rckTom/alturia-launch-control/firmware/lora_bench/README.md

# LoRa bench test

Ping/pong between two Heltec WiFi LoRa 32 V4 boards, to bring up the LoRa
backend in [`../common/lora/`](../common/lora/) before the satellite
hardware exists, and to run the secure link between a controller and a
satellite over the air (see [below](#secure-link-one-controller-one-satellite)).

Both boards run the same image. A board listens and answers every PING
with a PONG that carries the RSSI/SNR it heard the PING at. The pinging
board logs the round-trip time and the signal in both directions.

## Building and flashing

Zephyr has no V4 board, so this builds for the V3 and
[`boards/heltec_wifi_lora32_v3_esp32s3_procpu.overlay`](boards/heltec_wifi_lora32_v3_esp32s3_procpu.overlay)
adds what the V4 changes: the console on the native USB port, and the
RF front-end's control pins.

```sh
source ~/zephyrproject/venv/bin/activate
export ZEPHYR_BASE=~/zephyrproject/zephyr
west build -b heltec_wifi_lora32_v3/esp32s3/procpu -p always .
west flash --esp-device /dev/ttyACMx
```

The console and shell are on the same USB-C port, at any baud rate.

## Using it

Press **PRG** on one board to send 10 pings, 2 s apart; press it again to
stop. Or from the shell:

| Command | |
|---|---|
| `bench info` | Node id, frequency, SF, TX power, airtime |
| `bench ping [count] [interval_ms]` | Start a ping run (default 10, 2000 ms) |
| `bench stop` | End the run |
| `bench power [dBm]` | Show or set TX power at the antenna, up to 7 dBm |

A successful run looks like:

```
<inf> bench: ping 3: pong from 079c in 342 ms, there -41 dBm/10 dB, back -43 dBm/9 dB
```

"There" is the PING as heard by the other board, "back" is its PONG as
heard here. The white LED flashes on every transmission.

0 dBm is the most the SX1262 can report. Two boards on one desk read
exactly that, because the V4's LNA puts them well past it, and the V4
can't transmit below about 2 dBm. For a real reading, put the boards at
least a few metres apart with a wall between them, or take them outside.

The same is on the OLED, so the boards can be tested away from a laptop:

```
079c  KCT8103L (V4.3)      node id, detected front-end
869.850 SF7 +7dBm          radio settings
RX ping #12 from 3a41      last packet heard
  -45dBm 9dB  3s ago
PING 7/10  ok 6            ping run: sent/total, answered
  there -41dBm  9dB        last answered ping, both directions
  back  -43dBm 10dB
  rtt 342ms
```

If bring-up fails, the display shows which step and the error code. The
5x8 font is converted from X11's public-domain misc-fixed `5x8.bdf` by
[`tools/bdf_to_cfb.py`](tools/bdf_to_cfb.py); the built-in CFB fonts are
too large for more than four lines.

Keep the boards a metre or so apart. At short range the V4's LNA can push
the SX1262 input into compression, which shows up as lost packets with
good RSSI.

## Secure link: one controller, one satellite

The same image can also run either end of the real link, the code the
controller and satellite firmware use
([`../common/link/`](../common/link/), spec in
[`documentation/radio_link.md`](../../documentation/radio_link.md)). Give each
board a role once; it is kept in flash and the board reboots into it:

```
bench role ctrl      # on one board
bench role sat       # on the other; "bench role off" goes back to ping/pong
```

Changing the role erases the pairing. Then:

1. **Pair.** Hold **PRG** for a second on the satellite (pairing mode, 120 s),
   then on the controller (it pairs with the first satellite it hears).
   Both OLEDs show four rows of six boxes. If they are the same, press
   **PRG** on each board; if not, hold it. The log has the pattern too.
   Both switch to SF8 at low power while pairing. The satellite goes into
   slot 8, the last, so that `bench poll` can put phantom satellites
   ahead of it.
2. **Join.** Automatic, and again after either board reboots. The status
   line reads `link: joined`. From then on the controller polls the
   satellite twice a second, as the real controller does, and the
   satellite answers in its slot; that keeps the session up.
3. **Ping.** Press **PRG** on the controller, or `bench ping`. Odd pings go
   to the satellite alone, even ones as group broadcasts; the satellite
   answers each with a sealed pong.
4. **Poll.** `bench poll` sends polls and reports where each reply ends,
   counted from the end of the poll, against its slot. Phantoms are
   satellites that are not there, set in the mask ahead of ours to move
   our reply to a later slot.

| Command | |
|---|---|
| `bench role [off\|ctrl\|sat]` | Show or set the role (reboots) |
| `bench pair [uid] [slot]` | Satellite: pairing mode. Controller: pair with `uid` (0: the first one heard) into `slot` (default 8) |
| `bench scan [on\|off]` | Controller: log satellites in pairing mode |
| `bench confirm` / `bench reject` | The patterns match / differ (or cancel) |
| `bench unpair` | Forget the pairing |
| `bench replay` | Resend the last sealed DATA frame byte for byte, as an attacker would |
| `bench link` | Link state and why received frames were dropped |
| `bench ping`, `bench stop` | Sealed ping run |
| `bench poll [count] [interval_ms] [phantom_mask] [reply_len]` | Controller: polls, and where the replies land in their slots (default 20 every 250 ms) |
| `bench lbt` | Noise floor, busy threshold and the listen-before-talk counters |
| `bench jam <ms>` | Raw 255-byte frames back to back, without listening first |
| `bench jam slot [on\|off]` | Controller: a 200 ms raw frame right after each poll, to see the satellite skip a busy slot |
| `bench trace [off\|on\|hex]` | Log every frame sent and received, decoded; `hex` adds a dump |

`bench trace on` shows each frame's kind and clear header. Sealed
bodies stay encrypted, so a DATA frame shows only its key id and
counter:

```
<inf> trace: tx POLL         0 -> ff  net 33db kid 0 ctr 13, 33 B, sent in 50.9 ms
<inf> trace: rx DATA         8 -> 0   net 33db kid 0 ctr 14, 31 B, 0 dBm 13 dB, +45.7 ms
<inf> trace: rx HELLO        8 -> 0   net 33db, 5 B, -45 dBm 9 dB
<inf> trace: lbt busy: 0 dBm, floor -76 dBm
```

Address 0 is the controller, `ff` the group, and anything else a
satellite's slot. The last field is the time since the last poll, which
is where the reply slots count from; "sent in" is how long the send
blocked, airtime included. "lbt busy" lines are listens that found
someone on the air. Frames that fail the PHY CRC never reach the trace.

What to expect, with a 13-byte pong (31 B sealed, 36 ms on air, 43 ms
slots):

| Command | Result on the bench |
|---|---|
| `bench poll 50 250` | every reply ends at +45.7 to +46.4 ms, inside its slot (6–49 ms) |
| `bench poll 40 300 0x07` | slot 3 of 4: +174.8 to +175.3 ms |
| `bench poll 30 500 0x7f` | slot 7 of 8: +347.0 to +347.3 ms |
| `bench jam slot on`, then `bench poll 10 500 0x07` | no replies; the satellite's `bench lbt` counts every slot skipped busy |
| `bench jam 7000` on the satellite | the controller sends anyway after 50 ms of busy channel; it drops the session after 4 s, the satellite after 5 s; both rejoin as soon as the jam ends |

The first slot cannot be jammed this way: the jam starts a few ms after
the poll, after the satellite has listened.

Things worth trying: `bench replay` on the controller must count as
`replay` on the satellite and not answer; `bench unpair` on the satellite
must turn the controller's pings into drops there; a third board in
pairing mode shows a different pattern and must be rejected.

## Radio settings

Set in [`../common/lora/radio.c`](../common/lora/radio.c): 869.85 MHz,
SF7, 250 kHz, CR 4/5, 7 dBm at the antenna. 869.85 MHz is the centre of
the EU 869.70–870.00 MHz sub-band, which has no duty-cycle limit but
allows only 5 mW ERP, so `radio_set_tx_power()` caps the power at 7 dBm.
That assumes an antenna of at most 2.15 dBi; lower the cap by any gain
above that. Pairing uses SF8 at 0 dBm, so the two profiles don't hear
each other.

The radio runs on Zephyr's native SX126x driver, kept in standby between
operations (`CONFIG_LORA_MODULE_BACKEND_NATIVE`,
`CONFIG_LORA_SX126X_NATIVE_SLEEP=n`). With loramac-node, which sleeps the
chip after every call, each send took some 40 ms beyond its airtime, with
enough jitter to push replies out of their slots. The kernel runs at
10 000 ticks a second for the same reason.

At SF7 and 250 kHz a 22-byte sealed command is about 28 ms on air and a
63-byte status about 59 ms. Sensitivity is about −121 dBm, which leaves
roughly 20 dB of margin at 200 m with both antennas near the ground.

## The V4's RF front-end

The V4 puts a PA/LNA between the SX1262 and the antenna, and the part
depends on the board revision:

| Revision | Front-end | Pin driven high during TX | Net TX gain |
|---|---|---|---|
| V4.2 | GC1109 | IO46 (CPS, PA on) | ~11 dB |
| V4.3 | KCT8103L | IO5 (CTX) | ~13 dB |

On both, IO7 powers the front-end and IO2 enables it; DIO2 on the SX1262
switches the other TX/RX line itself. The firmware tells the revisions
apart at boot by the pull on IO2 and logs which one it found.
`radio_set_tx_power()` takes the power at the antenna and subtracts the
front-end gain. The gains are Meshtastic's measurements and hold only
below about 15 dBm into the PA.
