rckTom/alturia-launch-control/documentation/images/controller_front.jpg

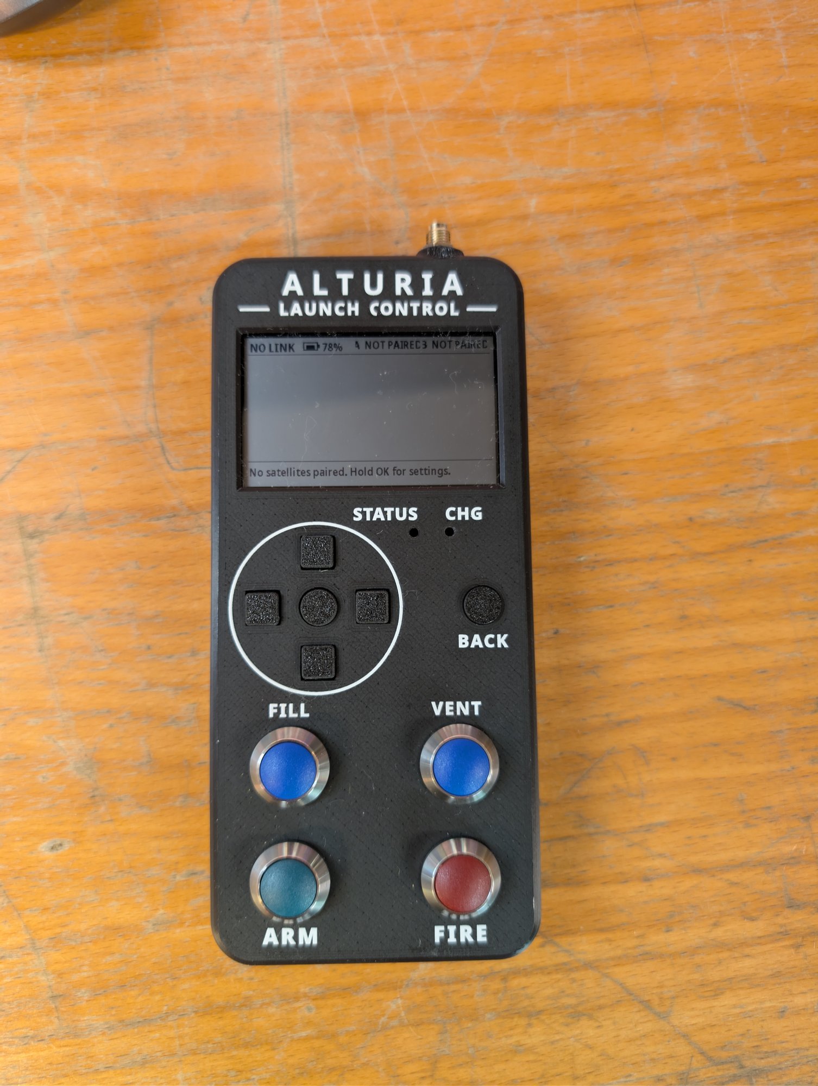
documentation/images/controller_front.jpg
