rckTom/alturia-launch-control/documentation/images/controller_open.jpg

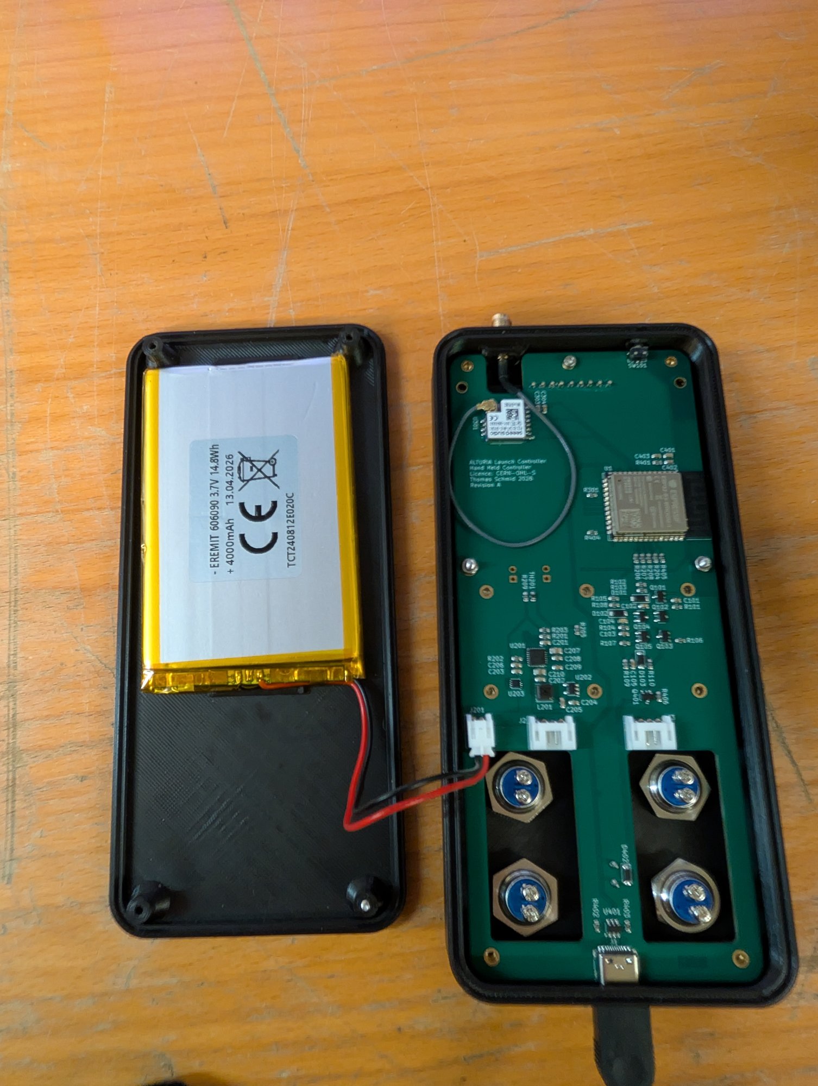
documentation/images/controller_open.jpg
