rckTom/alturia-launch-control/documentation/images/controller_pcb_bare.jpg

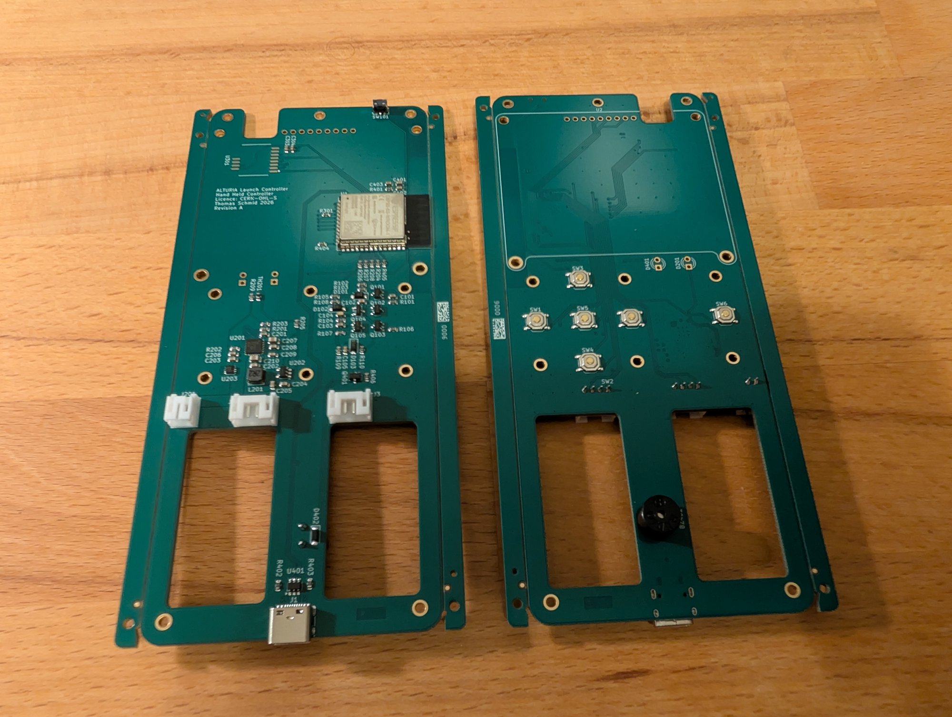
documentation/images/controller_pcb_bare.jpg
