rckTom/alturia-launch-control/documentation/images/satellite_battery.jpg

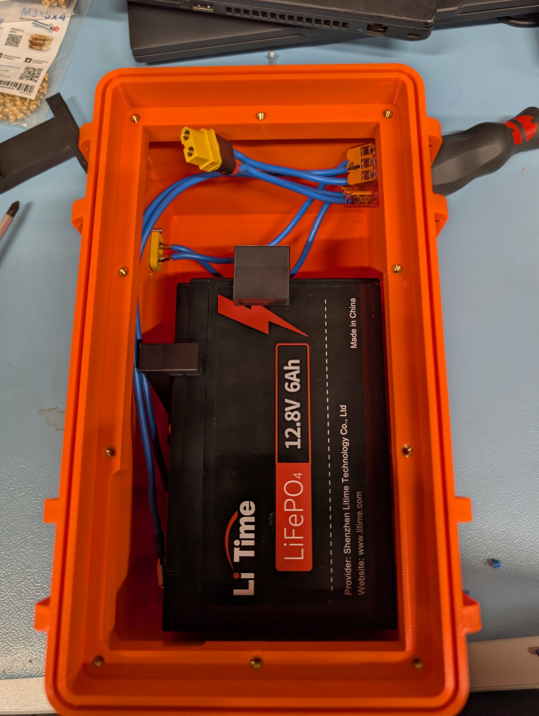
documentation/images/satellite_battery.jpg
