rckTom/alturia-launch-control/documentation/images/satellite_pcb_bare.jpg

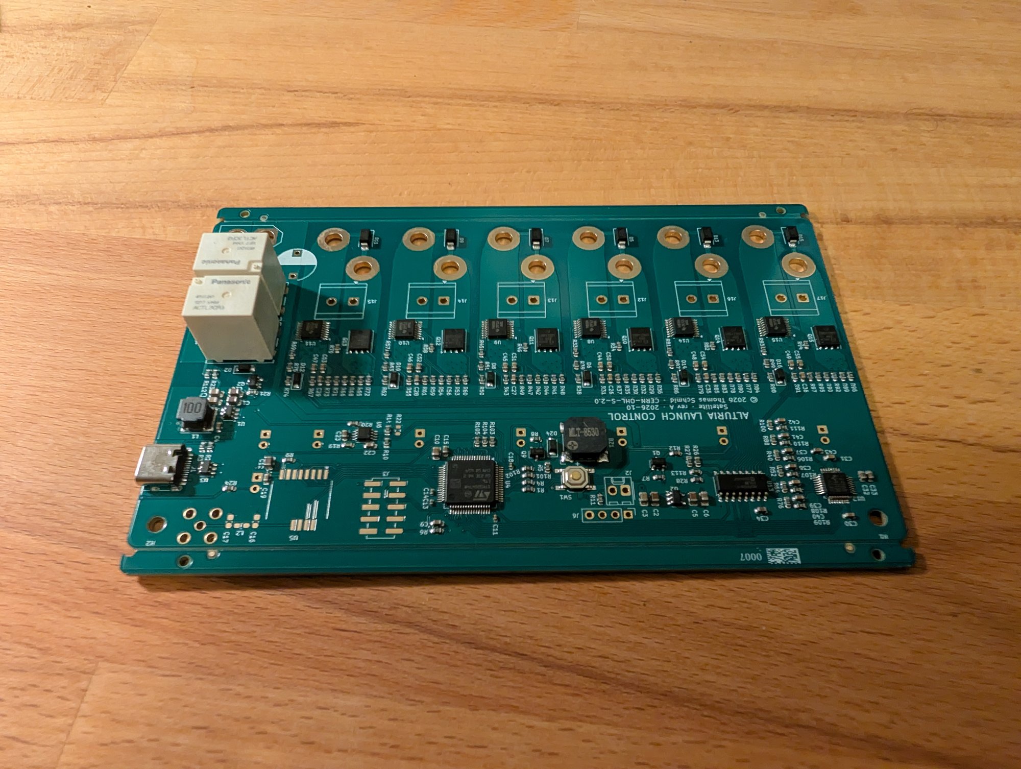
documentation/images/satellite_pcb_bare.jpg
