rckTom/alturia-launch-control/documentation/images/satellite_pcb_panel.jpg

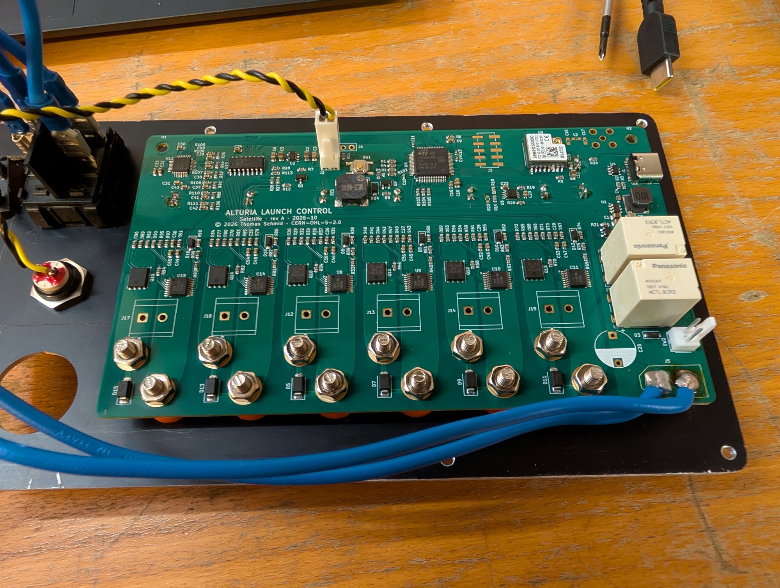
documentation/images/satellite_pcb_panel.jpg
