rckTom/alturia-launch-control/documentation/images/system_satellite_controller.jpg

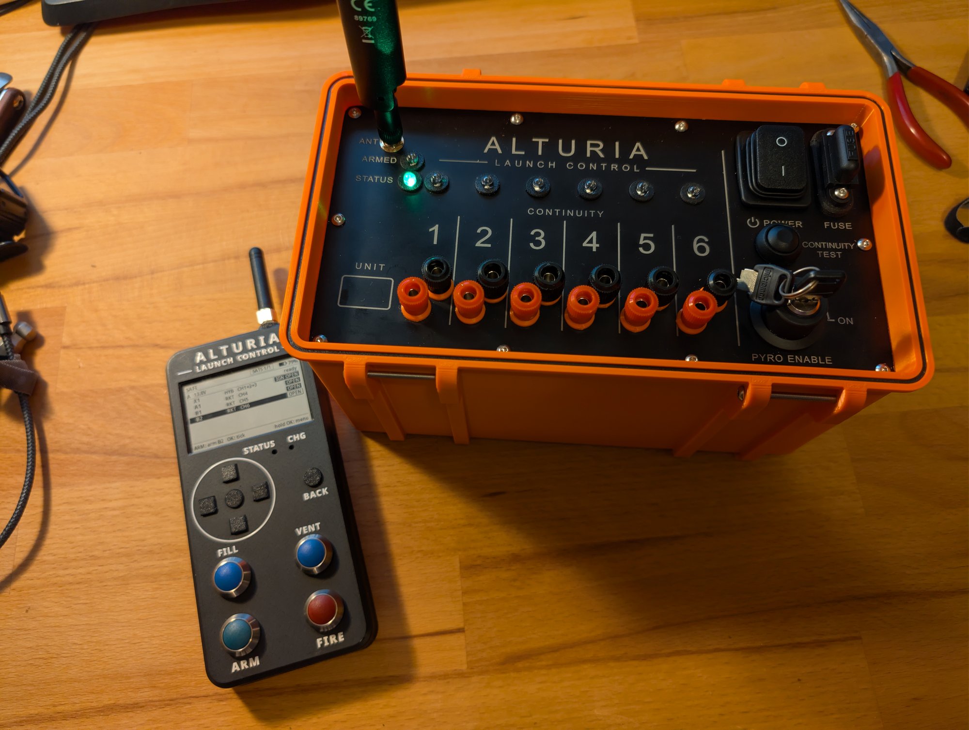
documentation/images/system_satellite_controller.jpg
