rckTom/alturia-launch-control/documentation/images/systemuebersicht.png

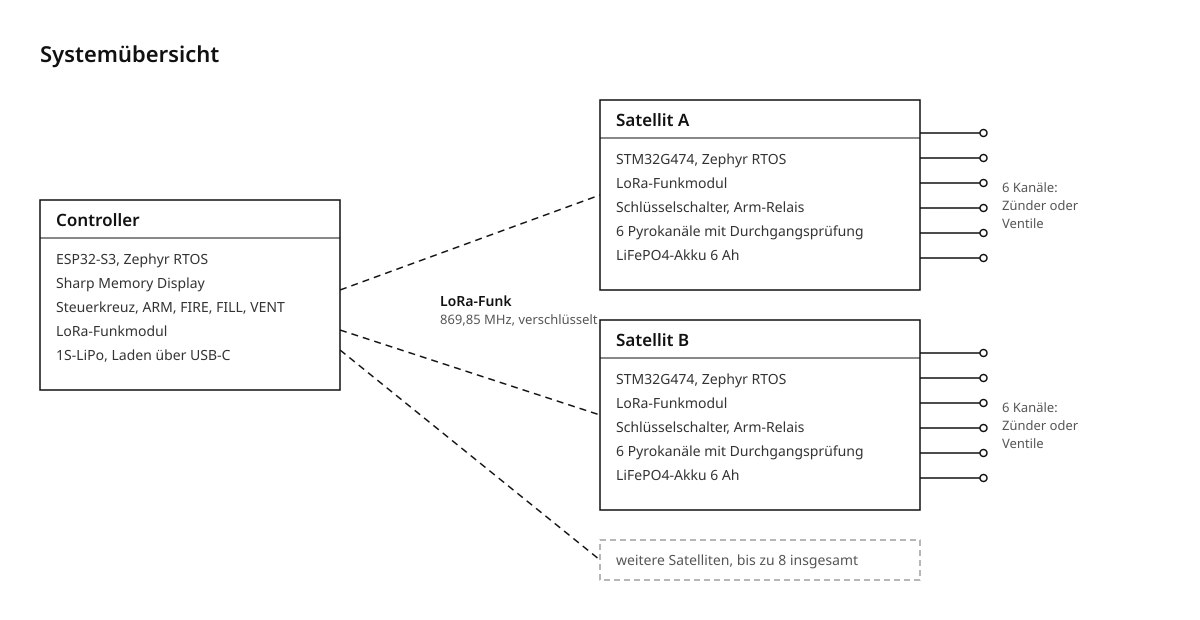
documentation/images/systemuebersicht.png
