rckTom/alturia-launch-control/documentation/images/zuendkreis.png

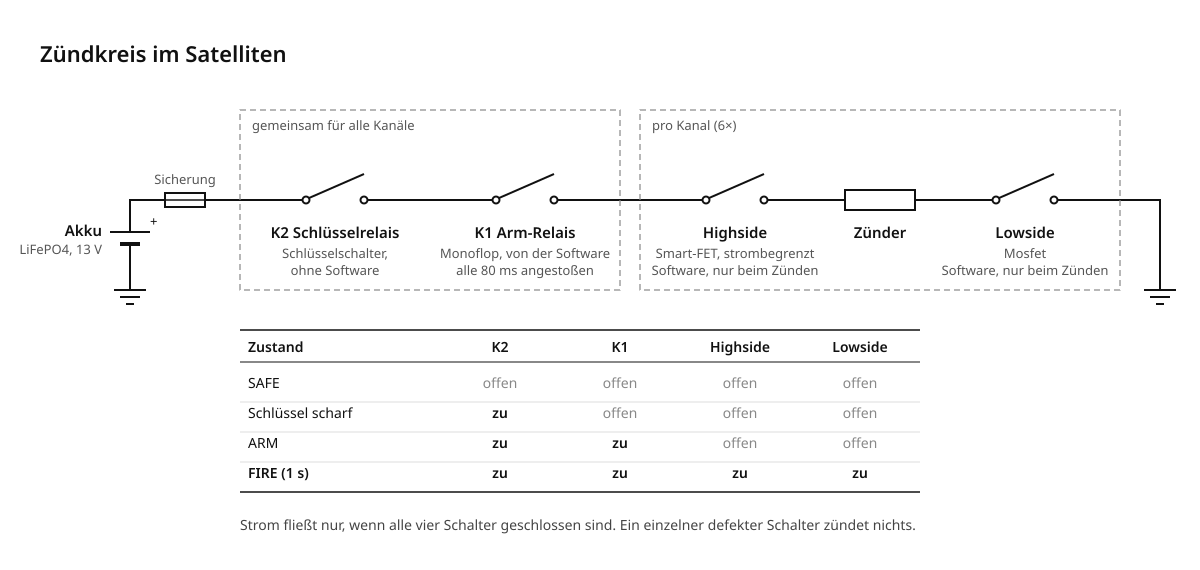
documentation/images/zuendkreis.png
