rckTom/alturia-launch-control/hardware/controller/cad/boot_section_side.png

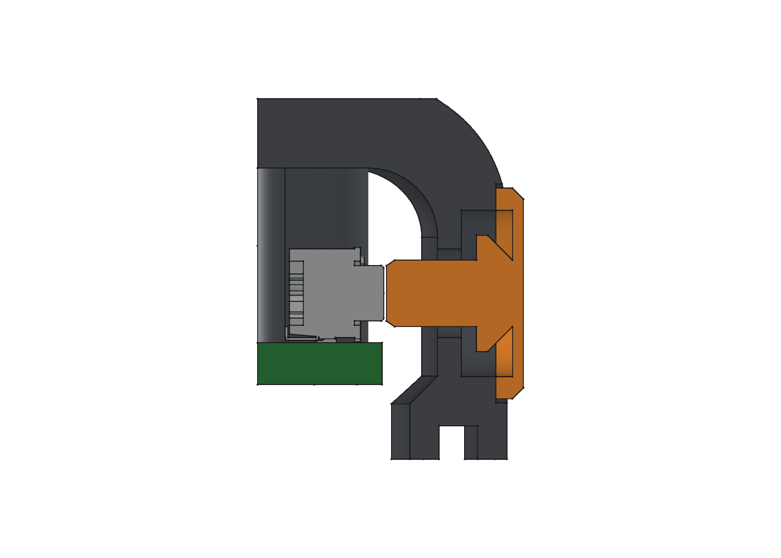
hardware/controller/cad/boot_section_side.png
