rckTom/alturia-launch-control/hardware/controller/cad/boot_section_top.png

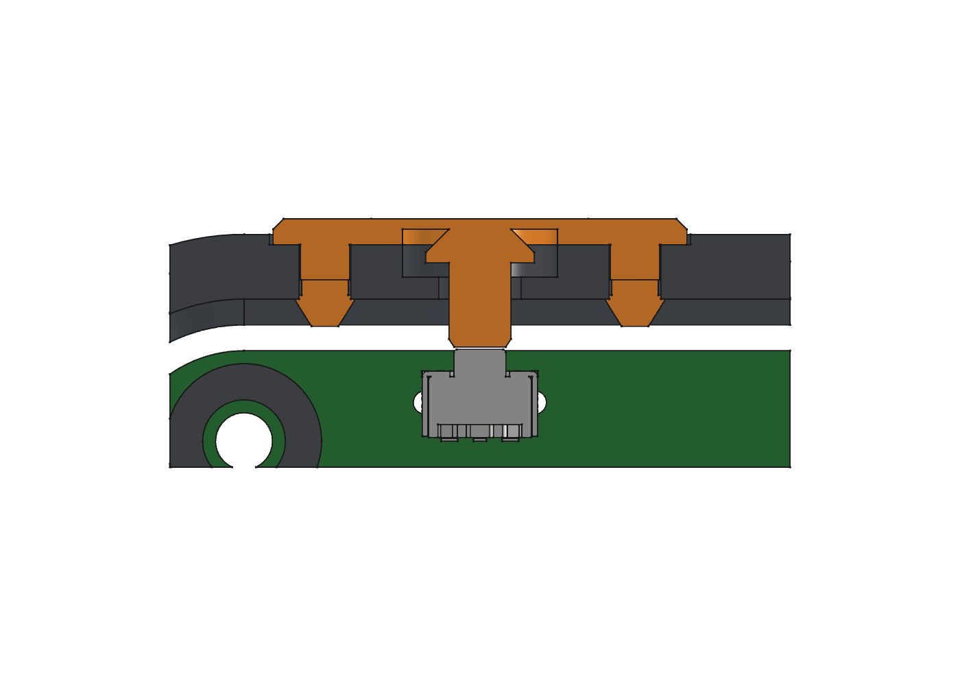
hardware/controller/cad/boot_section_top.png
