rckTom/alturia-launch-control/hardware/controller/cad/frontcase_engraving_preview.png

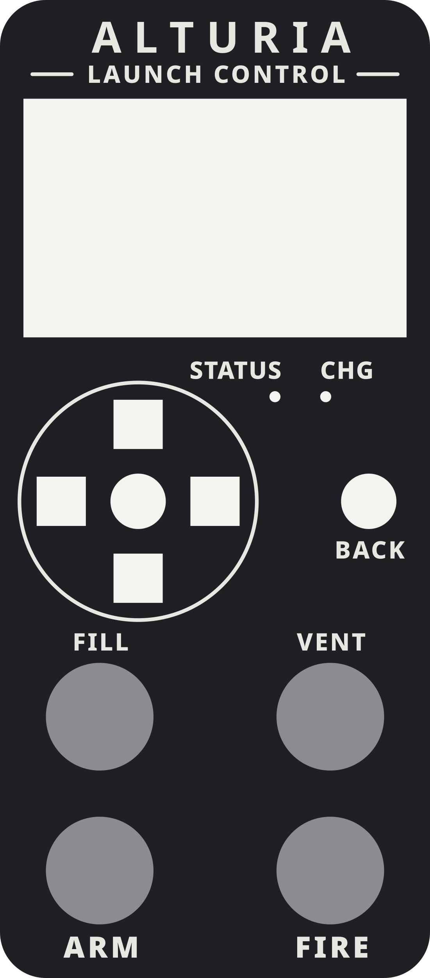
hardware/controller/cad/frontcase_engraving_preview.png
