rckTom/alturia-launch-control/hardware/controller/cad/frontcase_uvdtf_A3.png

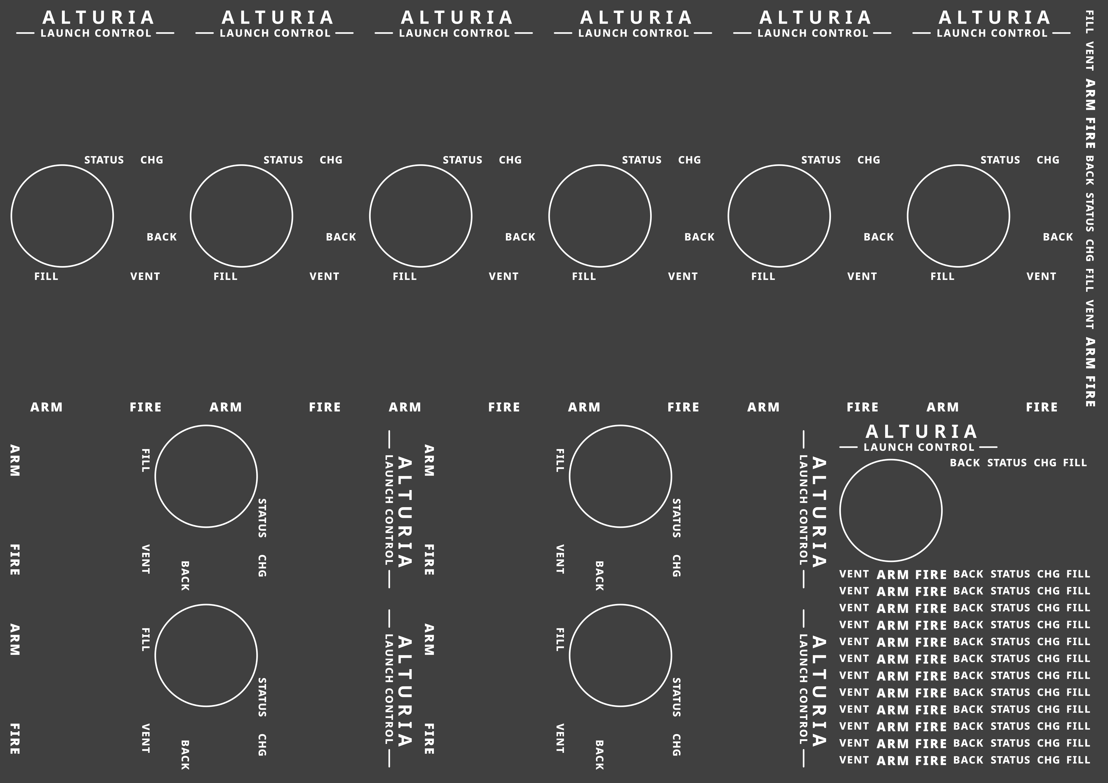
hardware/controller/cad/frontcase_uvdtf_A3.png
