rckTom/alturia-launch-control/hardware/controller/cad/frontcase_uvdtf_A3_preview.png

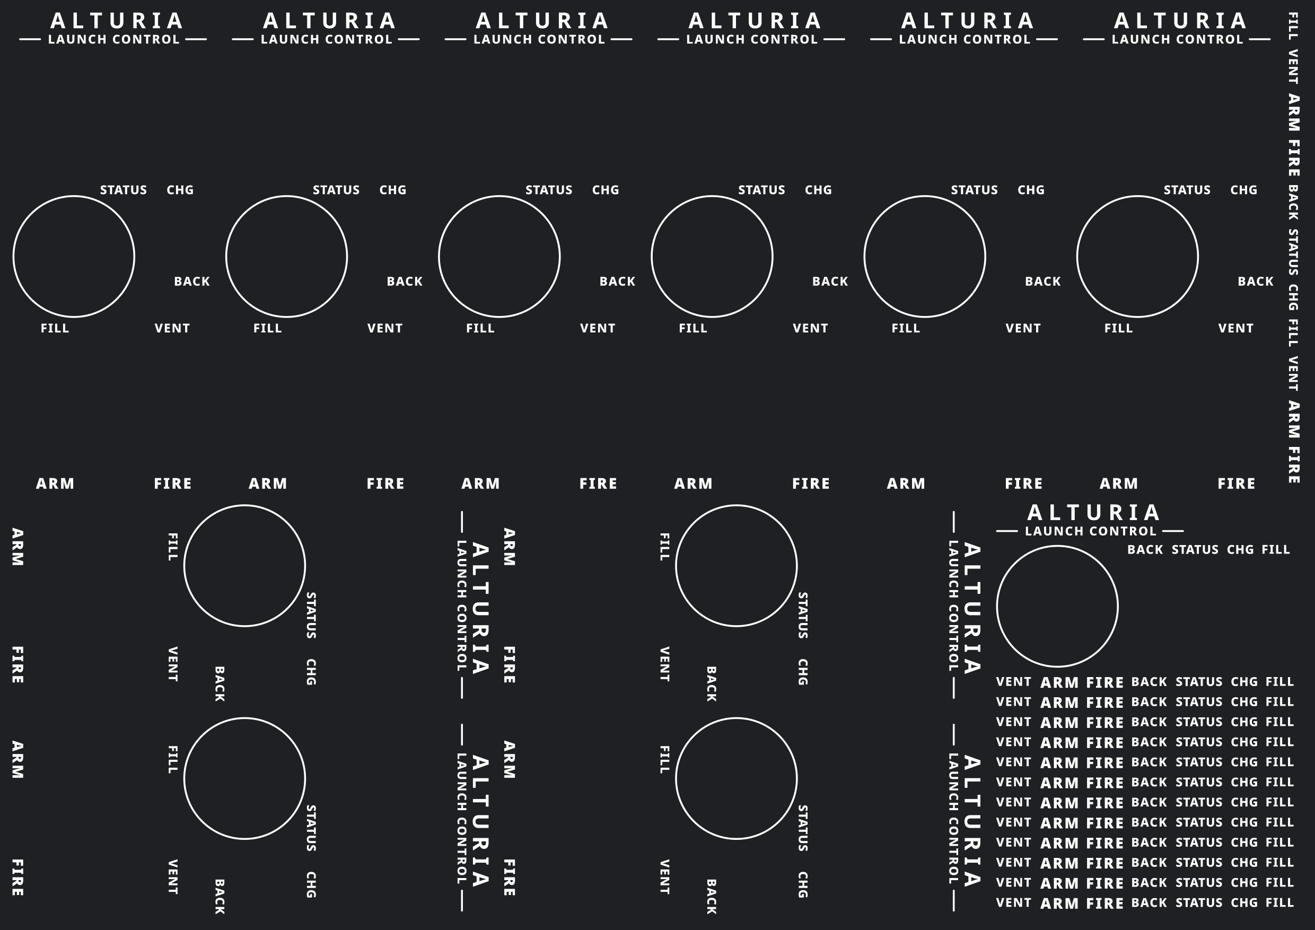
hardware/controller/cad/frontcase_uvdtf_A3_preview.png
