rckTom/alturia-launch-control/hardware/controller/cad/frontcase_uvdtf_A4.png

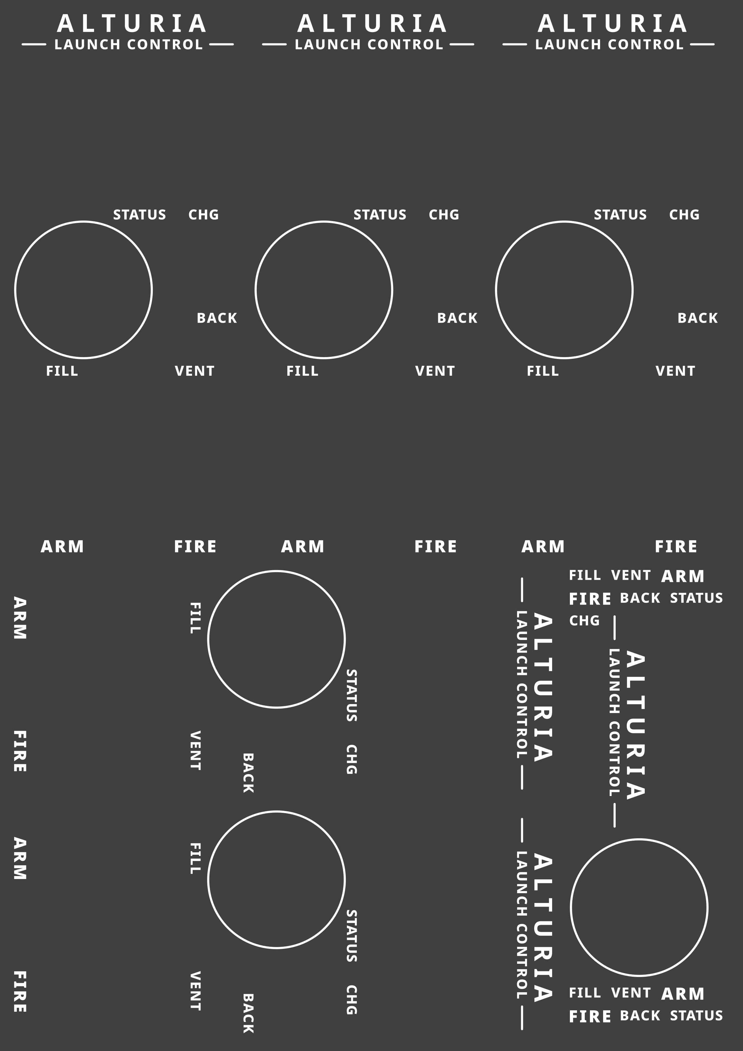
hardware/controller/cad/frontcase_uvdtf_A4.png
