rckTom/alturia-launch-control/hardware/controller/cad/frontcase_uvdtf_single.png

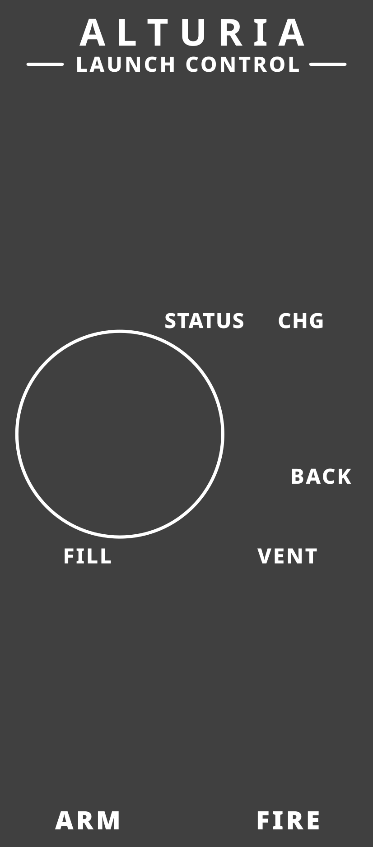
hardware/controller/cad/frontcase_uvdtf_single.png
