rckTom/alturia-launch-control/hardware/controller/cad/render/engraving.png

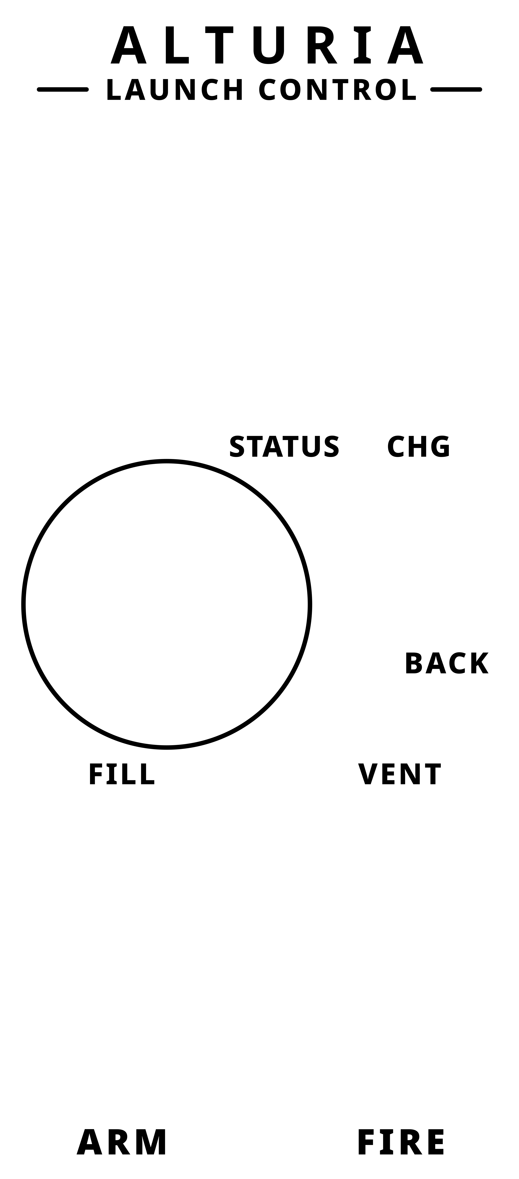
hardware/controller/cad/render/engraving.png
