rckTom/alturia-launch-control/hardware/controller/cad/render/render_detail.png

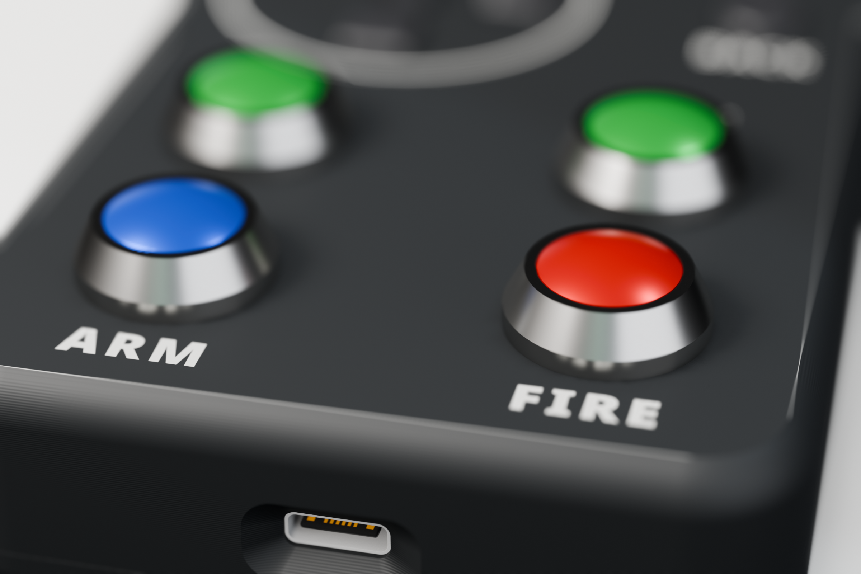
hardware/controller/cad/render/render_detail.png
