rckTom/alturia-launch-control/hardware/controller/cad/render/render_front.png

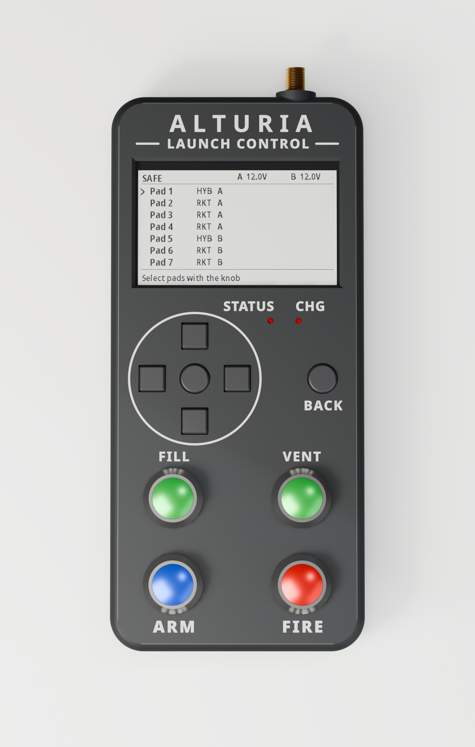
hardware/controller/cad/render/render_front.png
