rckTom/alturia-launch-control/hardware/controller/cad/render/render_top.png

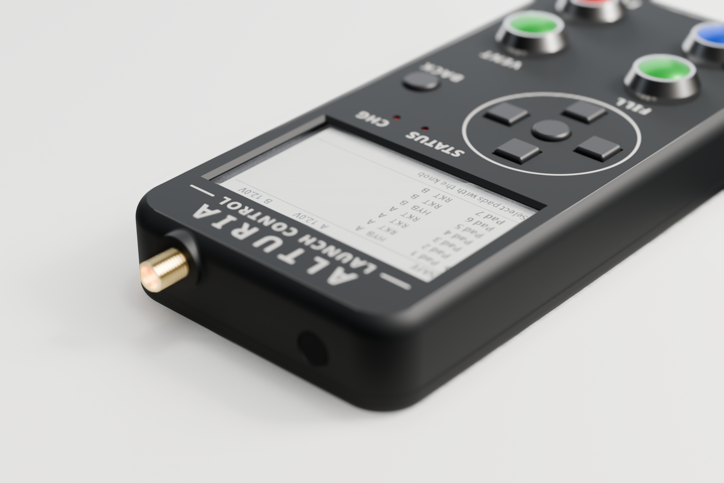
hardware/controller/cad/render/render_top.png
