rckTom/alturia-launch-control/hardware/controller/cad/render/screen.png

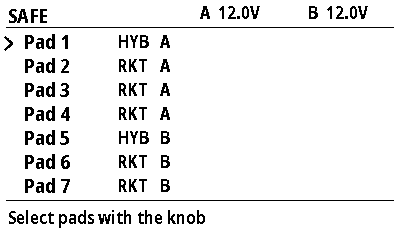
hardware/controller/cad/render/screen.png
