rckTom/alturia-launch-control/hardware/controller/sim/dpad_membrane_fem/seal_plate.png

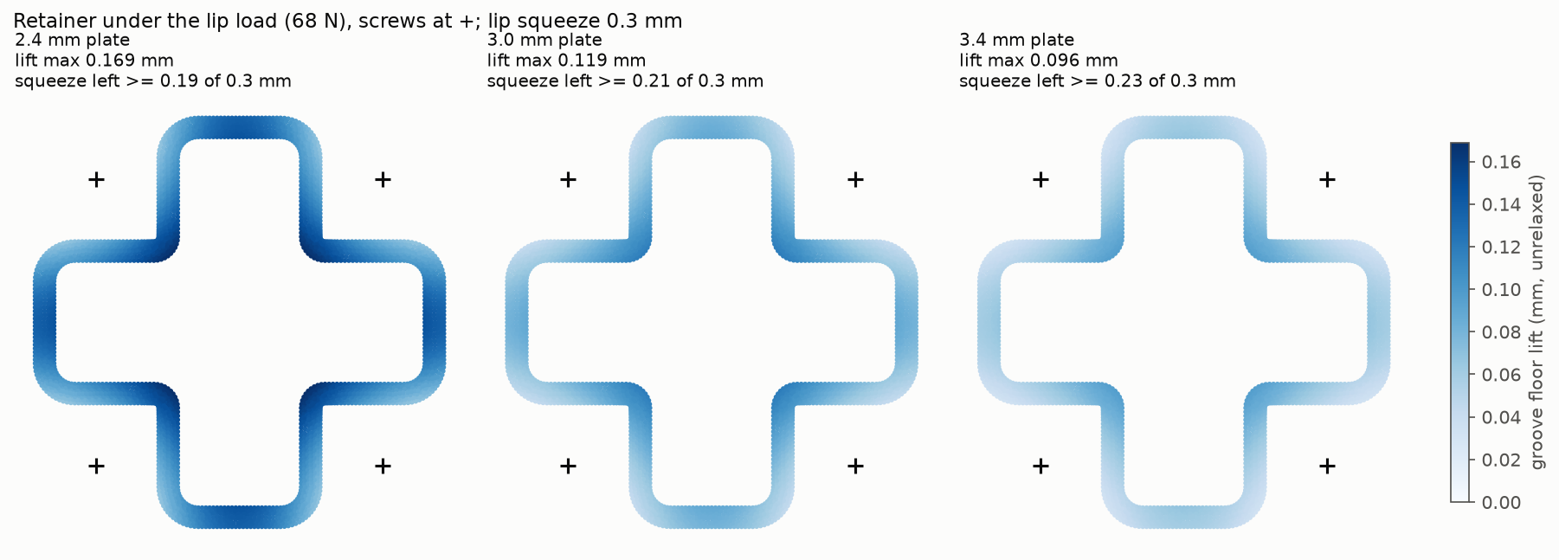
hardware/controller/sim/dpad_membrane_fem/seal_plate.png
