rckTom/alturia-launch-control/hardware/controller/sim/dpad_membrane_fem/web_force.png

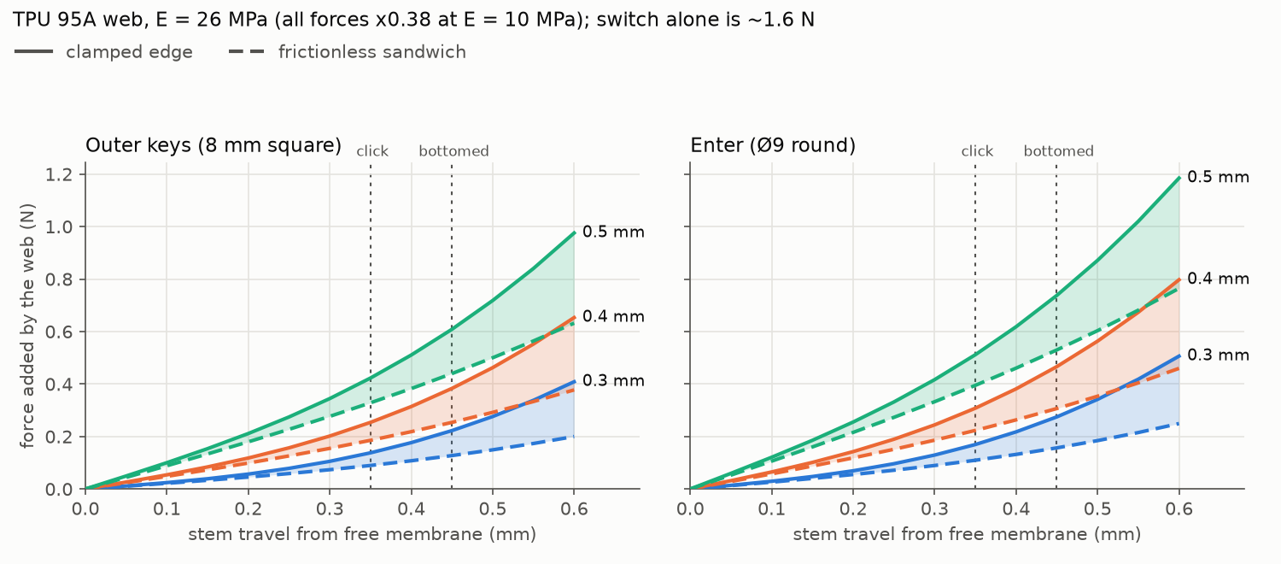
hardware/controller/sim/dpad_membrane_fem/web_force.png
