rckTom/alturia-launch-control/hardware/satellite/cad/frontpanel_engraving.png

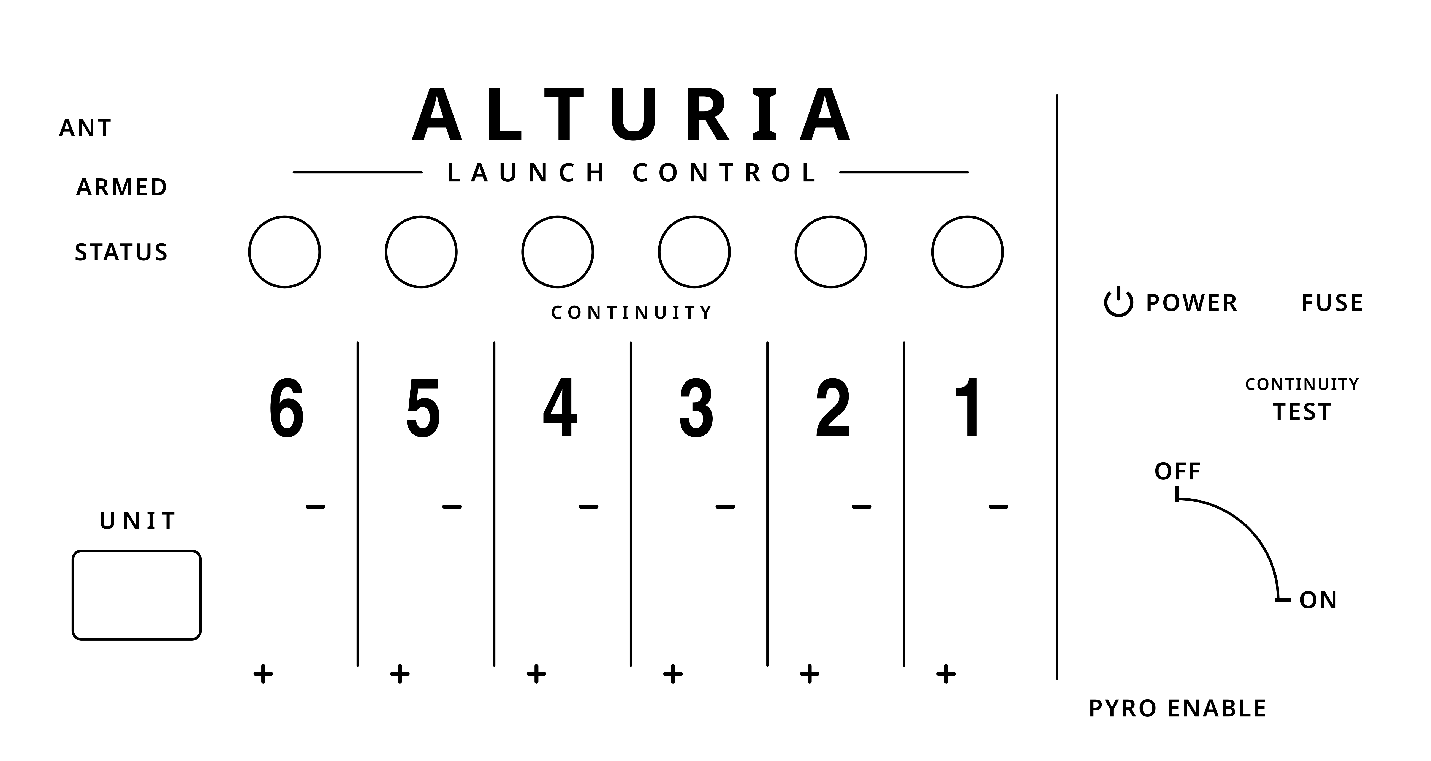
hardware/satellite/cad/frontpanel_engraving.png
