rckTom/alturia-launch-control/hardware/satellite/cad/frontpanel_engraving_preview.png

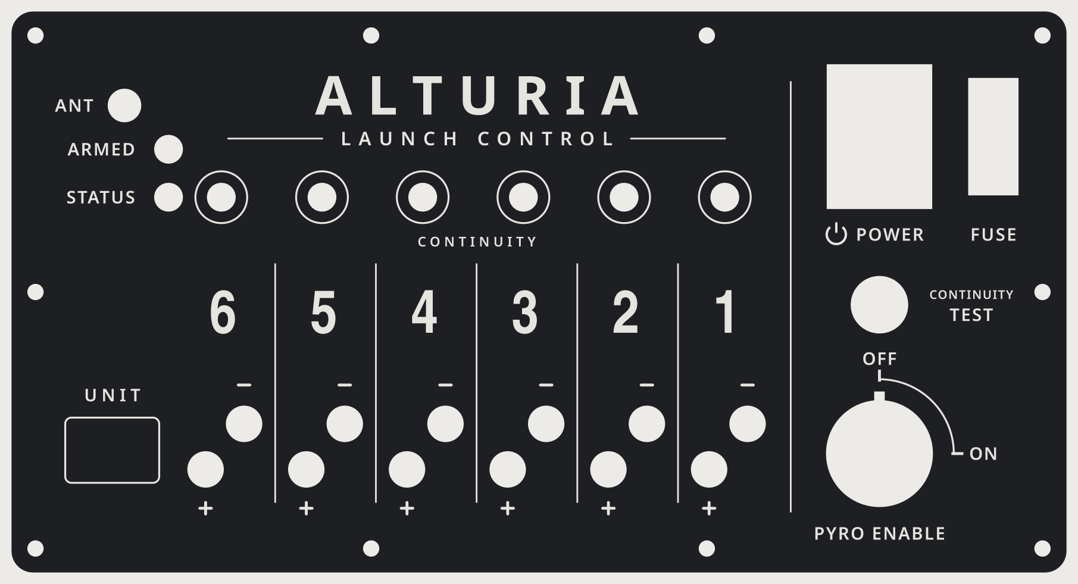
hardware/satellite/cad/frontpanel_engraving_preview.png
