rckTom/alturia-launch-control/hardware/satellite/cad/frontpanel_uvdtf_A3.png

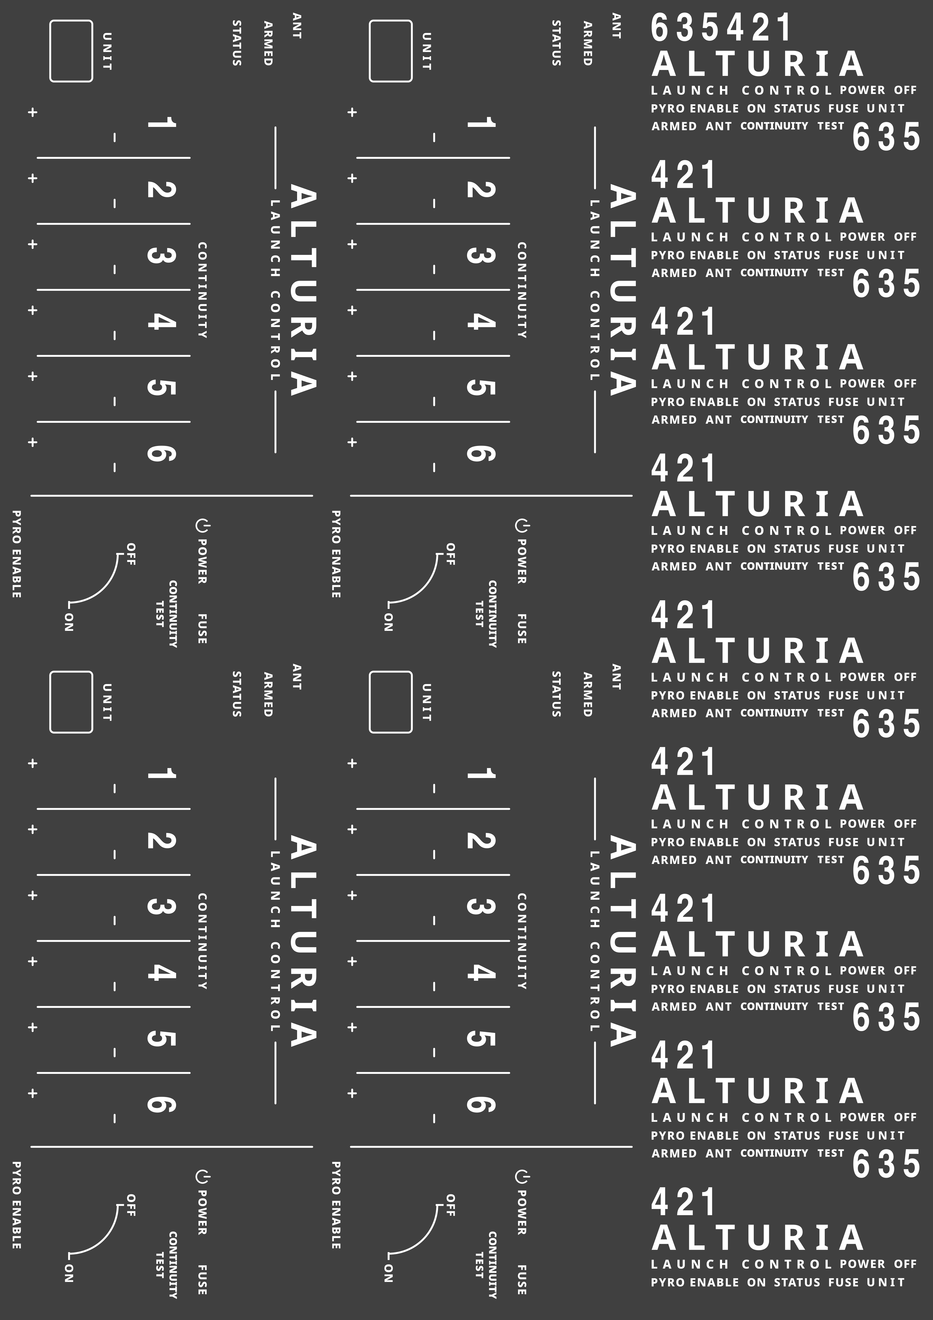
hardware/satellite/cad/frontpanel_uvdtf_A3.png
