rckTom/alturia-launch-control/hardware/satellite/cad/frontpanel_uvdtf_A4.png

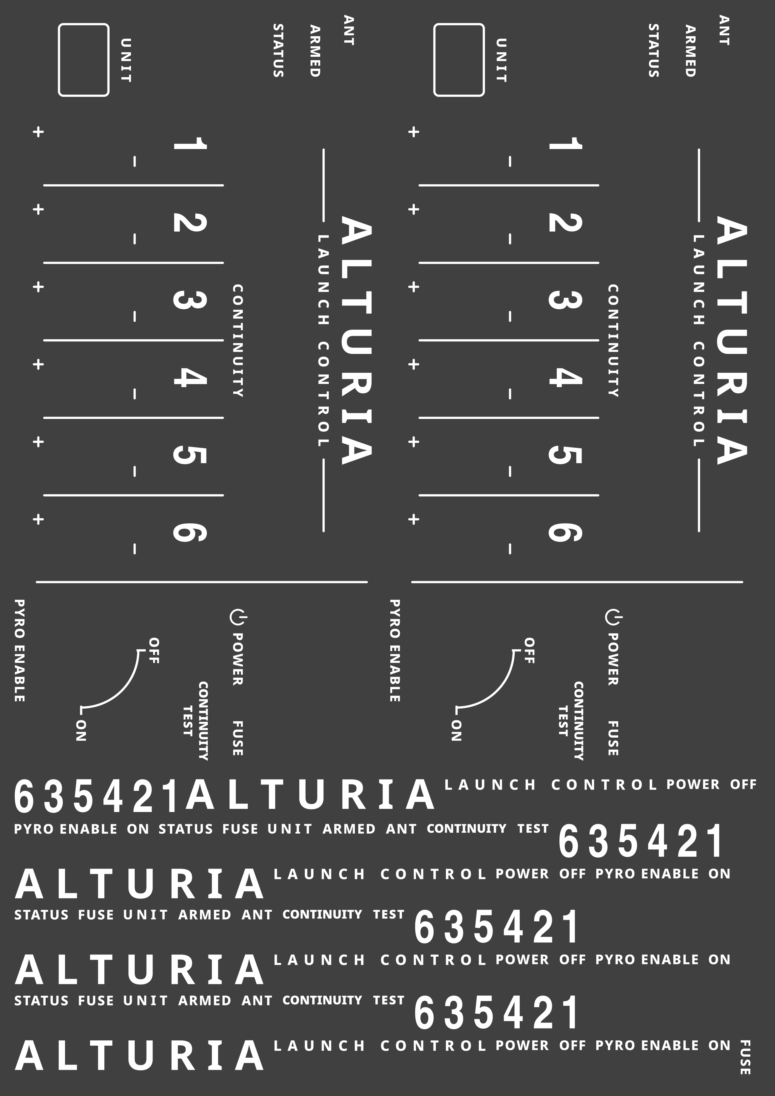
hardware/satellite/cad/frontpanel_uvdtf_A4.png
