rckTom/alturia-launch-control/hardware/satellite/cad/render/engraving.png

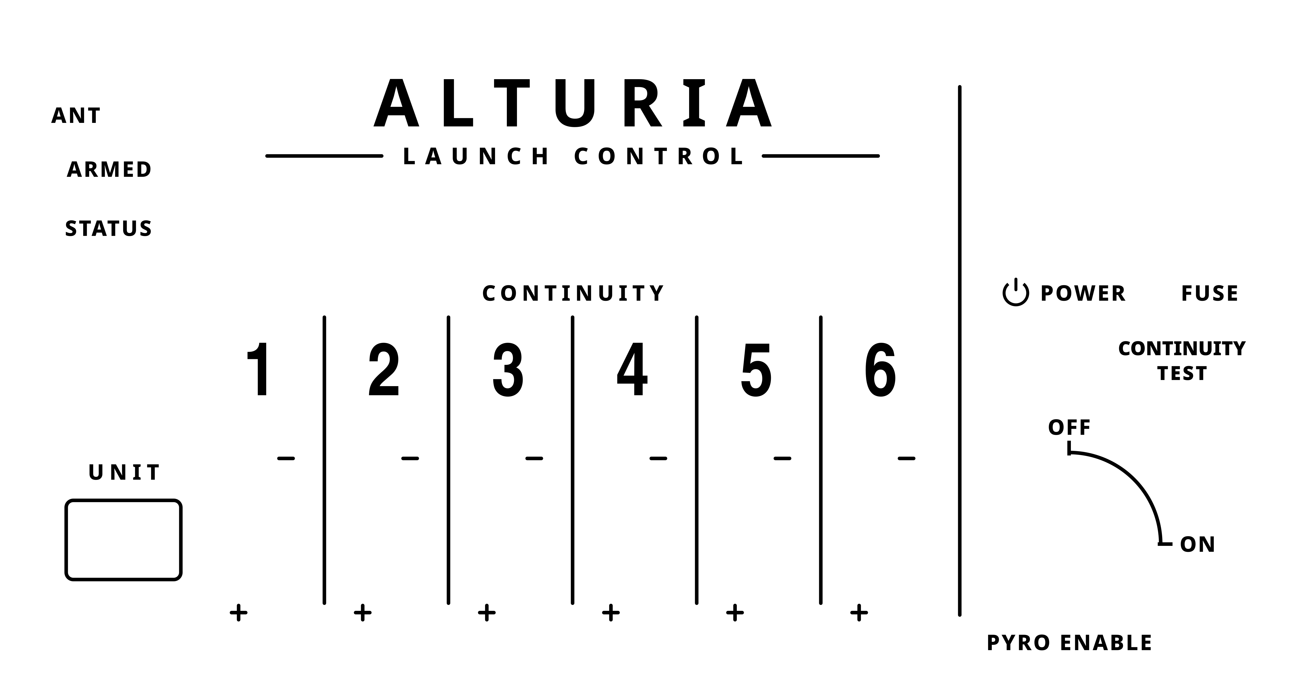
hardware/satellite/cad/render/engraving.png
