rckTom/alturia-launch-control/hardware/satellite/cad/render/render_detail.png

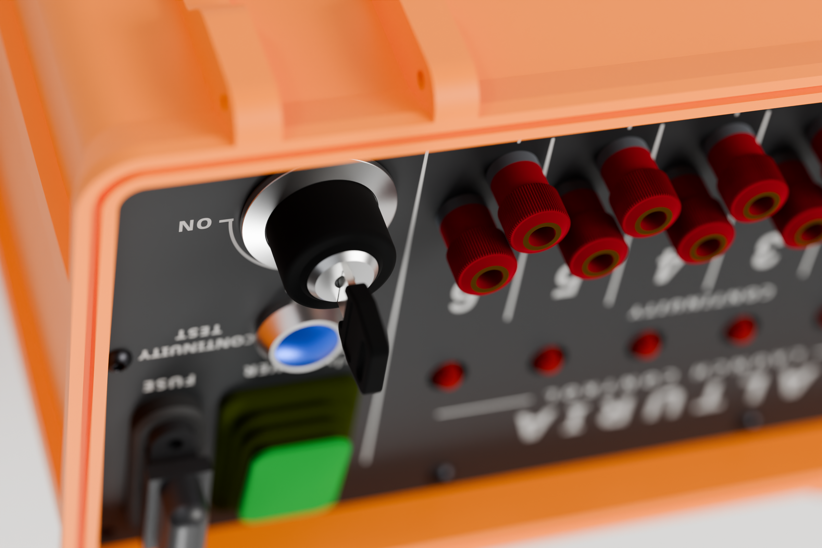
hardware/satellite/cad/render/render_detail.png
