rckTom/alturia-launch-control/hardware/satellite/cad/render/render_hero.png

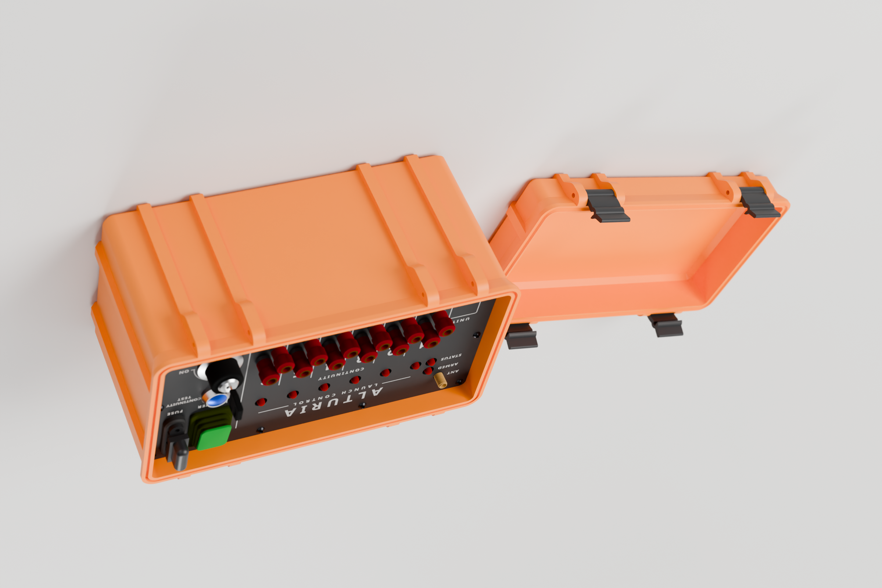
hardware/satellite/cad/render/render_hero.png
