rckTom/alturia-launch-control/hardware/controller/pcb/production/bom.csv

Designator | Footprint | Quantity | Value | LCSC Part #
BZ401 | BUZ-TH_BD9.0-P4.00-D0.6-FD | 1 | QMB-09B-03 | C96256
C101, C103, C304, C402 | 0603 | 4 | 100n | C14663
C102 | 0603 | 1 | 10n | C57112
C104 | 0603 | 1 | 47u | C140782
C105 | 0603 | 1 | 2.2u | C23630
C201, C206, C403 | 0603 | 3 | 1u | C15849
C202, C203, C204, C205, C303 | 0603 | 5 | 10u | C19702
C207, C210 | 0805 | 2 | 22u | C45783
C208 | 0603 | 1 | 4.7u | C19666
C209 | 0603 | 1 | 47n | C1622
C401 | 0603 | 1 | 22u | C59461
D101, D102, D103, D402 | D_SOD-123 | 4 | 1N4148W | C81598
J1 | USB_C_Receptacle_HRO_TYPE-C-31-M-12 | 1 | TYPE-C-31-M-12 | C165948
J2, J3 | JST_PH_S4B-PH-K_1x04_P2.00mm_Horizontal | 2 | Conn_01x04 | C157926
J201 | JST_PH_S2B-PH-K_1x02_P2.00mm_Horizontal | 1 | LiPo 1S | C173752
L201 | L_Taiyo-Yuden_NR-40xx | 1 | 2.2u | C135262
Q101 | SOT-23 | 1 | AO3401A | C15127
Q102, Q103, Q105, Q401 | SOT-23 | 4 | AO3400A | C20917
Q104 | SOT-23 | 1 | MMBT3904 | C20526
R101, R102, R106, R107, R204, R208, R406 | 0603 | 7 | 100k 1% | C25803
R103 | 0603 | 1 | 470k 1% | C23178
R104, R110, R201, R301, R401, R404 | 0603 | 6 | 10k 1% | C25804
R105, R109 | 0603 | 2 | 220k 1% | C22961
R108 | 0603 | 1 | 1M 1% | C22935
R202 | 0603 | 1 | 220 1% | C22962
R203, R402, R403 | 0603 | 3 | 5.1k 1% | C23186
R205 | 0603 | 1 | 1k 1% | C21190
R206, R207 | 0603 | 2 | 4.7k 1% | C23162
R209 | 0603 | 1 | 30k 1% | C22984
R405 | 0603 | 1 | 330 1% | C23138
SW1 | SW_Push_1P1T_XKB_TS-1187A | 1 | SW_Left | C318884
SW101 | SW_Push_1P1T-MP_NO_Horizontal_Alps_SKRTLAE010 | 1 | PWR | C110293
SW2 | SW_Push_1P1T_XKB_TS-1187A | 1 | SW_Right | C318884
SW3 | SW_Push_1P1T_XKB_TS-1187A | 1 | SW_Up | C318884
SW4 | SW_Push_1P1T_XKB_TS-1187A | 1 | SW_Down | C318884
SW5 | SW_Push_1P1T_XKB_TS-1187A | 1 | SW_Enter | C318884
SW6 | SW_Push_1P1T_XKB_TS-1187A | 1 | SW_Back | C318884
TH201 | 0603 | 1 | 10k B3435 | C2889048
U1 | ESP32-S3-WROOM-1 | 1 | ESP32-S3-WROOM-1-N16R2 | C2913205
U201 | Texas_RGE0024H_VQFN-24-1EP_4x4mm_P0.5mm_EP2.7x2.7mm_ThermalVias | 1 | BQ24296M | C130450
U202 | SOT-23-5 | 1 | TLV75733P | C485517
U203 | TDFN-8-1EP_2x2mm_P0.5mm_EP0.8x1.2mm | 1 | MAX17048G+T10 | C2682616
U301 | WIRELM-SMD_WIO-SX1262 | 1 | Wio-SX1262
U401 | SOT-23-6 | 1 | USBLC6-2SC6 | C2687116
