rckTom/alturia-launch-control/hardware/satellite/pcb/production/bom_jlcpcb.csv

Comment | Designator | Footprint | LCSC Part #
Buzzer | BZ1 | MagneticBuzzer_CUI_CMT-8504-100-SMT | C94599
10u | C1,C2,C5,C12,C20 | C_0805_2012Metric | C440198
1u | C3 | C_0805_2012Metric | C28323
100n | C4,C9,C19,C22,C26,C27,C28,C29,C30,C33,C35,C36,C37,C38,C39,C40,C41,C42,C43,C44,C45,C46,C47,C48,C49,C50,C51,C52,C53,C54,C55 | C_0603_1608Metric | C14663
2.2u | C6 | C_0805_2012Metric | C19110
22u | C7,C8 | C_0805_2012Metric | C45783
4.7uF | C10 | C_0805_2012Metric | C98195
100nF | C11,C13,C14,C18 | C_0402_1005Metric | C307331
1u | C15,C23,C32,C34 | C_0603_1608Metric | C5199872
330n | C31 | C_0603_1608Metric | C107070
1N4148W | D2,D3,D6,D8,D10,D12,D14,D16,D24 | D_SOD-123 | C81598
SS34 | D5,D7,D9,D11,D13,D15 | D_SMA | C8678
TYPE-C 16P | J1 | USB_C_Receptacle_HRO_TYPE-C-31-M-12 | C2765186
ACTL3CR3V | K1,K2 | RELAY-TH_ACTL3CR3 | C6118826
10uH | L1 | L_Cenker_CKCS6045 | C168076
AO3401A | Q1 | SOT-23 | C15127
AO3400A | Q2,Q9 | SOT-23 | C20917
CSD17307Q5A | Q10,Q11,Q12,Q13,Q14,Q15 | TDSON-8-1 | C139362
560 1% | R1,R4,R35,R47,R59,R71,R83,R95,R101,R102,R103,R104,R105 | R_0603_1608Metric | C23204
5.1k 1% | R2,R3 | R_0603_1608Metric | C23186
10k 1% | R5,R6,R7,R8,R9,R10,R11,R14,R21,R32,R33,R36,R44,R45,R48,R56,R57,R60,R68,R69,R72,R80,R81,R84,R92,R93,R96,R106,R107,R108,R109,R110,R111 | R_0603_1608Metric | C25804
270 | R12 | R_0603_1608Metric | C22966
150k 1% | R19 | R_0603_1608Metric | C22807
1k 1% | R20,R23,R27,R38,R40,R50,R52,R62,R64,R74,R76,R86,R88,R98,R100,R113 | R_0603_1608Metric | C21190
3k3 1% | R24,R26,R28,R39,R51,R63,R75,R87,R99,R112 | R_0603_1608Metric | C22978
100 1% | R29,R30,R31,R37,R41,R42,R43,R49,R53,R54,R55,R61,R65,R66,R67,R73,R77,R78,R79,R85,R89,R90,R91,R97 | R_0603_1608Metric | C22775
6k8 1% | R34,R46,R58,R70,R82,R94 | R_0603_1608Metric | C23212
BOOT0 | SW1 | SW_SPST_TL3342 | C318884
AP63203WU | U1 | TSOT-23-6 | C780769
TPS70933DBVR | U2 | SOT-23-5 | C89347
USBLC6-2SC6 | U3 | SOT-23-6 | C2687116
STM32G474RET6 | U4 | LQFP-64_10x10mm_P0.5mm | C521608
SN74LVC1G123 | U6 | SSOP-8_2.95x2.8mm_P0.65mm | C123302
TPS1HB08AQPWPRQ1 | U8,U9,U10,U11,U14,U15 | HTSSOP-16-1EP_4.4x5mm_P0.65mm_EP3.4x5mm_Mask2.78x3.37mm_ThermalVias03 | C3019223
ADS124S08IPBSR | U12 | TQFP-32_L5.0-W5.0-P0.50-LS7.0-TL | C2870171
MCP3208 | U13 | SOIC-16_3.9x9.9mm_P1.27mm | C626764
