rckTom/alturia-launch-control/hardware/controller/cad/ControllerAssembly.FCStd

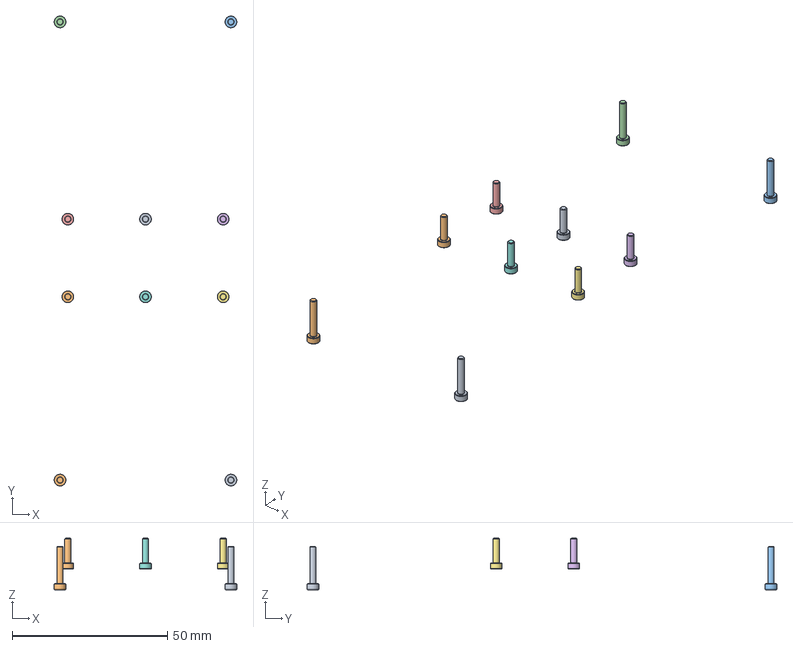
[picture p35: CAD file, 2026-11-05]
hardware/controller/cad/ControllerAssembly.FCStd
58.8 x 151.3 x 16.6 mm
M2x12-Screw
M2x12-Screw002
M2x12-Screw009
M2x12-Screw008
M2x8-Screw
M2x8-Screw011
M2x8-Screw012
M2x8-Screw013
M2x8-Screw014
M2x8-Screw010
