rckTom/alturia-launch-control/hardware/satellite/cad/SatelliteAssembly.FCStd

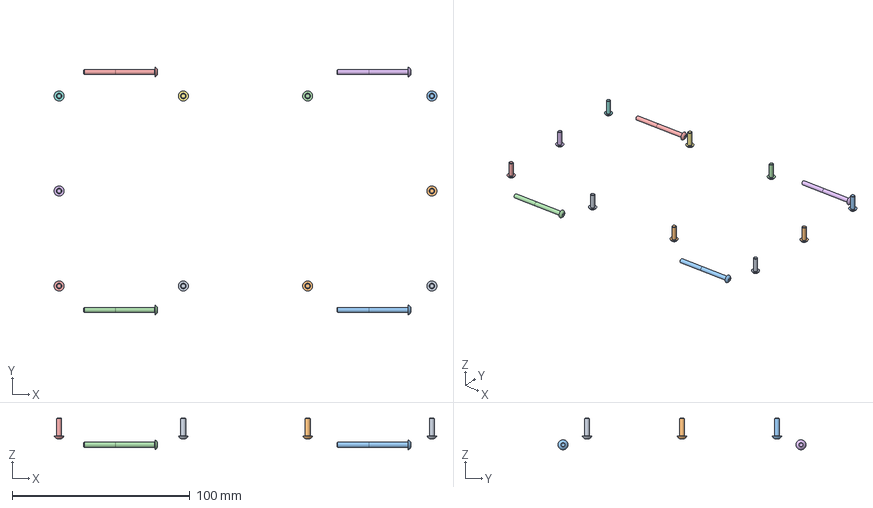
[picture p36: CAD file, 2026-11-05]
hardware/satellite/cad/SatelliteAssembly.FCStd
215.7 x 139.7 x 17.9 mm
M3x10-Screw
M3x10-Screw030
M3x10-Screw031
M3x10-Screw032
M3x10-Screw037
M3x10-Screw038
M3x10-Screw033
M3x10-Screw034
M3x10-Screw036
M3x10-Screw035
M3x40-Screw
M3x40-Screw002
M3x40-Screw005
M3x40-Screw006
