rckTom/alturia-launch-control/hardware/controller/cad/mesh/KeyCapSquare.stl

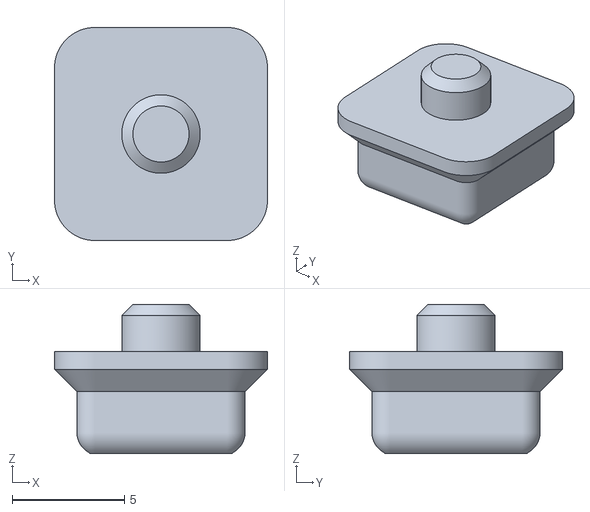
[picture p37: CAD file, 2026-11-01]
hardware/controller/cad/mesh/KeyCapSquare.stl
9.50 x 9.50 x 6.65
