rckTom/alturia-launch-control/hardware/controller/pcb/3d/SW_Push_1P1T_XKB_TS-1187A.step

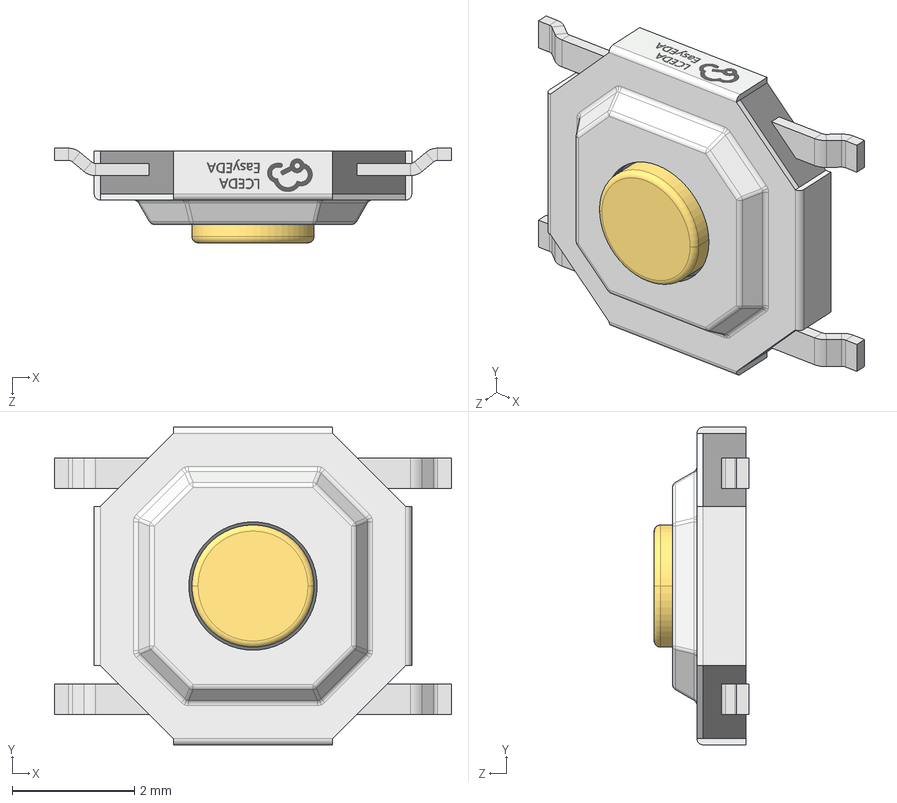
[picture p38: CAD file, 2026-10-11]
hardware/controller/pcb/3d/SW_Push_1P1T_XKB_TS-1187A.step
6.50 x 5.20 x 1.55 mm
