rckTom/alturia-launch-control/hardware/controller/pcb/controller.step

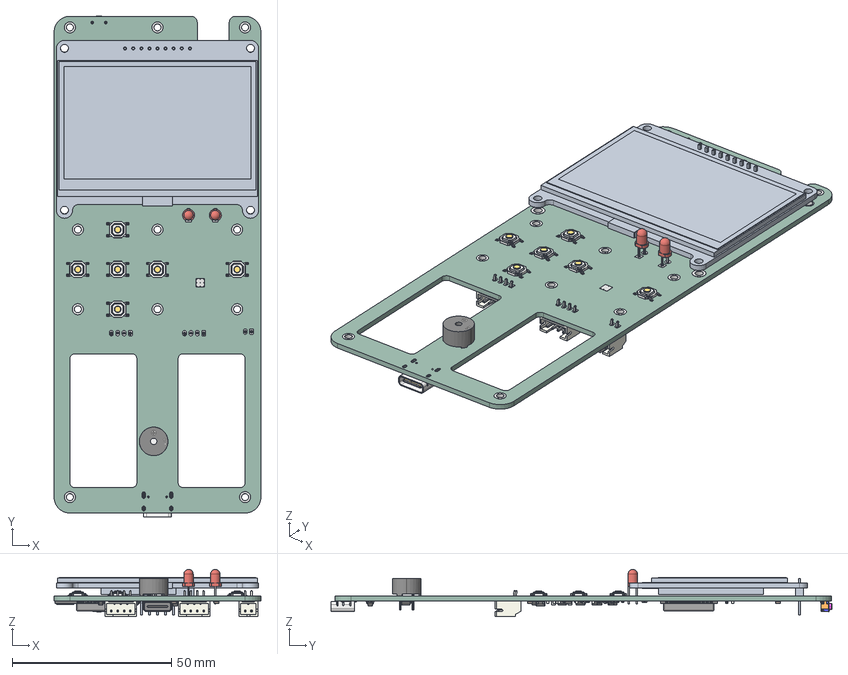
[picture p39: CAD file, 2026-11-01]
hardware/controller/pcb/controller.step
65.0 x 157.3 x 14.8 mm
SW-SMD_4P-L5.1-W5.1-P3.70-LS6.5-TL_H1.5 x 6
LED_D3.0mm x 2
BUZ-TH_D9.0-H5.5-P4.0
R_0603_1608Metric x 27
C_0603_1608Metric x 18
Texas_RGE0024H_VQFN-24-1EP_4x4mm_P0.5mm_EP2.7x2.7mm
JST_S4B_PH_K x 2
D_SOD-123 x 4
SOT-23 x 6
SOT-23-5
C_0805_2012Metric x 2
USB-C_SMD-TYPE-C-31-M-12
SOT-23-6
ESP32-S3-WROOM-1
JST_S2B_PH_K
controller-unsaved-export-pzd7oC_pad
controller-unsaved-export-pzd7oC_PCB
