rckTom/alturia-launch-control/hardware/parts/HeatSetInserts.FCStd

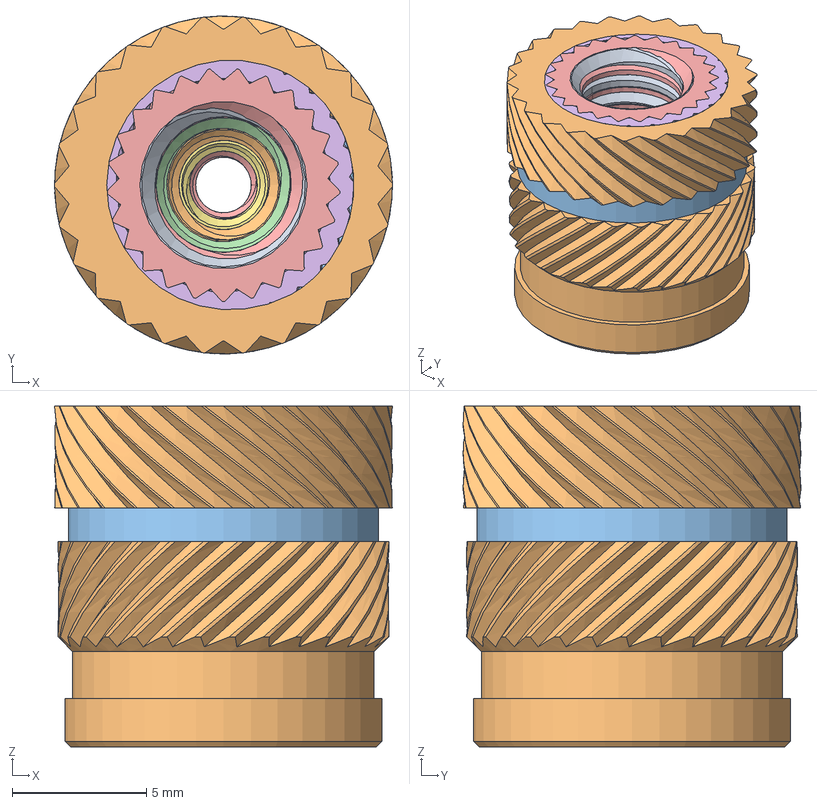
[picture p40: CAD file, 2026-11-05]
hardware/parts/HeatSetInserts.FCStd
12.6 x 12.6 x 12.7 mm
Insert_14-20 v1
G1/8-28 v1
Insert_M10 v1
Insert_M2 v2
Insert_M2p5_Short v1
Insert_M3 v1
Insert_M3 v001
Insert_M3_VORON v5
Insert_M4_Short v1
Insert_M4 v3
Insert_M5_Short v0
Insert_M5 v2
Insert_M6 v2
Insert_M8 v1
