rckTom/alturia-launch-control/hardware/satellite/cad/mesh/BatteryClamp.stl

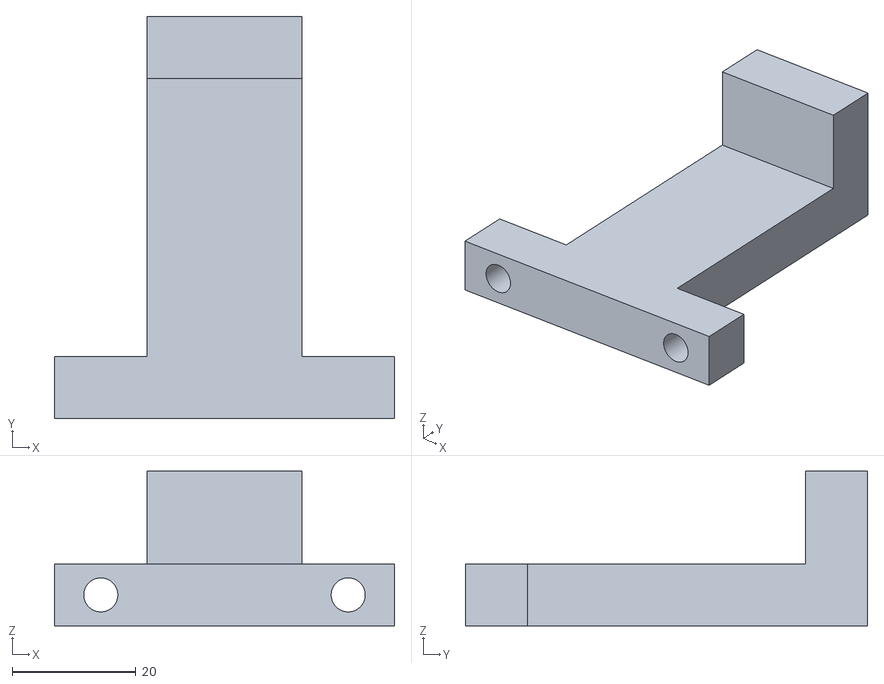
[picture p41: CAD file, 2026-11-05]
hardware/satellite/cad/mesh/BatteryClamp.stl
55.0 x 65.0 x 25.0
