rckTom/alturia-launch-control/hardware/satellite/cad/ParametricCase.FCStd

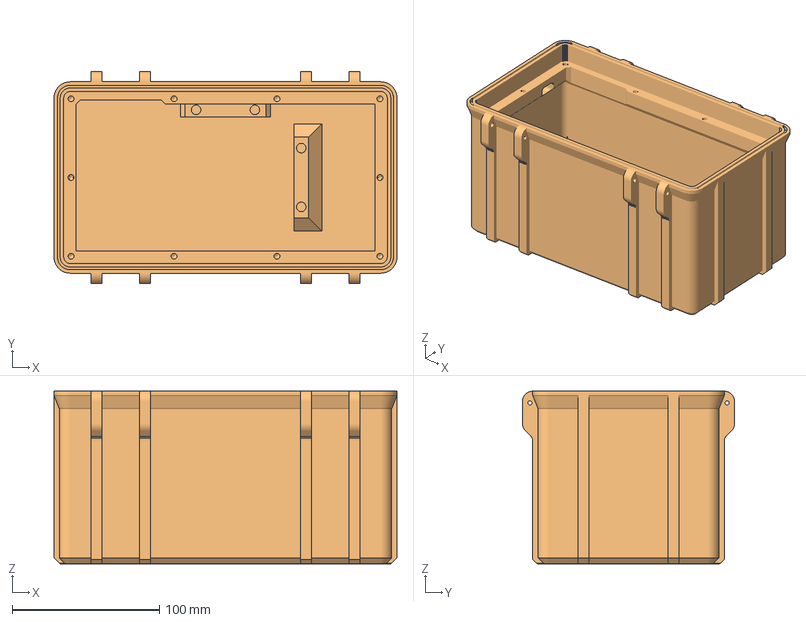
[picture p42: CAD file, 2026-11-05]
hardware/satellite/cad/ParametricCase.FCStd
233.2 x 144.2 x 117.4 mm
Body001 (Meshed)001
