rckTom/alturia-launch-control/hardware/satellite/pcb/satellite.step

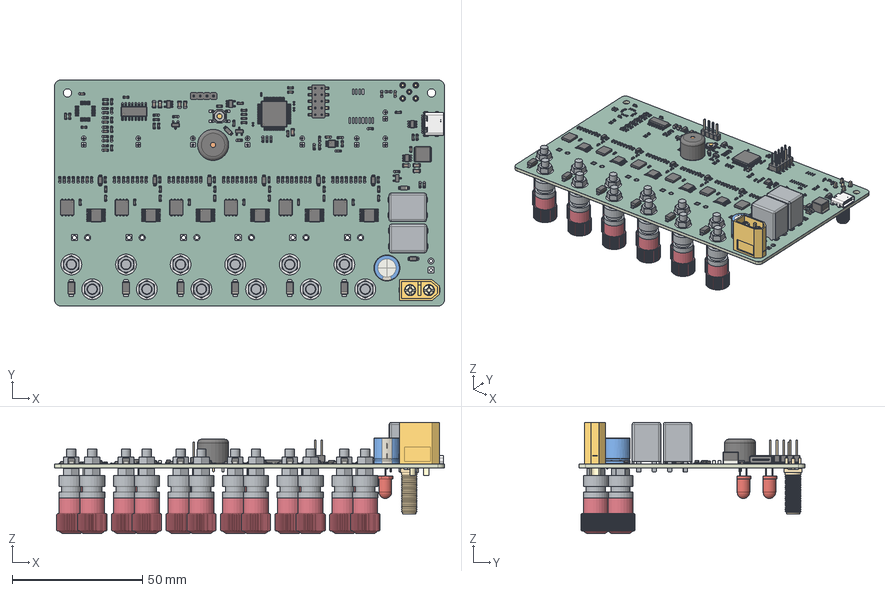
[picture p43: CAD file, 2026-10-06]
hardware/satellite/pcb/satellite.step
150.0 x 87.0 x 42.8 mm
R_0603_1608Metric x 106
D_SMA x 6
C_0805_2012Metric x 8
HTSSOP-16-1EP_4.4x5mm_P0.65mm_EP3.4x5mm_Mask2.78x3.37mm x 6
D_SOD-123 x 9
Buzzer_12x95RM76
C_0603_1608Metric x 25
LQFP-64_10x10mm_P0.5mm
TDSON_8_1 x 6
XT60 male v9
SOT-23-5 x 2
TSOT-23-6
SOT-23 x 3
PinHeader_1x04_P254mm_Vertical
PinHeader_2x05_P254mm_Vertical_SMD
L_Cenker_CKCS6045
C_0402_1005Metric x 4
CP_Radial_D100mm_P750mm
L_0603_1608Metric
SSOP-8_2.95x2.8mm_P0.65mm
SOIC-16_3.9x9.9mm_P1.27mm
USB-C_SMD-TYPE-C-31-M-12
SW_SPST_TL3342
SOT-23-6
Base x 12
(M3.5)-Nut x 24
LED_D5.0mm x 8
SMA_Amphenol_132291_Vertical
satellite-unsaved-export-sMCbMG_pad
satellite-unsaved-export-sMCbMG_soldermask x 2
satellite-unsaved-export-sMCbMG_PCB
