rckTom/alturia-launch-control/hardware/controller/cad/controller_mockup.FCStd

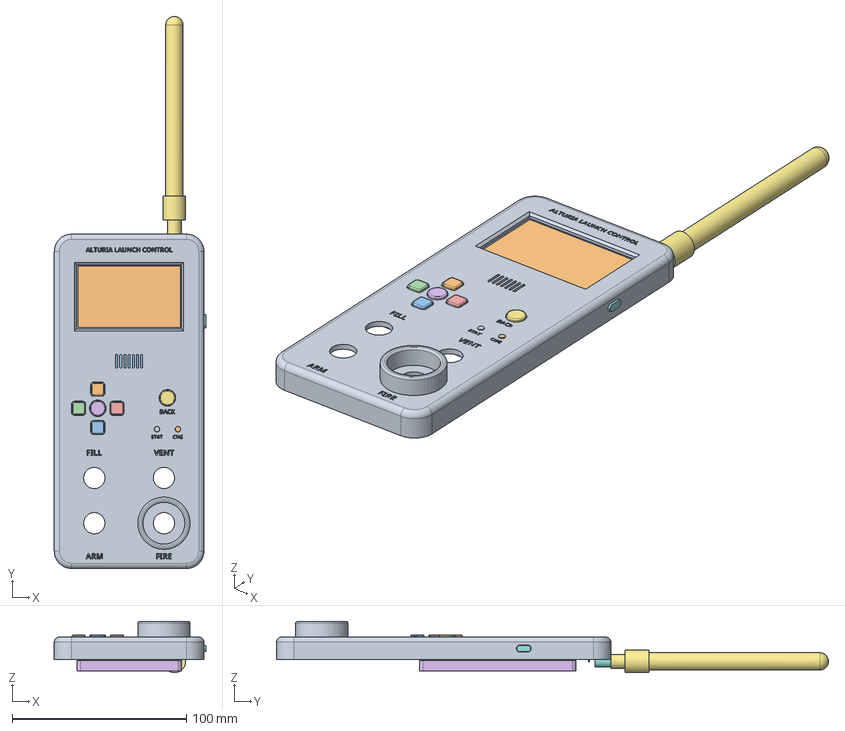
[picture p44: CAD file, 2026-11-05]
hardware/controller/cad/controller_mockup.FCStd
87.0 x 317.0 x 29.5 mm
FrontShell
Key_Up
Key_Down
Key_Left
Key_Right
Key_Enter
Key_Back
Key_Power
LightPipe_STAT
LightPipe_CHG
ControllerPCB
ESP32_S3_WROOM_1
Wio_SX1262
TS1187A__18_89
TS1187A__18_111
TS1187A__29_100
TS1187A__7_100
TS1187A__18_100
TS1187A_22_94
SideSwitch_Power
USB_C
LiPo
Display_PCB
Display_LCD_glass
Display_Polarizer_border
Display_Active_area
Display_FPC
Display_Rear_parts_keepout
Display_Header_body
Display_Header_pins
Antenna
SMA_bulkhead
