rckTom/alturia-launch-control/hardware/controller/cad/mesh/DistanceTubeDisplay.stl

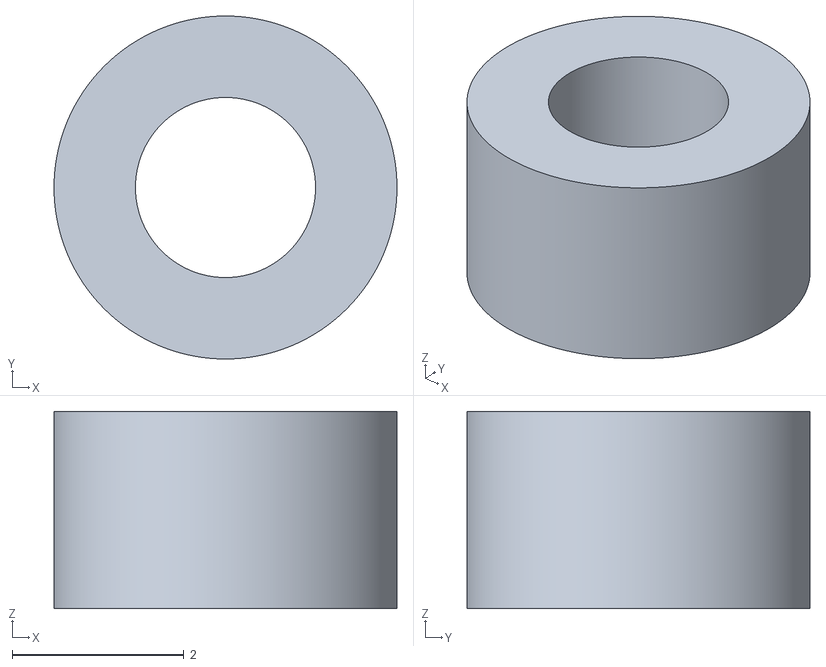
[picture p45: CAD file, 2026-11-01]
hardware/controller/cad/mesh/DistanceTubeDisplay.stl
4.00 x 4.00 x 2.30
