rckTom/alturia-launch-control/hardware/controller/pcb/3d/BUZ-TH_D9.0-H5.5-P4.0.step

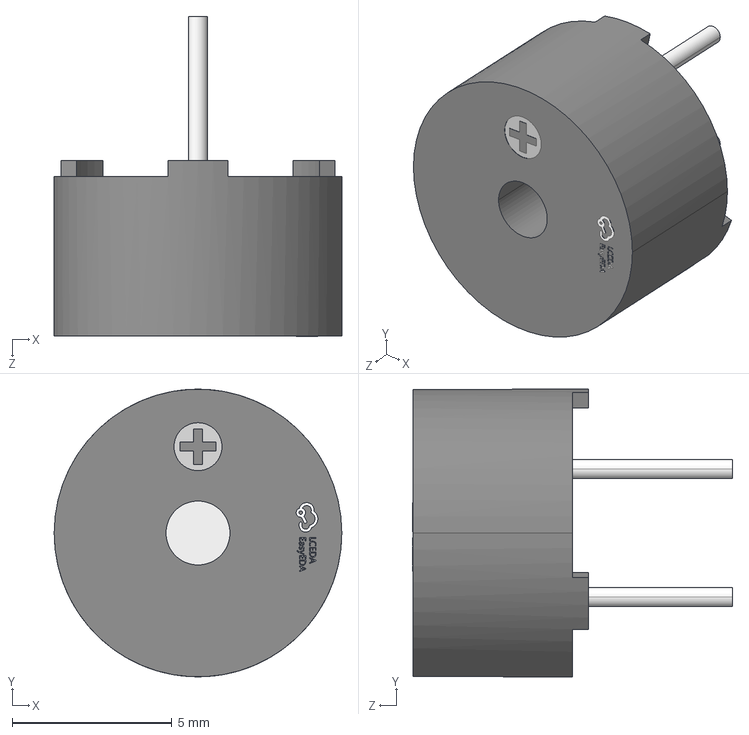
[picture p46: CAD file, 2026-10-11]
hardware/controller/pcb/3d/BUZ-TH_D9.0-H5.5-P4.0.step
9.00 x 9.00 x 10.0 mm
