rckTom/alturia-launch-control/hardware/parts/SKRTLA.STEP

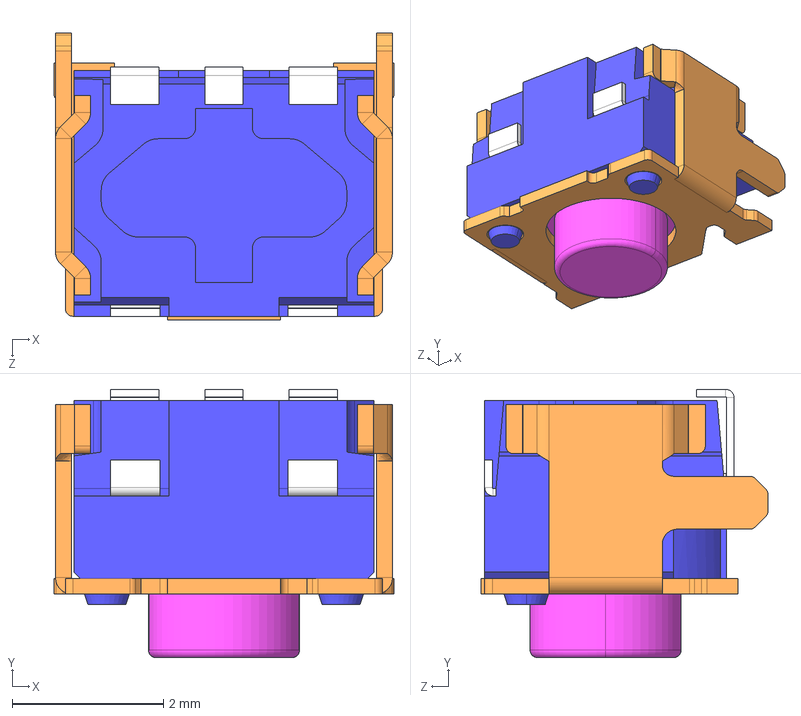
[picture p47: CAD file, 2026-10-11]
hardware/parts/SKRTLA.STEP
4.50 x 3.55 x 3.80 mm
