rckTom/alturia-launch-control/hardware/satellite/cad/front_plate.FCStd

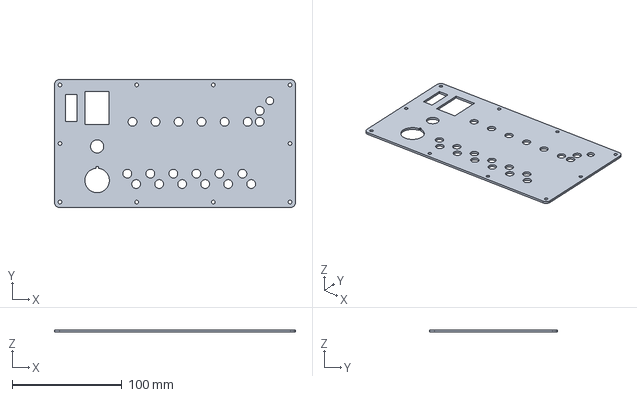
[picture p48: CAD file, 2026-11-05]
hardware/satellite/cad/front_plate.FCStd
219.8 x 116.8 x 2.00 mm
