rckTom/alturia-launch-control/hardware/satellite/cad/mesh/BatteryClamp2.stl

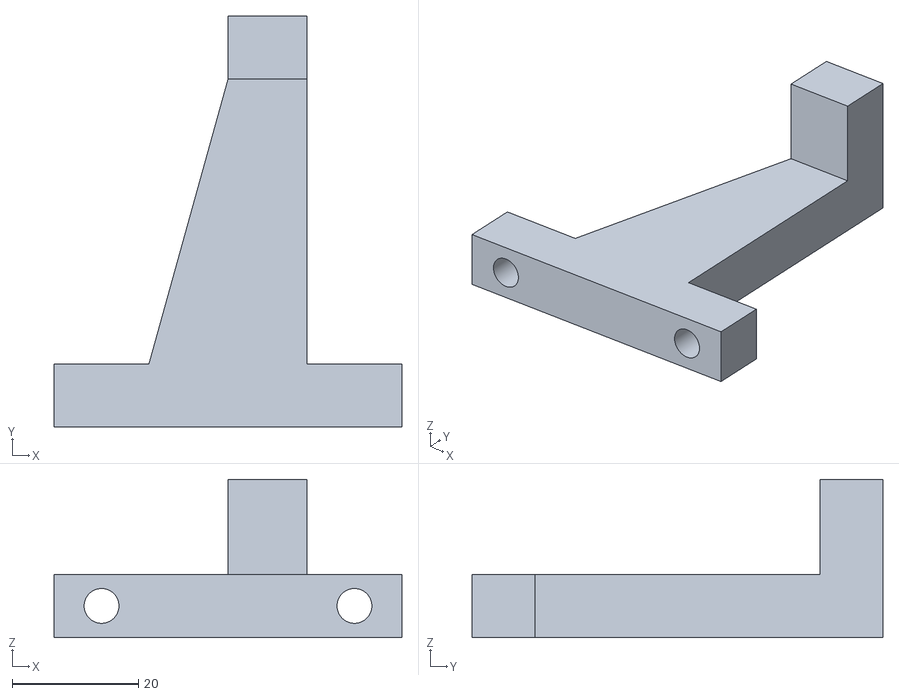
[picture p49: CAD file, 2026-11-05]
hardware/satellite/cad/mesh/BatteryClamp2.stl
55.0 x 65.0 x 25.0
