rckTom/alturia-launch-control/hardware/controller/cad/mesh/KeyPadMembrane.stl

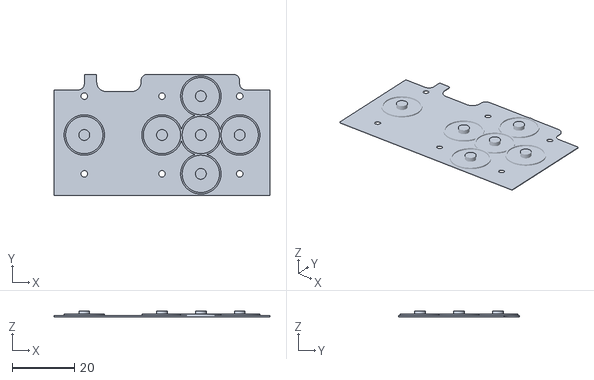
[picture p50: CAD file, 2026-11-01]
hardware/controller/cad/mesh/KeyPadMembrane.stl
69.5 x 39.0 x 1.80
