rckTom/alturia-launch-control/hardware/parts/sma_pigtail.FCStd

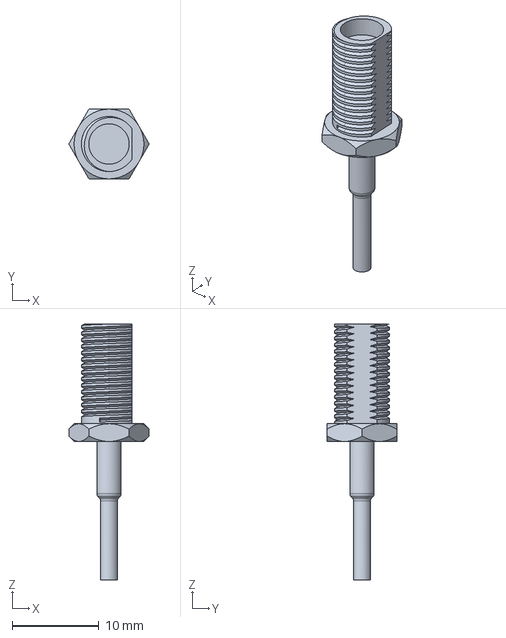
[picture p51: CAD file, 2026-10-11]
hardware/parts/sma_pigtail.FCStd
9.28 x 8.04 x 29.5 mm
