rckTom/alturia-launch-control/hardware/satellite/cad/mesh/Case.3mf

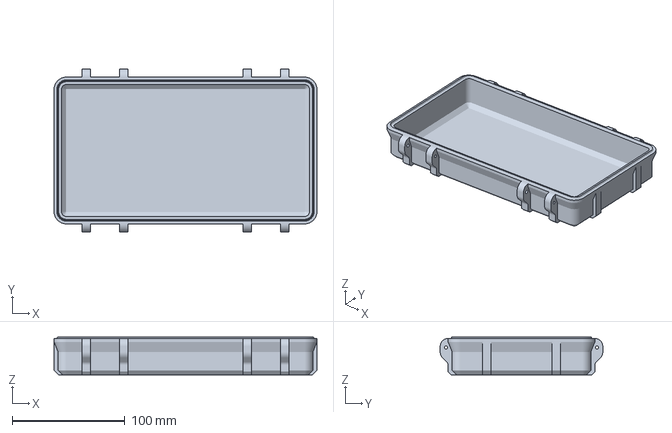
[picture p52: CAD file, 2026-11-01]
hardware/satellite/cad/mesh/Case.3mf
233.2 x 144.2 x 33.7 mm
