rckTom/alturia-launch-control/hardware/controller/cad/mesh/PowerGrommet.stl

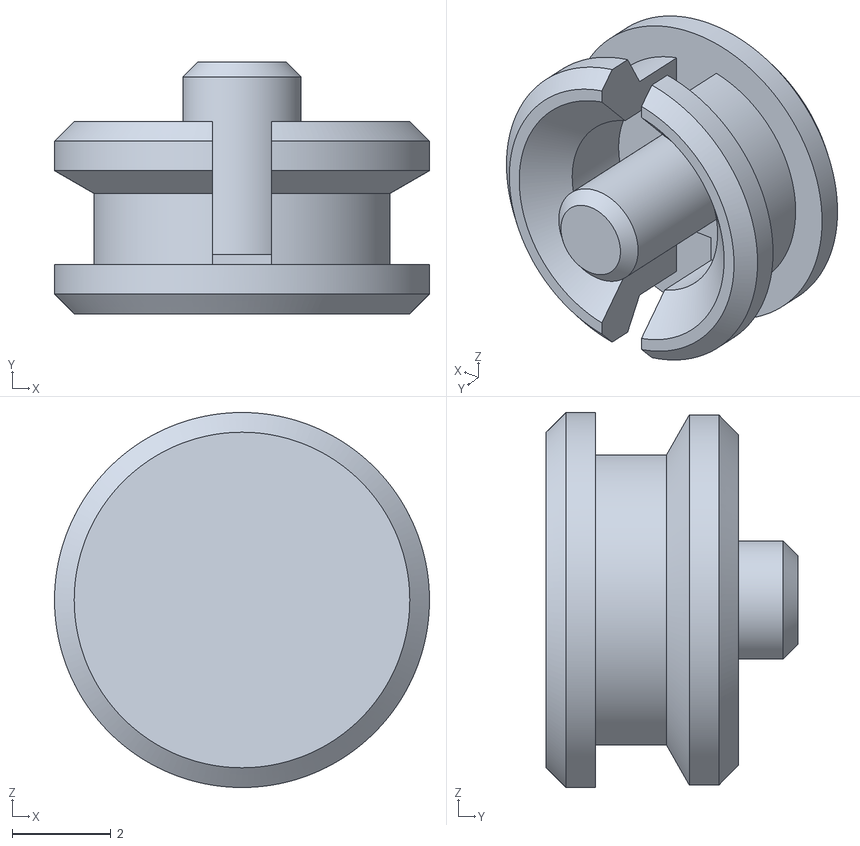
[picture p53: CAD file, 2026-11-01]
hardware/controller/cad/mesh/PowerGrommet.stl
7.60 x 5.10 x 7.60
