rckTom/alturia-launch-control/hardware/parts/Adafruit_4694_Sharp27.step

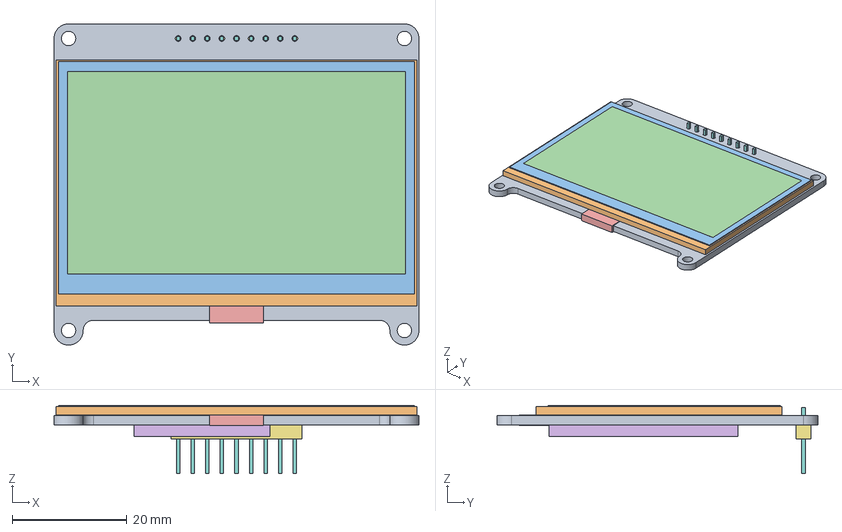
[picture p54: CAD file, 2026-10-11]
hardware/parts/Adafruit_4694_Sharp27.step
63.5 x 55.9 x 11.9 mm
