rckTom/alturia-launch-control/hardware/satellite/cad/mesh/led_spacer.stl

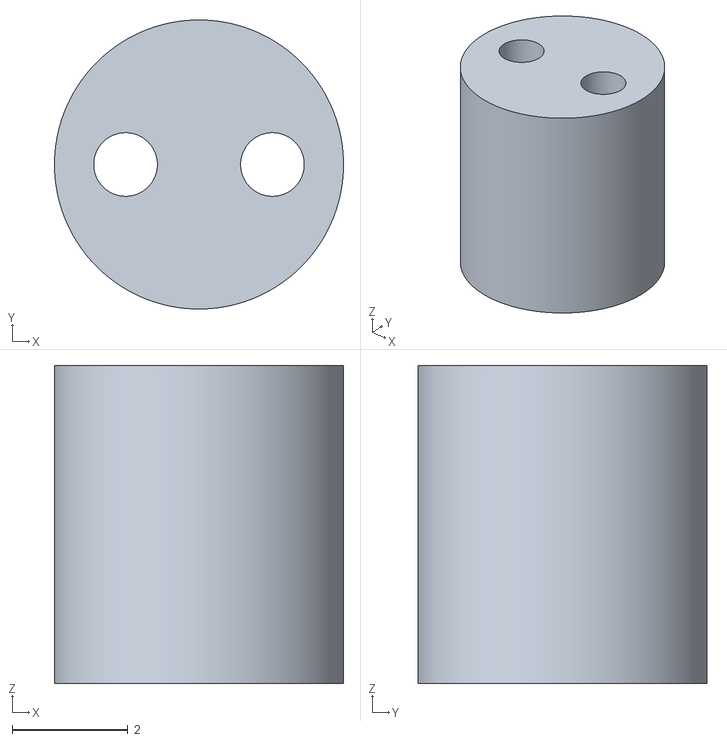
[picture p55: CAD file, 2026-11-01]
hardware/satellite/cad/mesh/led_spacer.stl
5.00 x 5.00 x 5.50
