rckTom/alturia-launch-control/hardware/controller/cad/BackCase.FCStd

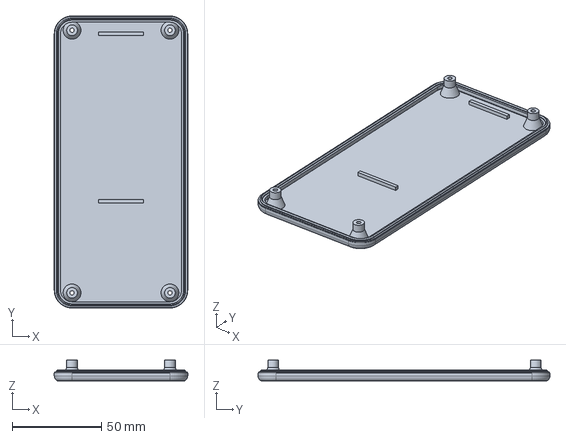
[picture p56: CAD file, 2026-11-01]
hardware/controller/cad/BackCase.FCStd
75.0 x 164.0 x 11.6 mm
