rckTom/alturia-launch-control/hardware/parts/1932.3112.stp

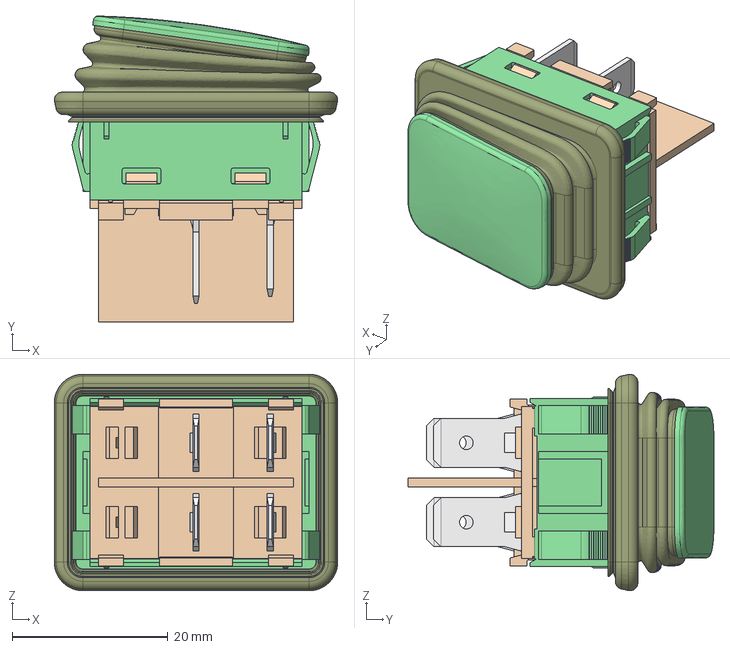
[picture p57: CAD file, 2026-10-06]
hardware/parts/1932.3112.stp
36.4 x 39.3 x 27.8 mm
