rckTom/alturia-launch-control/hardware/satellite/cad/BatteryClamp.FCStd

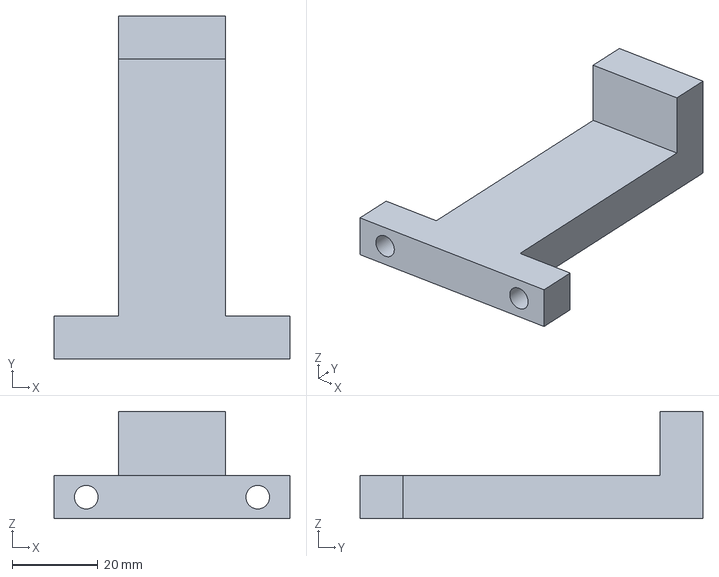
[picture p58: CAD file, 2026-11-02]
hardware/satellite/cad/BatteryClamp.FCStd
55.0 x 80.0 x 25.0 mm
