rckTom/alturia-launch-control/hardware/satellite/cad/mesh/UsbPlug.stl

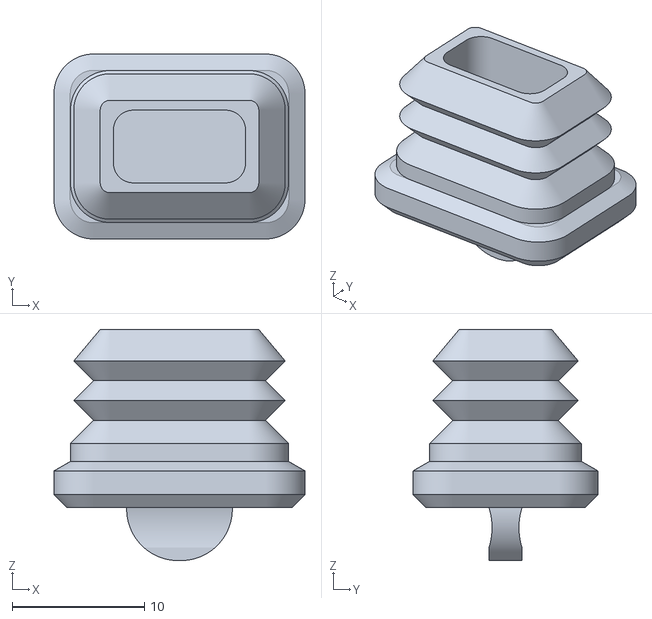
[picture p59: CAD file, 2026-11-01]
hardware/satellite/cad/mesh/UsbPlug.stl
19.0 x 14.0 x 17.5
