rckTom/alturia-launch-control/hardware/controller/cad/mesh/KeyPadMembraneRetainer.stl

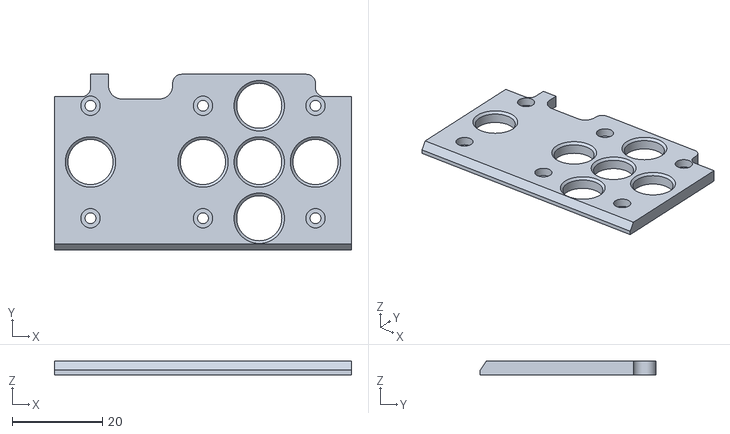
[picture p60: CAD file, 2026-11-01]
hardware/controller/cad/mesh/KeyPadMembraneRetainer.stl
66.0 x 39.0 x 3.00
