rckTom/alturia-launch-control/hardware/controller/cad/PowerGrommet.FCStd

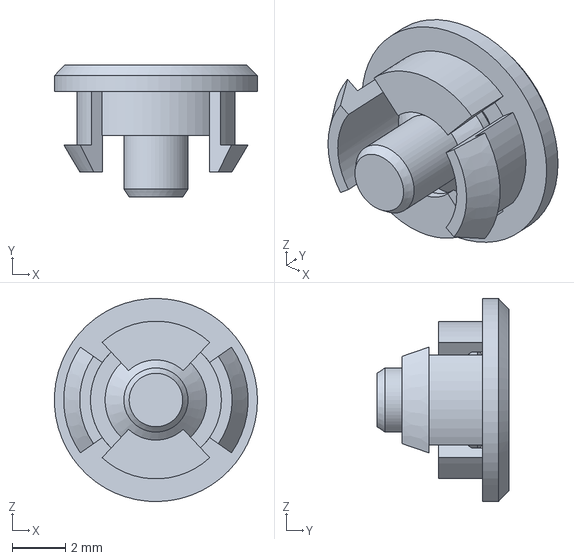
[picture p61: CAD file, 2026-11-01]
hardware/controller/cad/PowerGrommet.FCStd
7.59 x 4.95 x 7.60 mm
