rckTom/alturia-launch-control/hardware/parts/FUS Fuse Holder Fingergrip Cap_03.STEP

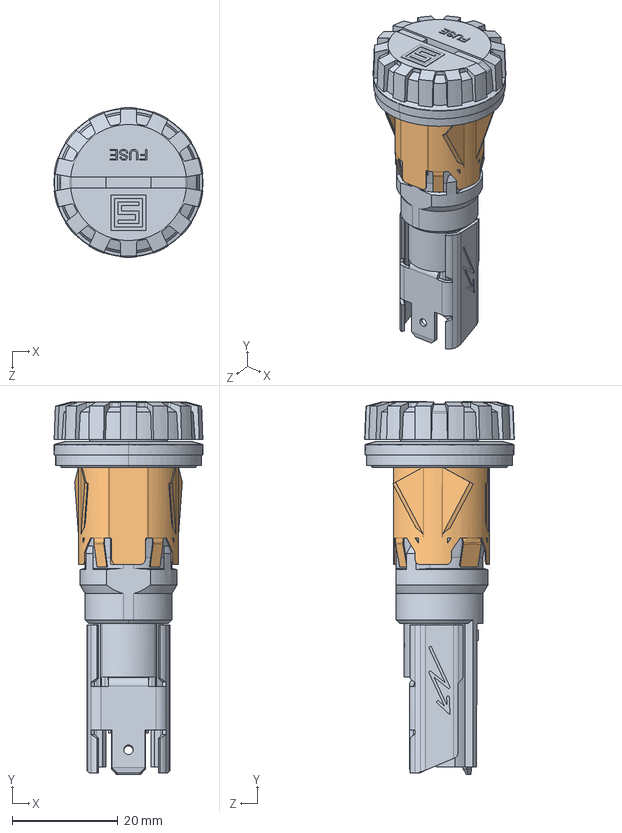
[picture p62: CAD file, 2026-10-06]
hardware/parts/FUS Fuse Holder Fingergrip Cap_03.STEP
28.2 x 70.7 x 28.4 mm
