rckTom/alturia-launch-control/hardware/controller/cad/FrontCase.FCStd

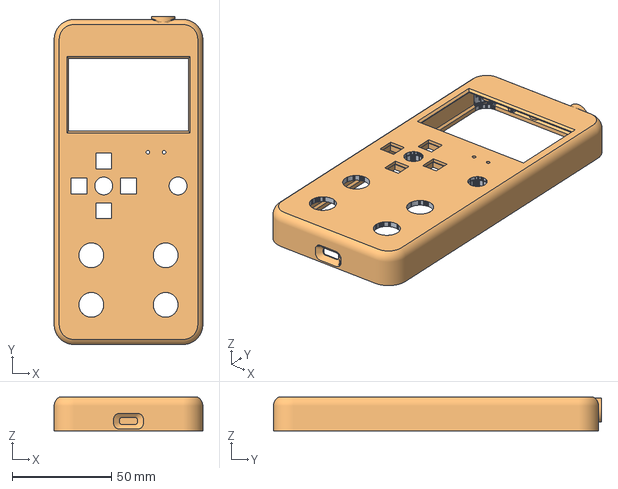
[picture p63: CAD file, 2026-11-01]
hardware/controller/cad/FrontCase.FCStd
75.0 x 165.5 x 17.0 mm
Hole001 (Meshed)
