rckTom/alturia-launch-control/hardware/controller/cad/mesh/CaseFront.stl

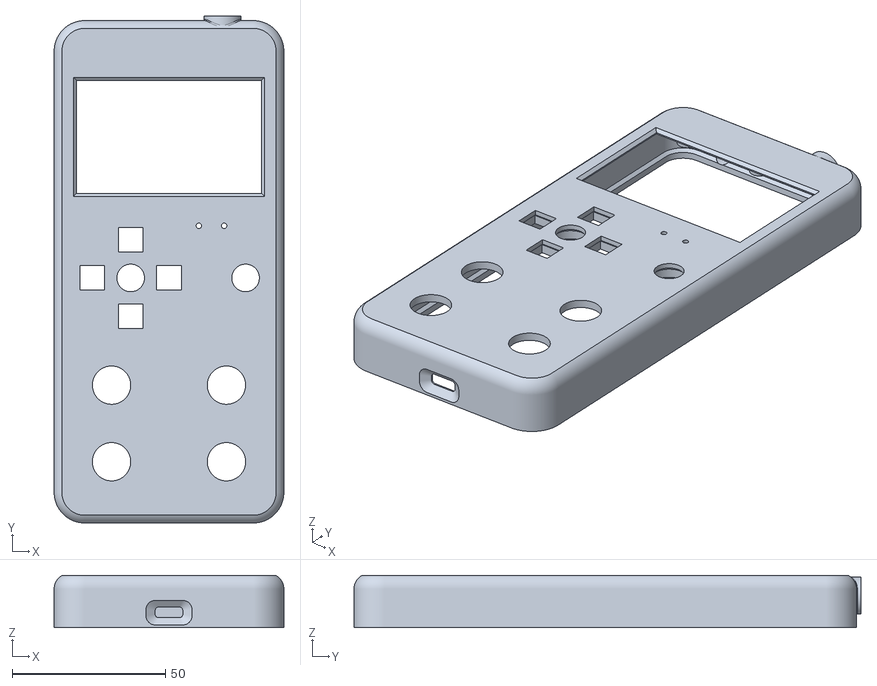
[picture p64: CAD file, 2026-11-01]
hardware/controller/cad/mesh/CaseFront.stl
75.0 x 165.5 x 17.0
