rckTom/alturia-launch-control/hardware/parts/Delock_22032.step

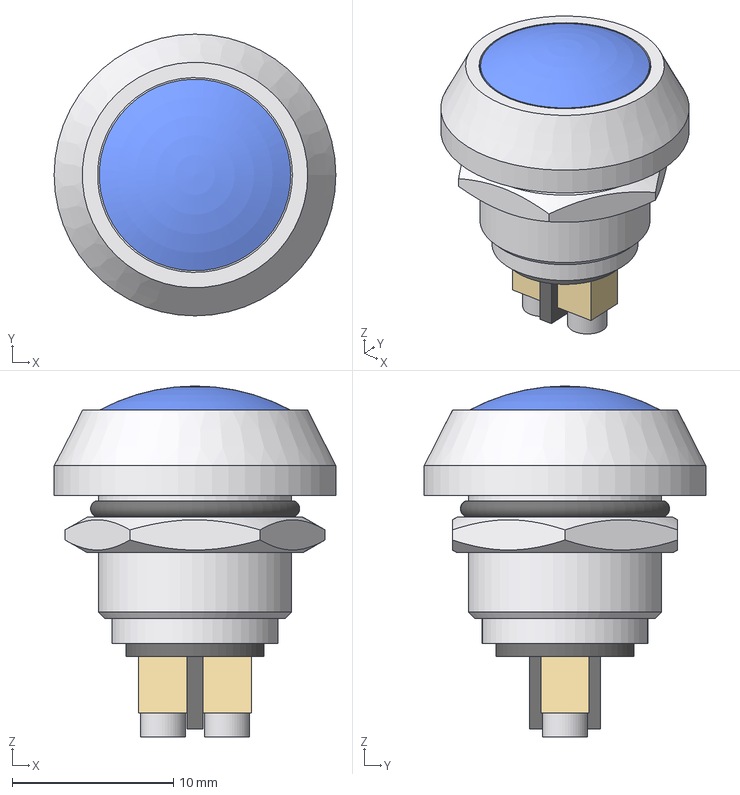
[picture p65: CAD file, 2026-10-06]
hardware/parts/Delock_22032.step
17.5 x 17.5 x 21.8 mm
Housing
Actuator
Gasket
Nut
Insulator
Terminals
Screws
