rckTom/alturia-launch-control/hardware/satellite/cad/Latch.FCStd

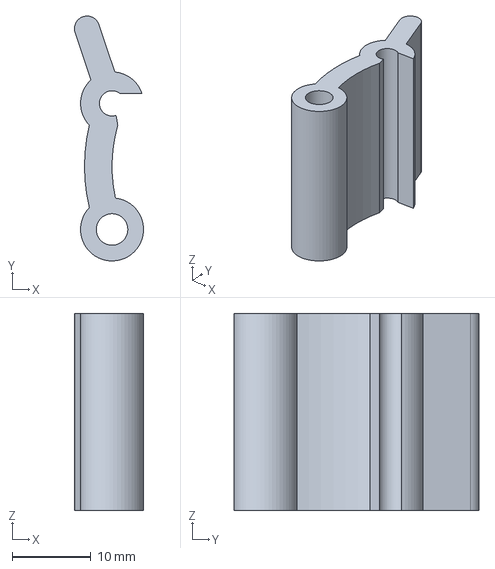
[picture p66: CAD file, 2026-11-02]
hardware/satellite/cad/Latch.FCStd
8.77 x 31.1 x 25.0 mm
