rckTom/alturia-launch-control/hardware/satellite/cad/mesh/led_grommet.stl

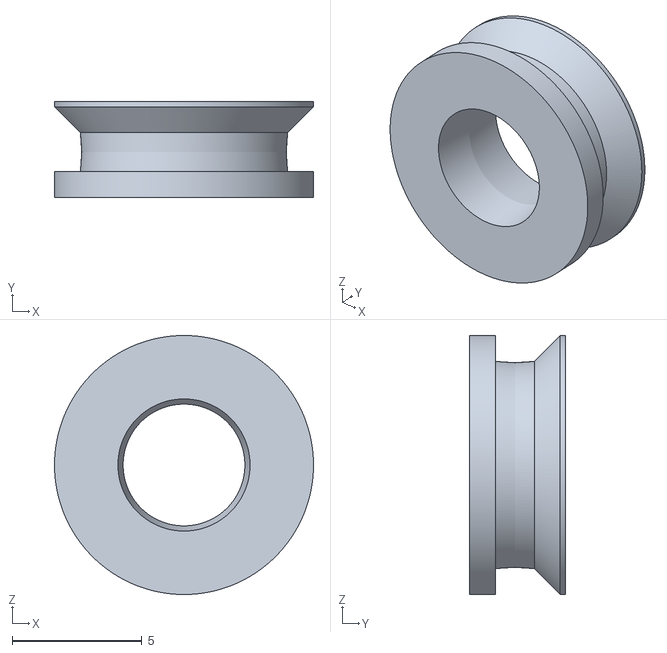
[picture p67: CAD file, 2026-11-01]
hardware/satellite/cad/mesh/led_grommet.stl
10.0 x 3.70 x 10.0
