rckTom/alturia-launch-control/hardware/controller/cad/mesh/KeyCapBodyRound.3mf

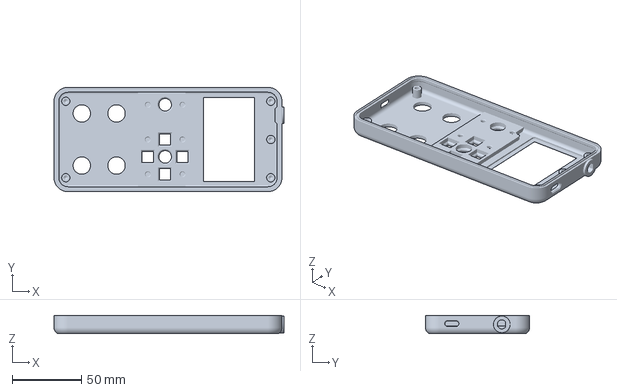
[picture p68: CAD file, 2026-10-11]
hardware/controller/cad/mesh/KeyCapBodyRound.3mf
165.5 x 75.0 x 13.0 mm
