rckTom/alturia-launch-control/hardware/parts/fuse_holder_jef.step

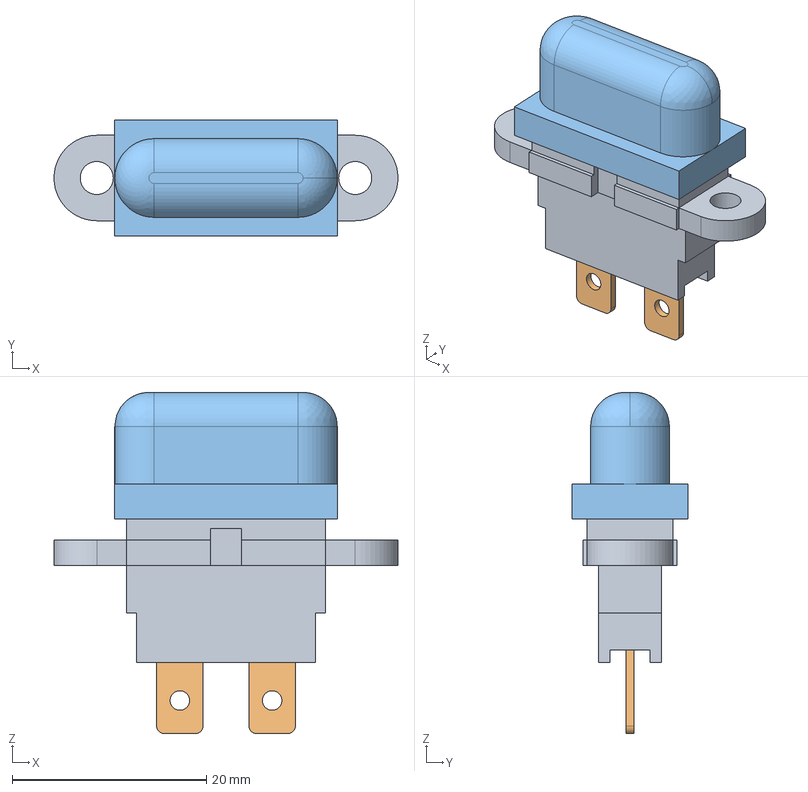
[picture p69: CAD file, 2026-10-06]
hardware/parts/fuse_holder_jef.step
35.4 x 11.9 x 35.1 mm
Holder
Terminals
Cap
