rckTom/alturia-launch-control/hardware/satellite/cad/Battery.FCStd

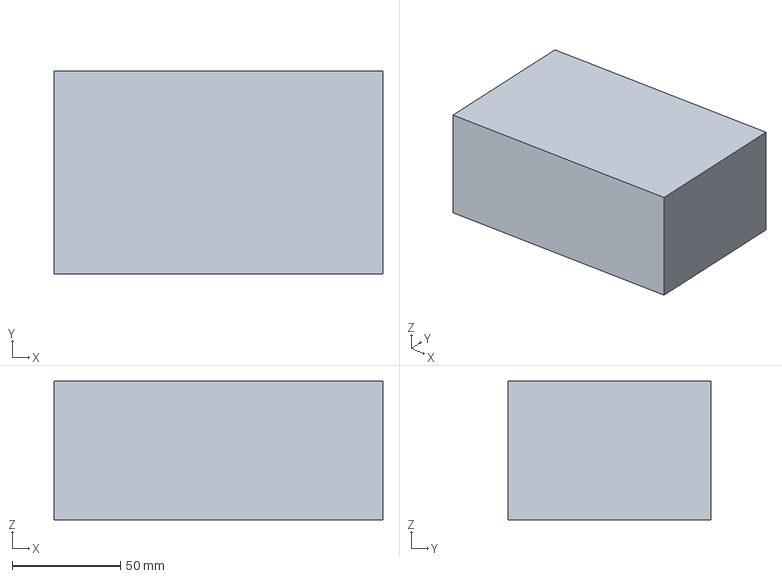
[picture p70: CAD file, 2026-11-02]
hardware/satellite/cad/Battery.FCStd
152.0 x 94.0 x 64.0 mm
