rckTom/alturia-launch-control/hardware/satellite/cad/mesh/FuseGrommet.stl

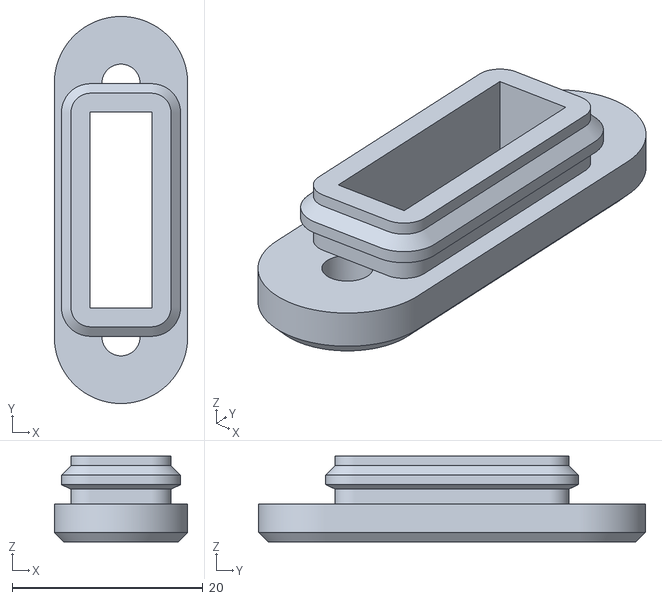
[picture p71: CAD file, 2026-11-01]
hardware/satellite/cad/mesh/FuseGrommet.stl
14.0 x 40.6 x 9.00
