rckTom/alturia-launch-control/hardware/controller/cad/KeyCapDot.FCStd

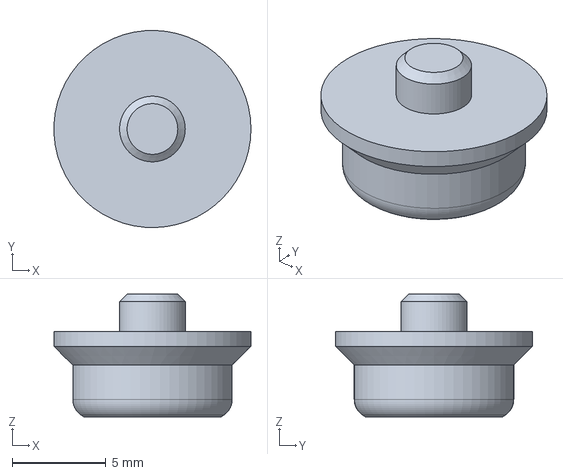
[picture p72: CAD file, 2026-11-01]
hardware/controller/cad/KeyCapDot.FCStd
10.5 x 10.5 x 6.55 mm
