rckTom/alturia-launch-control/hardware/parts/KeySwitch.FCStd

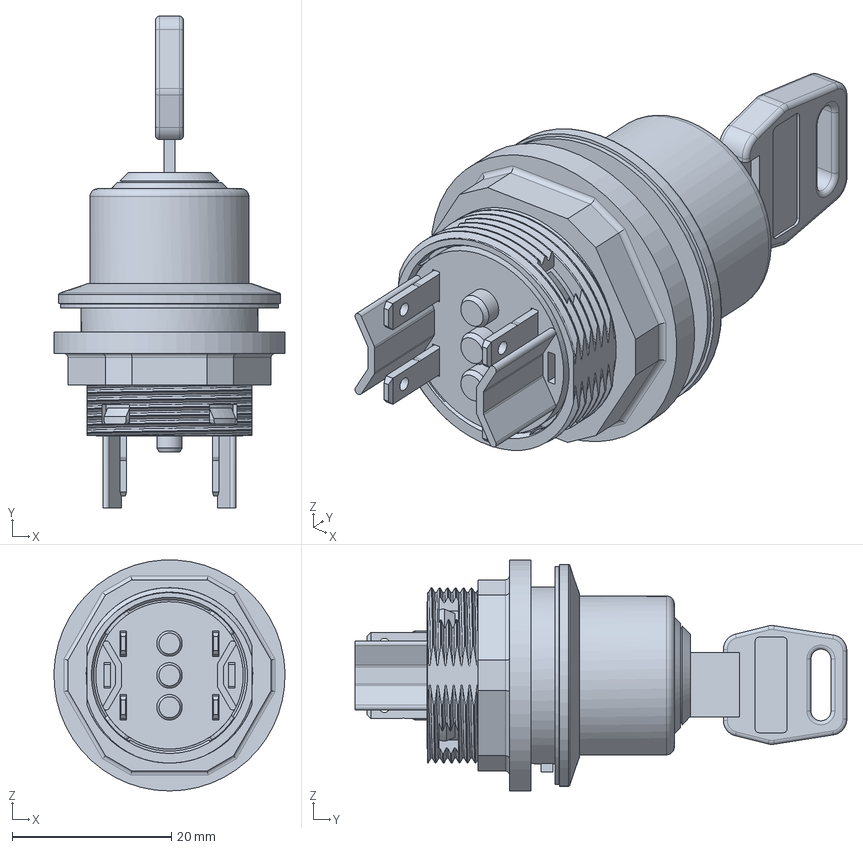
[picture p73: CAD file, 2026-10-06]
hardware/parts/KeySwitch.FCStd
29.0 x 61.7 x 29.0 mm
