rckTom/alturia-launch-control/hardware/parts/USB-C_SMD-TYPE-C-31-M-12_1.step

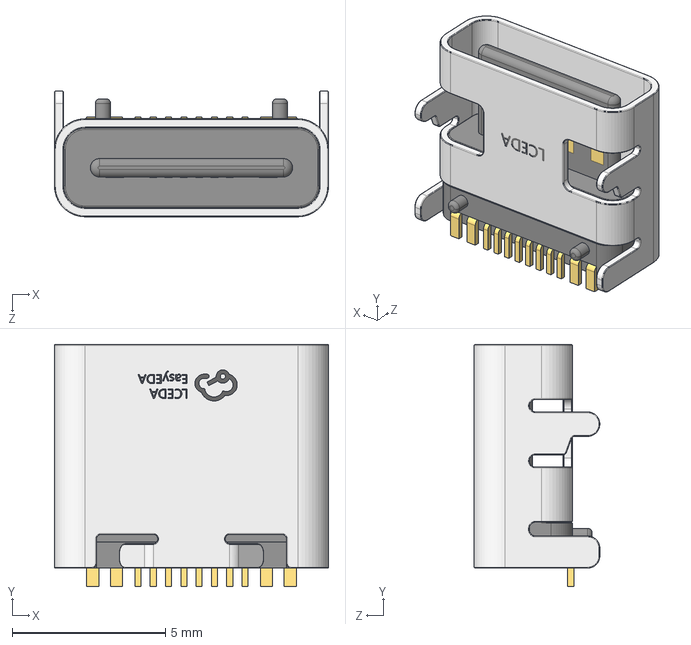
[picture p74: CAD file, 2026-10-06]
hardware/parts/USB-C_SMD-TYPE-C-31-M-12_1.step
8.94 x 7.90 x 4.10 mm
