rckTom/alturia-launch-control/hardware/satellite/cad/mesh/BananaJackHolderPart1.stl

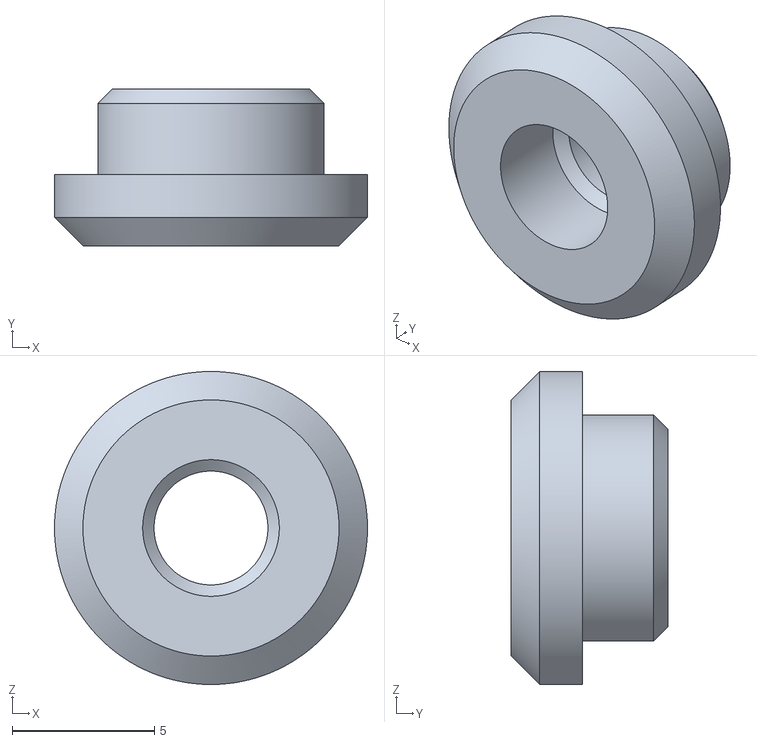
[picture p75: CAD file, 2026-11-01]
hardware/satellite/cad/mesh/BananaJackHolderPart1.stl
11.0 x 5.50 x 11.0
