rckTom/alturia-launch-control/hardware/controller/cad/DpadMembrane.FCStd

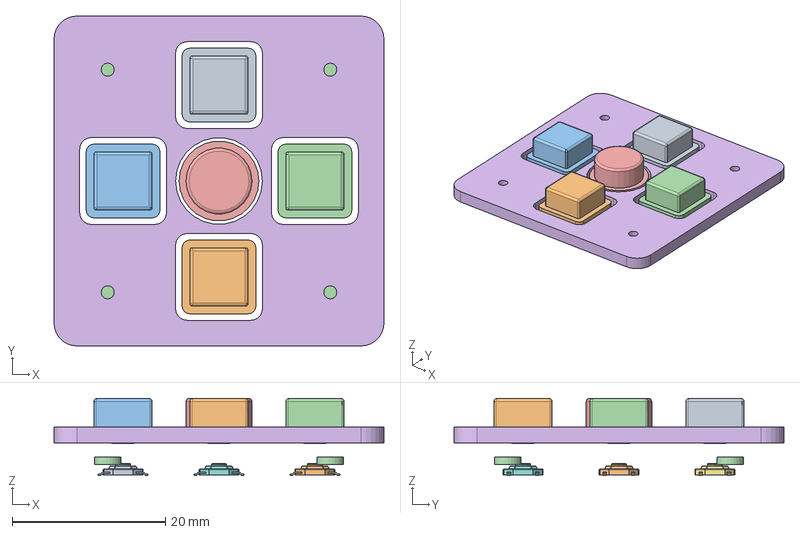
[picture p76: CAD file, 2026-10-11]
hardware/controller/cad/DpadMembrane.FCStd
43.0 x 43.0 x 10.0 mm
Cap_Up
Cap_Down
Cap_Left
Cap_Right
Cap_Enter
FramePad
Switch0
Switch1
Switch2
Switch3
Switch4
ScrewHeads
