rckTom/alturia-launch-control/hardware/parts/Panasonic_ACTL3CR3V.FCStd

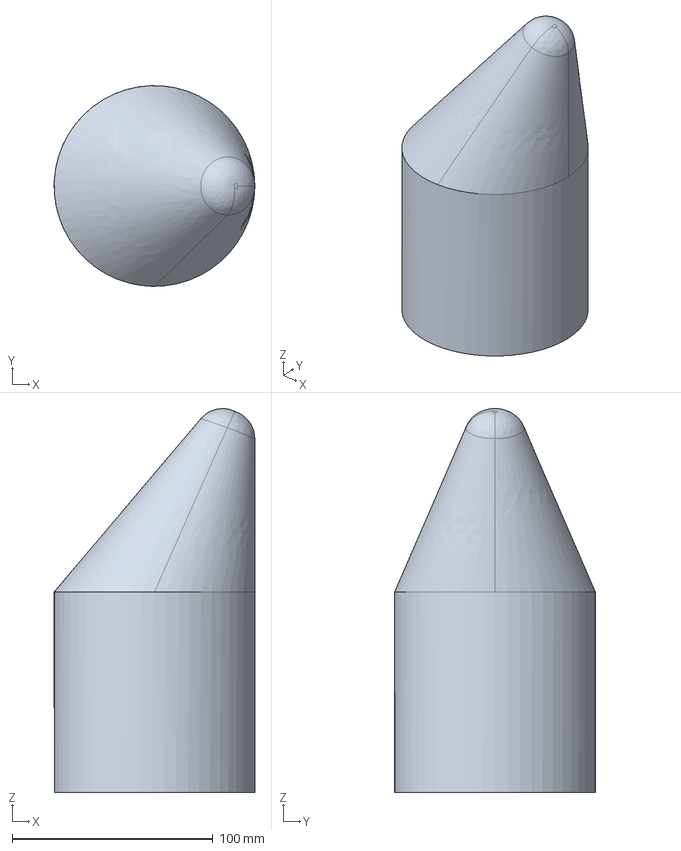
[picture p77: CAD file, 2026-09-23]
hardware/parts/Panasonic_ACTL3CR3V.FCStd
100.0 x 100.0 x 191.3 mm
