rckTom/alturia-launch-control/hardware/satellite/cad/led_spacer.FCStd

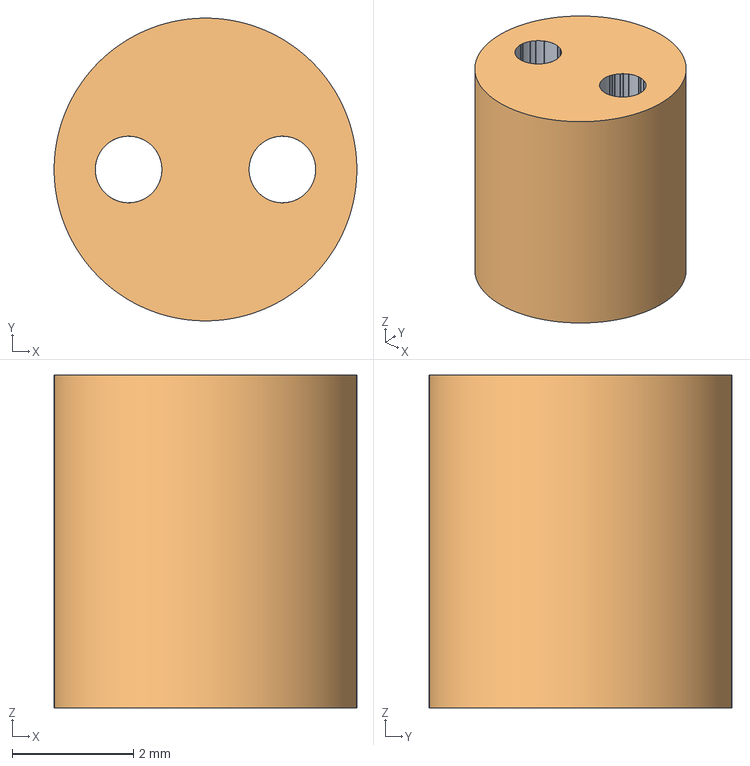
[picture p78: CAD file, 2026-11-01]
hardware/satellite/cad/led_spacer.FCStd
5.00 x 5.00 x 5.50 mm
Body (Meshed)
