rckTom/alturia-launch-control/hardware/satellite/cad/mesh/BananaJackHolderPart2.stl

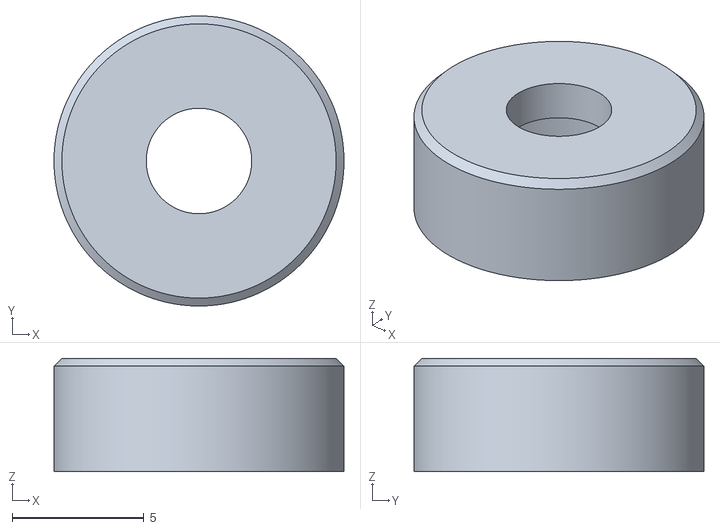
[picture p79: CAD file, 2026-11-01]
hardware/satellite/cad/mesh/BananaJackHolderPart2.stl
11.0 x 11.0 x 4.30
