rckTom/alturia-launch-control/hardware/parts/banana_jack.step

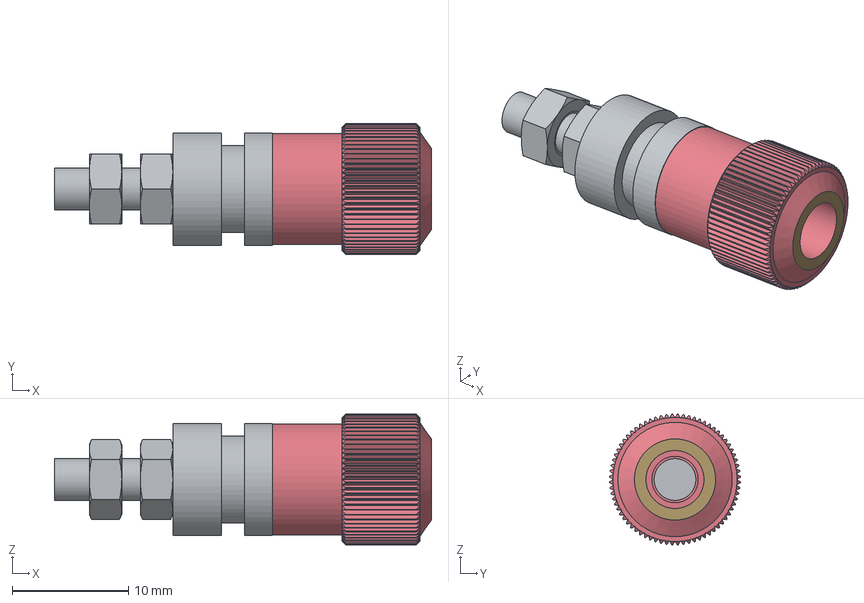
[picture p80: CAD file, 2026-09-23]
hardware/parts/banana_jack.step
32.5 x 11.3 x 11.3 mm
Base
(M3.5)-Nut x 2
