rckTom/alturia-launch-control/hardware/satellite/cad/mesh/case_seal.stl

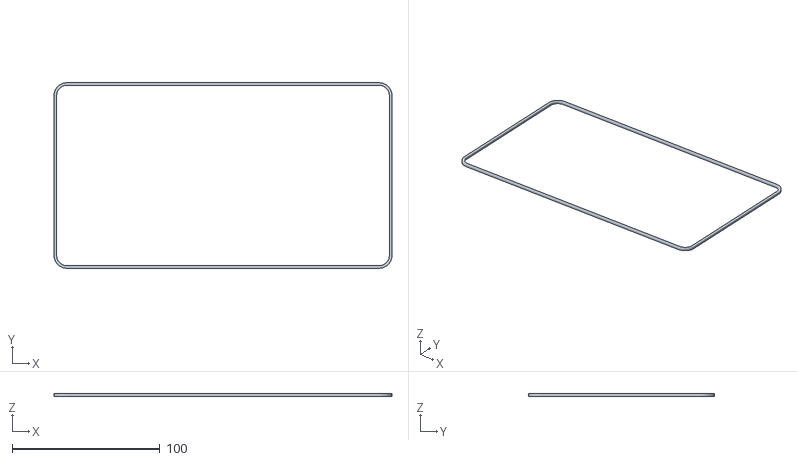
[picture p81: CAD file, 2026-11-01]
hardware/satellite/cad/mesh/case_seal.stl
228.4 x 125.4 x 2.00
