rckTom/alturia-launch-control/hardware/controller/cad/PowerBoot.FCStd

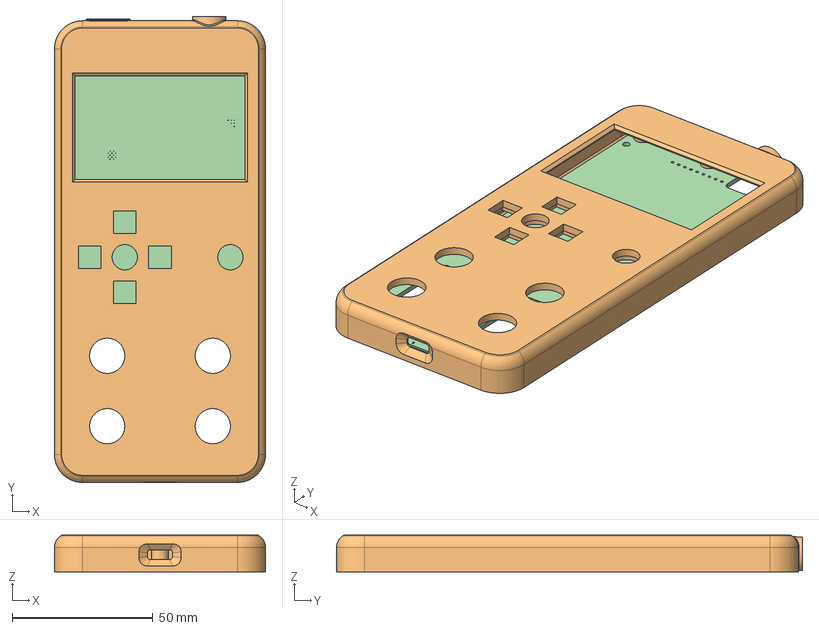
[picture p82: CAD file, 2026-10-11]
hardware/controller/cad/PowerBoot.FCStd
75.0 x 165.5 x 13.0 mm
Boot
FrontCase_cut
SW101
PCB_ref
