rckTom/alturia-launch-control/hardware/parts/Panasonic_ACTL3CR3V-Body.step

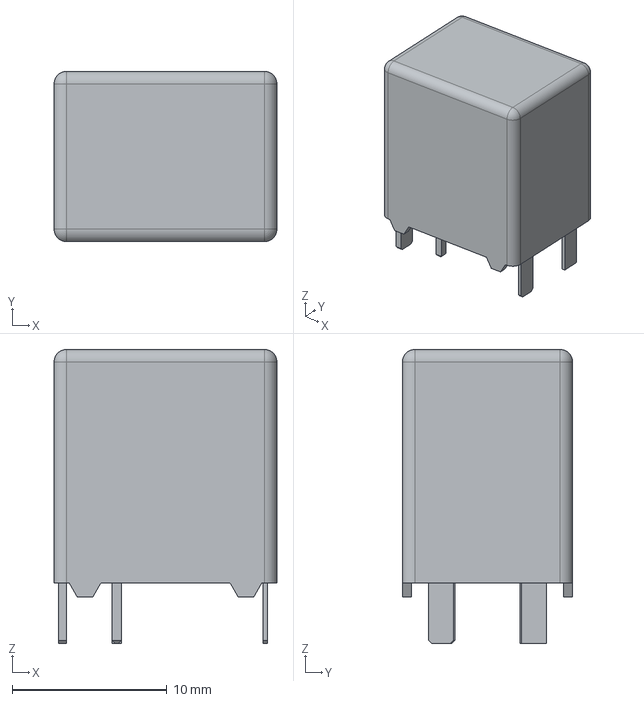
[picture p83: CAD file, 2026-09-23]
hardware/parts/Panasonic_ACTL3CR3V-Body.step
14.4 x 11.0 x 19.0 mm
