rckTom/alturia-launch-control/hardware/controller/cad/plexi_windows.FCStd

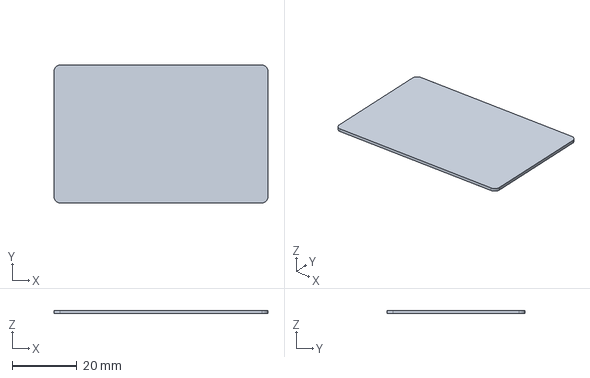
[picture p84: CAD file, 2026-10-11]
hardware/controller/cad/plexi_windows.FCStd
66.1 x 42.6 x 1.00 mm
