rckTom/alturia-launch-control/hardware/satellite/cad/XT60CaseConnector.FCStd

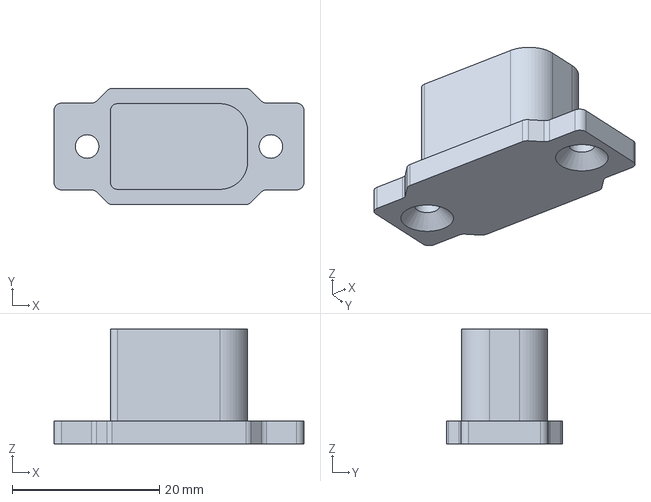
[picture p85: CAD file, 2026-11-01]
hardware/satellite/cad/XT60CaseConnector.FCStd
34.0 x 15.8 x 15.6 mm
