rckTom/alturia-launch-control/hardware/satellite/cad/BananaJackHolderBottom.FCStd

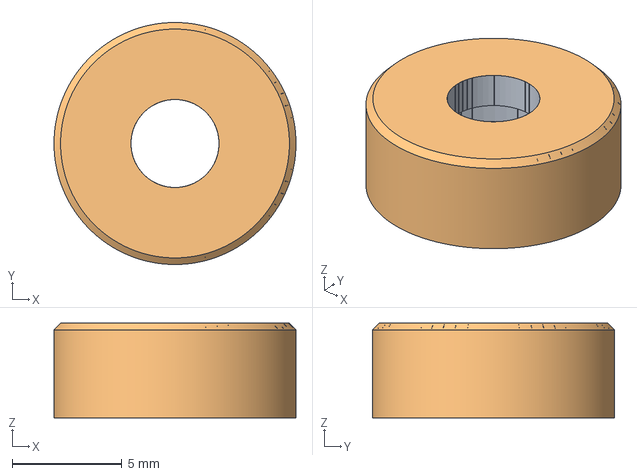
[picture p86: CAD file, 2026-11-01]
hardware/satellite/cad/BananaJackHolderBottom.FCStd
11.0 x 11.0 x 4.30 mm
Body (Meshed)
