rckTom/alturia-launch-control/hardware/satellite/cad/BoxGuideline.FCStd

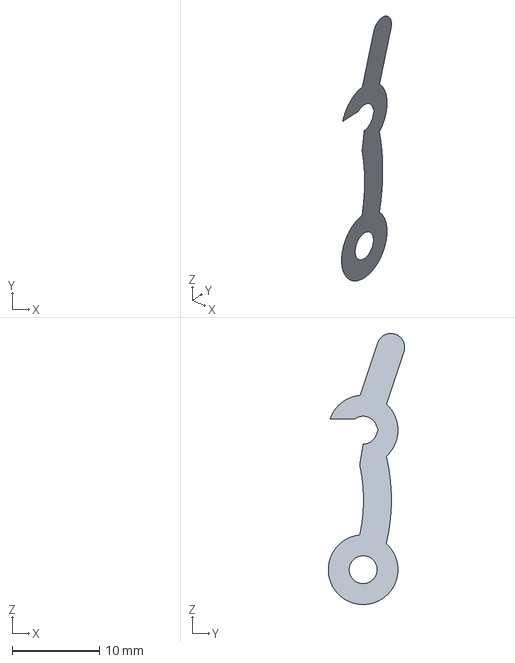
[picture p87: CAD file, 2026-10-06]
hardware/satellite/cad/BoxGuideline.FCStd
0 x 8.77 x 31.1 mm
