rckTom/alturia-launch-control/hardware/satellite/cad/ParametricCaseBase.FCStd

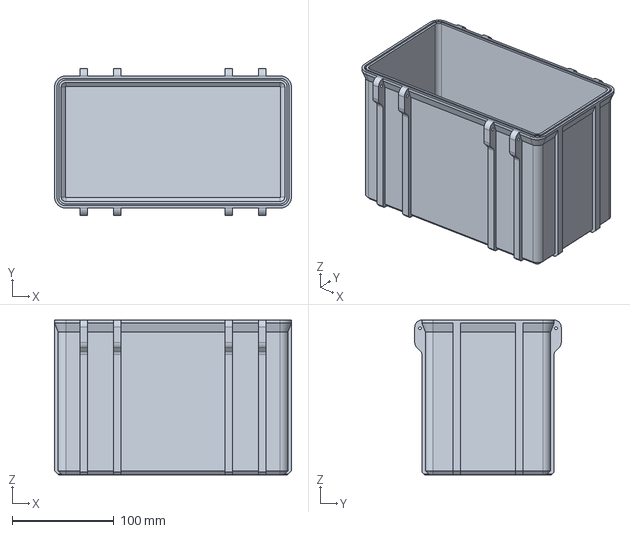
[picture p88: CAD file, 2026-10-06]
hardware/satellite/cad/ParametricCaseBase.FCStd
233.2 x 144.2 x 152.4 mm
