rckTom/alturia-launch-control/hardware/satellite/cad/Body001 (Meshed).stl

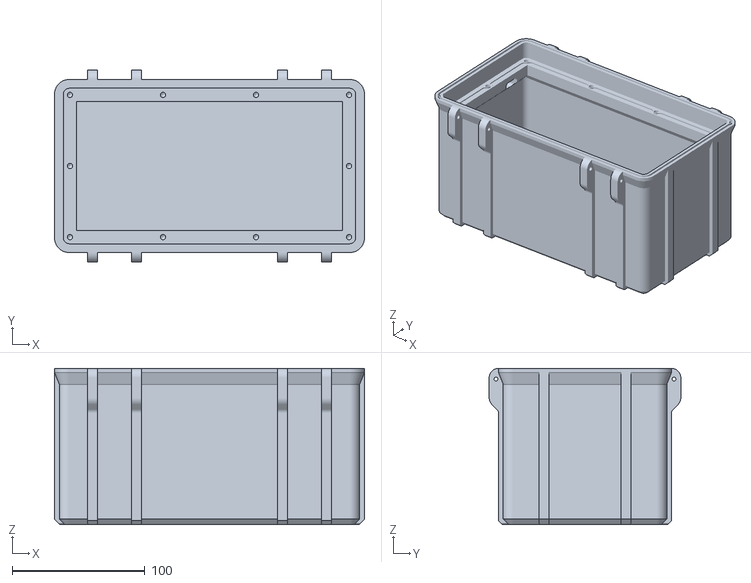
[picture p89: CAD file, 2026-10-06]
hardware/satellite/cad/Body001 (Meshed).stl
233.2 x 144.2 x 117.4
