rckTom/alturia-launch-control/(list of files, cad)

Other CAD files:
hardware/satellite/cad/front_plate_assembly.FCStd
hardware/satellite/cad/LidAssembly.FCStd
hardware/controller/cad/KeyCapArrow.FCStd
hardware/controller/cad/KeyPadMembrane.FCStd
hardware/controller/cad/mesh/CaseBack.stl
hardware/satellite/cad/mesh/Lid.stl
hardware/satellite/cad/ParametricCaseBaseLid.FCStd
hardware/controller/cad/KeyPadMembraneRetainer.FCStd
hardware/controller/cad/mesh/KeyCapHolderTest.3mf
hardware/satellite/cad/mesh/latch.stl
hardware/controller/cad/DistancePartDisplay.FCStd
hardware/satellite/cad/UsbPlug.FCStd
hardware/controller/cad/DisplayGlasGlue.FCStd
hardware/satellite/cad/FuseGrommet.FCStd
hardware/satellite/cad/BananaJackHolderTop.FCStd
hardware/satellite/cad/led_grommet.FCStd
hardware/satellite/cad/power_switch.FCStd
hardware/satellite/cad/fuse_holder.FCStd
hardware/controller/cad/mesh/KeyCapBodyRound.stl
hardware/controller/pcb/Controller.FCStd
hardware/parts/Adafruit_4694_Sharp27.FCStd
hardware/parts/Delock_22032.FCStd
hardware/parts/banana_jack.FCStd
hardware/parts/fuse_holder_jef.FCStd
hardware/satellite/cad/ParametricCaseOldBatteryHolder.FCStd
hardware/satellite/cad/mesh/Case.stl
