rckTom/alturia-launch-control/hardware/parts/22032_draw.pdf

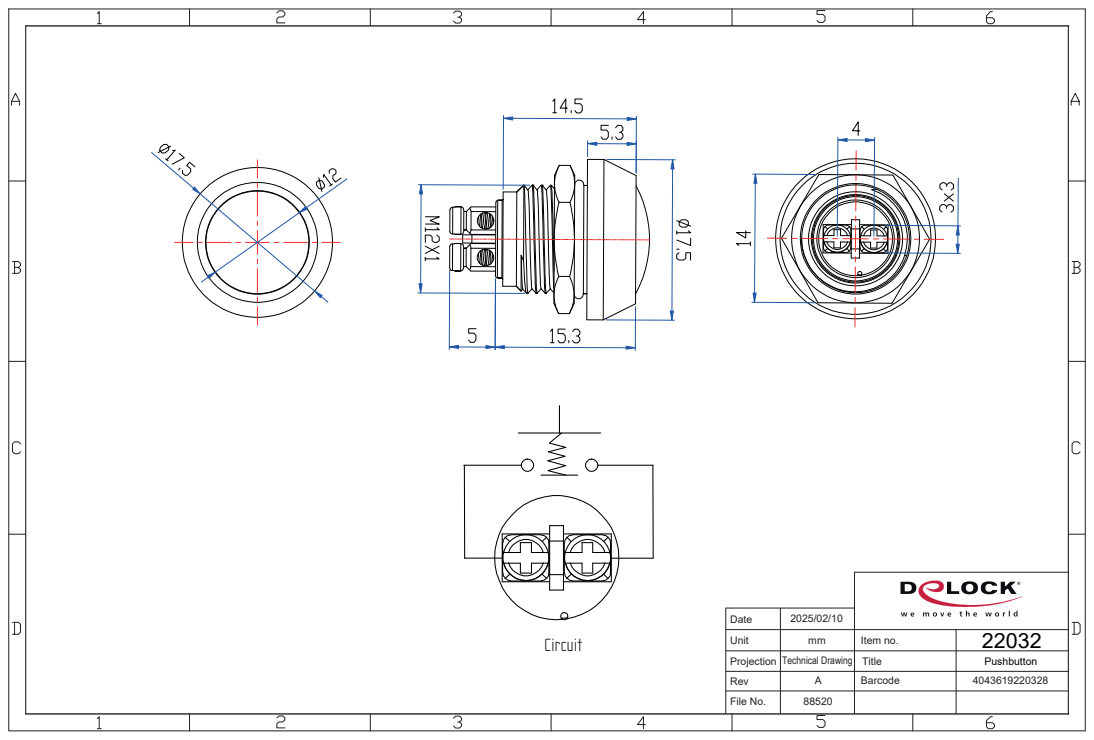
[picture p90: page 1]
Circuit

Date | 2025/02/10
Unit | mmA | Item no. | 22032
Projection | Technical Drawing | Title | Pushbutton
Rev | | Barcode | 4043619220328
File No. | 88520
