rckTom/alturia-launch-control/hardware/controller/pcb/controller.kicad_pcb

## KiCad design hardware/controller/pcb/controller.kicad_pcb (2026-11-05)

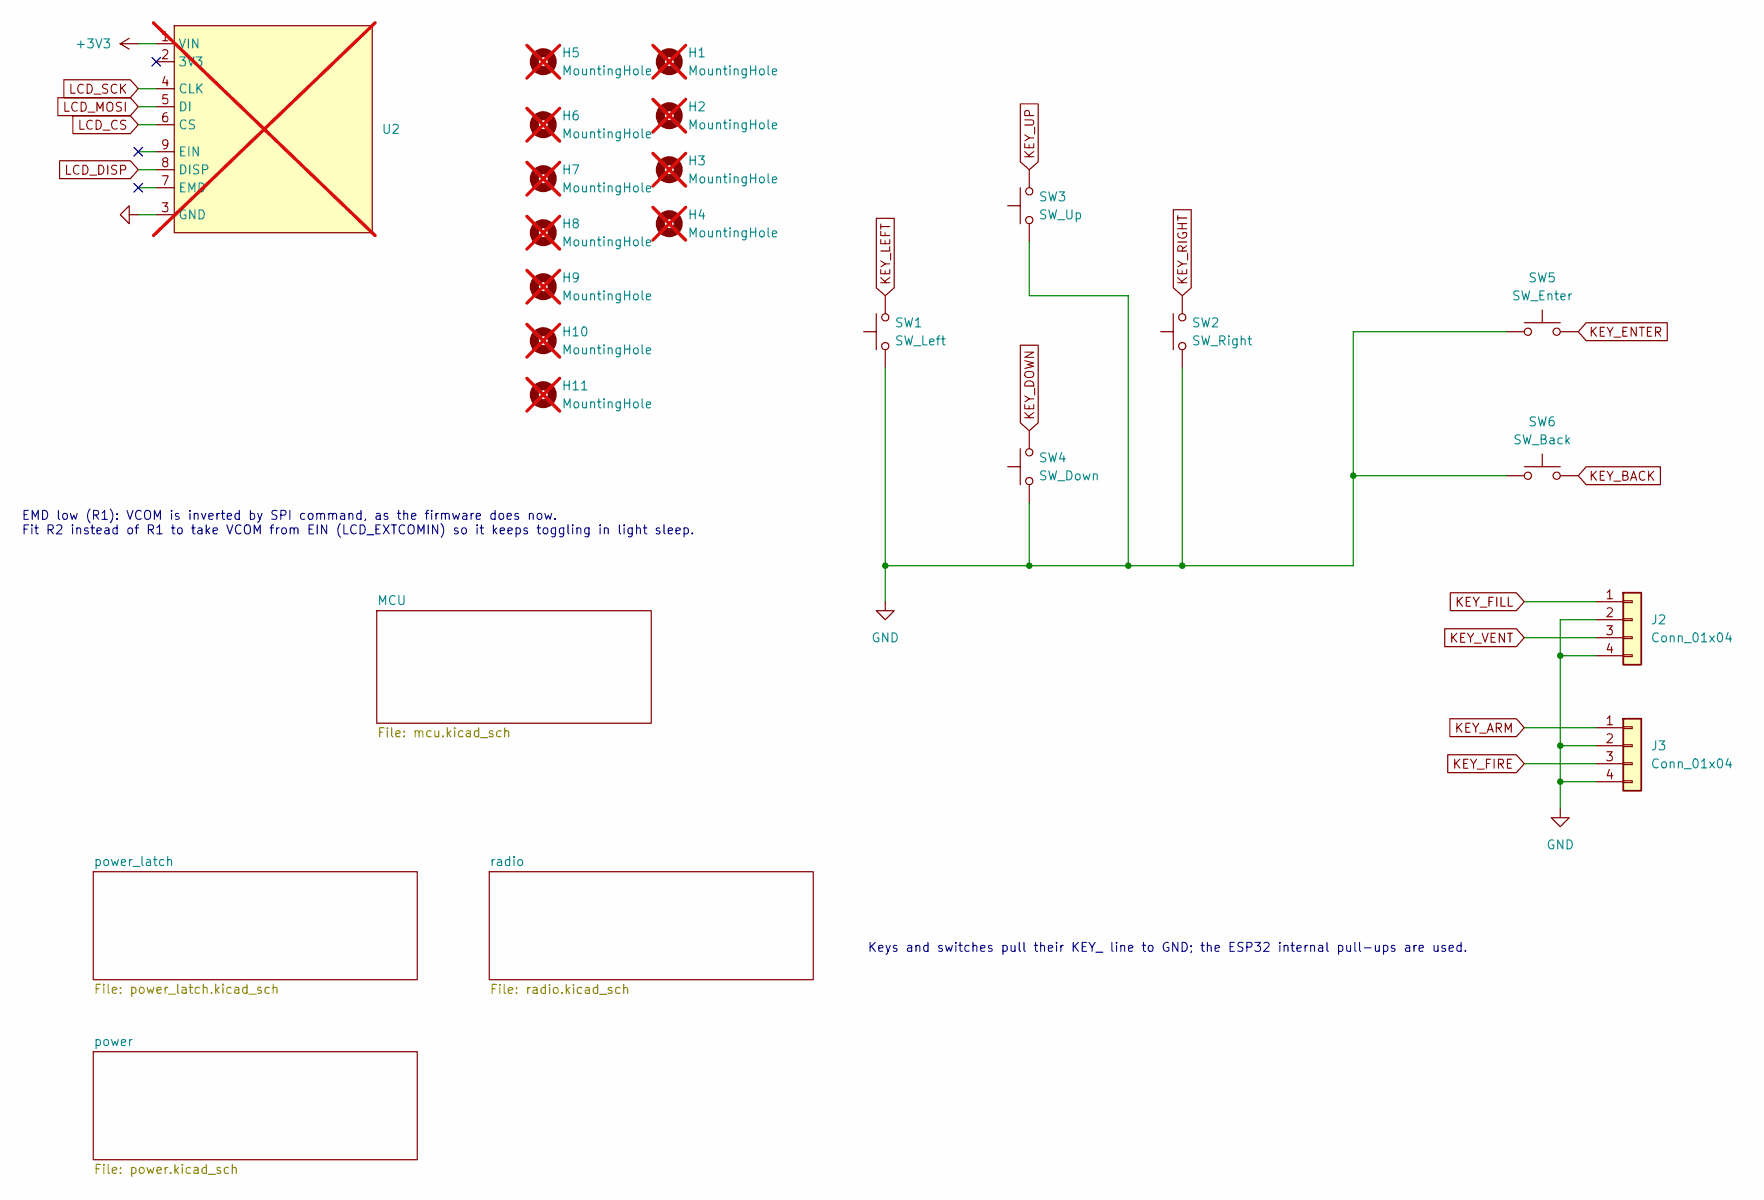
[picture p91: schematic controller.kicad_sch]

Parts:
H1, H2, H3, H4, H5, H6, H7, H8, H9, H10, H11: MountingHole; MountingHole_2.2mm_M2_ISO7380_Pad; not fitted
J2, J3: Conn_01x04; JST_PH_S4B-PH-K_1x04_P2.00mm_Horizontal; LCSC C157926
SW1: SW_Left; SW_Push_1P1T_XKB_TS-1187A; LCSC C318884
SW2: SW_Right; SW_Push_1P1T_XKB_TS-1187A; LCSC C318884
SW3: SW_Up; SW_Push_1P1T_XKB_TS-1187A; LCSC C318884
SW4: SW_Down; SW_Push_1P1T_XKB_TS-1187A; LCSC C318884
SW5: SW_Enter; SW_Push_1P1T_XKB_TS-1187A; LCSC C318884
SW6: SW_Back; SW_Push_1P1T_XKB_TS-1187A; LCSC C318884
U2: adafruit_memory_display_27; not fitted

Connections:
+3V3: U2.1 (VIN); also elsewhere on the board
GND: J2.2, J2.4, J3.2, J3.4, SW1.1, SW2.1, SW3.1, SW4.1, SW5.1, SW6.1, U2.3 (GND); also elsewhere on the board
KEY_ARM: J3.1; also elsewhere on the board
KEY_BACK: SW6.2; also elsewhere on the board
KEY_DOWN: SW4.2; also elsewhere on the board
KEY_ENTER: SW5.2; also elsewhere on the board
KEY_FILL: J2.1; also elsewhere on the board
KEY_FIRE: J3.3; also elsewhere on the board
KEY_LEFT: SW1.2; also elsewhere on the board
KEY_RIGHT: SW2.2; also elsewhere on the board
KEY_UP: SW3.2; also elsewhere on the board
KEY_VENT: J2.3; also elsewhere on the board
LCD_CS: U2.6 (CS); also elsewhere on the board
LCD_DISP: U2.8 (DISP); also elsewhere on the board
LCD_MOSI: U2.5 (DI); also elsewhere on the board
LCD_SCK: U2.4 (CLK); also elsewhere on the board

Notes on the sheet:
Keys and switches pull their KEY_ line to GND; the ESP32 internal pull-ups are used.
EMD low (R1): VCOM is inverted by SPI command, as the firmware does now. Fit R2 instead of R1 to take VCOM from EIN (LCD_EXTCOMIN) so it keeps toggling in light sleep.

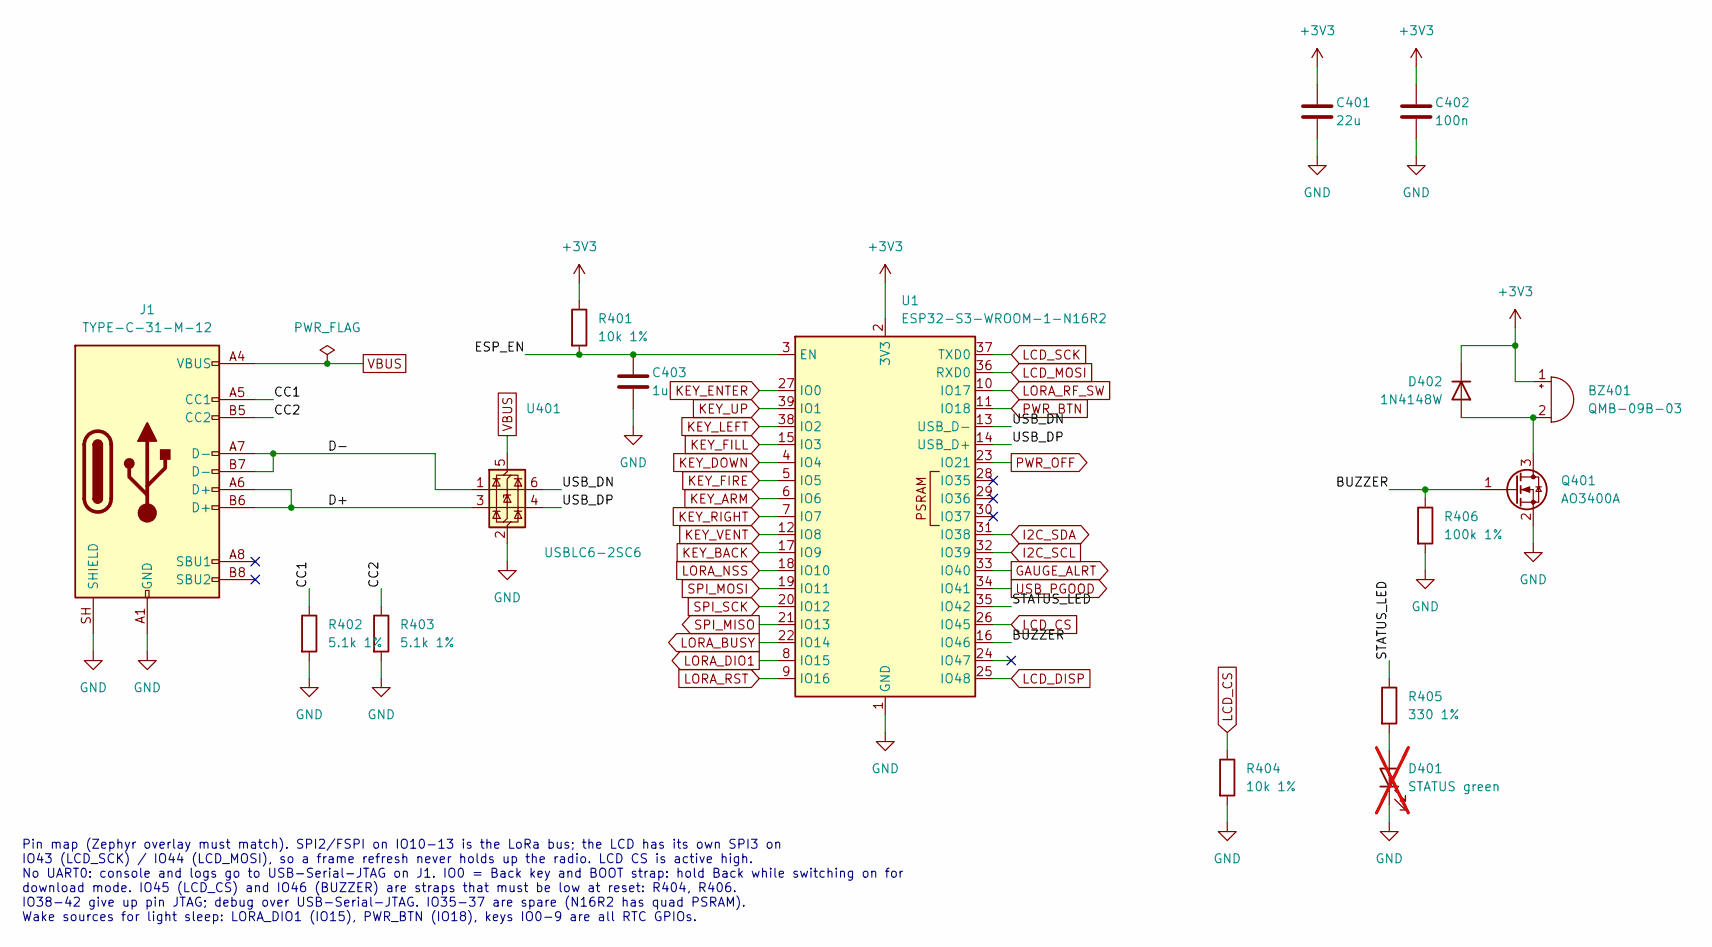
[picture p92: schematic mcu.kicad_sch]

Parts:
BZ401: QMB-09B-03; BUZ-TH_BD9.0-P4.00-D0.6-FD; LCSC C96256
C401: 22u; C_0603_1608Metric; LCSC C59461
C402: 100n; C_0603_1608Metric; LCSC C14663
C403: 1u; C_0603_1608Metric; LCSC C15849
D401: STATUS green; LED_D3.0mm; LCSC C12624; not fitted
D402: 1N4148W; D_SOD-123; LCSC C81598
J1: TYPE-C-31-M-12; USB_C_Receptacle_HRO_TYPE-C-31-M-12; LCSC C165948
Q401: AO3400A; SOT-23; LCSC C20917
R401, R404: 10k 1%; R_0603_1608Metric; LCSC C25804
R402, R403: 5.1k 1%; R_0603_1608Metric; LCSC C23186
R405: 330 1%; R_0603_1608Metric; LCSC C23138
R406: 100k 1%; R_0603_1608Metric; LCSC C25803
U1: ESP32-S3-WROOM-1-N16R2; ESP32-S3-WROOM-1; LCSC C2913205
U401: USBLC6-2SC6; SOT-23-6; LCSC C2687116

Connections:
+3V3: BZ401.1 (+), C401.1, C402.1, D402.1 (K), R401.1, U1.2 (3V3); also elsewhere on the board
/MCU/BUZZER: Q401.1 (G), R406.1, U1.16 (IO46)
/MCU/CC1: J1.A5 (CC1), R402.1
/MCU/CC2: J1.B5 (CC2), R403.1
/MCU/D+: J1.A6 (D+), J1.B6 (D+), U401.3 (I/O2)
/MCU/D-: J1.A7 (D-), J1.B7 (D-), U401.1 (I/O1)
/MCU/ESP_EN: C403.1, R401.2, U1.3 (EN)
/MCU/STATUS_LED: R405.1, U1.35 (IO42)
/MCU/USB_DN: U1.13 (USB_D-), U401.6 (I/O1)
/MCU/USB_DP: U1.14 (USB_D+), U401.4 (I/O2)
GAUGE_ALRT: U1.33 (IO40); also elsewhere on the board
GND: C401.2, C402.2, C403.2, D401.1 (K), J1.A1 (GND), J1.A12 (GND), J1.B1 (GND), J1.B12 (GND), J1.SH (SHIELD), Q401.2 (S), R402.2, R403.2, R404.2, R406.2, U1.1 (GND), U1.40 (GND), U1.41 (GND), U401.2 (GND); also elsewhere on the board
I2C_SCL: U1.32 (IO39); also elsewhere on the board
I2C_SDA: U1.31 (IO38); also elsewhere on the board
KEY_ARM: U1.6 (IO6); also elsewhere on the board
KEY_BACK: U1.17 (IO9); also elsewhere on the board
KEY_DOWN: U1.4 (IO4); also elsewhere on the board
KEY_ENTER: U1.27 (IO0); also elsewhere on the board
KEY_FILL: U1.15 (IO3); also elsewhere on the board
KEY_FIRE: U1.5 (IO5); also elsewhere on the board
KEY_LEFT: U1.38 (IO2); also elsewhere on the board
KEY_RIGHT: U1.7 (IO7); also elsewhere on the board
KEY_UP: U1.39 (IO1); also elsewhere on the board
KEY_VENT: U1.12 (IO8); also elsewhere on the board
LCD_CS: R404.1, U1.26 (IO45); also elsewhere on the board
LCD_DISP: U1.25 (IO48); also elsewhere on the board
LCD_MOSI: U1.36 (RXD0); also elsewhere on the board
LCD_SCK: U1.37 (TXD0); also elsewhere on the board
LORA_BUSY: U1.22 (IO14); also elsewhere on the board
LORA_DIO1: U1.8 (IO15); also elsewhere on the board
LORA_NSS: U1.18 (IO10); also elsewhere on the board
LORA_RF_SW: U1.10 (IO17); also elsewhere on the board
LORA_RST: U1.9 (IO16); also elsewhere on the board
unnamed: BZ401.2 (-), D402.2 (A), Q401.3 (D)
unnamed: D401.2 (A), R405.2
PWR_BTN: U1.11 (IO18); also elsewhere on the board
PWR_OFF: U1.23 (IO21); also elsewhere on the board
SPI_MISO: U1.21 (IO13); also elsewhere on the board
SPI_MOSI: U1.19 (IO11); also elsewhere on the board
SPI_SCK: U1.20 (IO12); also elsewhere on the board
USB_PGOOD: U1.34 (IO41); also elsewhere on the board
VBUS: J1.A4 (VBUS), J1.A9 (VBUS), J1.B4 (VBUS), J1.B9 (VBUS), U401.5 (VBUS); also elsewhere on the board

Notes on the sheet:
Pin map (Zephyr overlay must match). SPI2/FSPI on IO10-13 is the LoRa bus; the LCD has its own SPI3 on IO43 (LCD_SCK) / IO44 (LCD_MOSI), so a frame refresh never holds up the radio. LCD CS is active high. No UART0: console and logs go to USB-Serial-JTAG on J1. IO0 = Back key and BOOT strap: hold Ba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

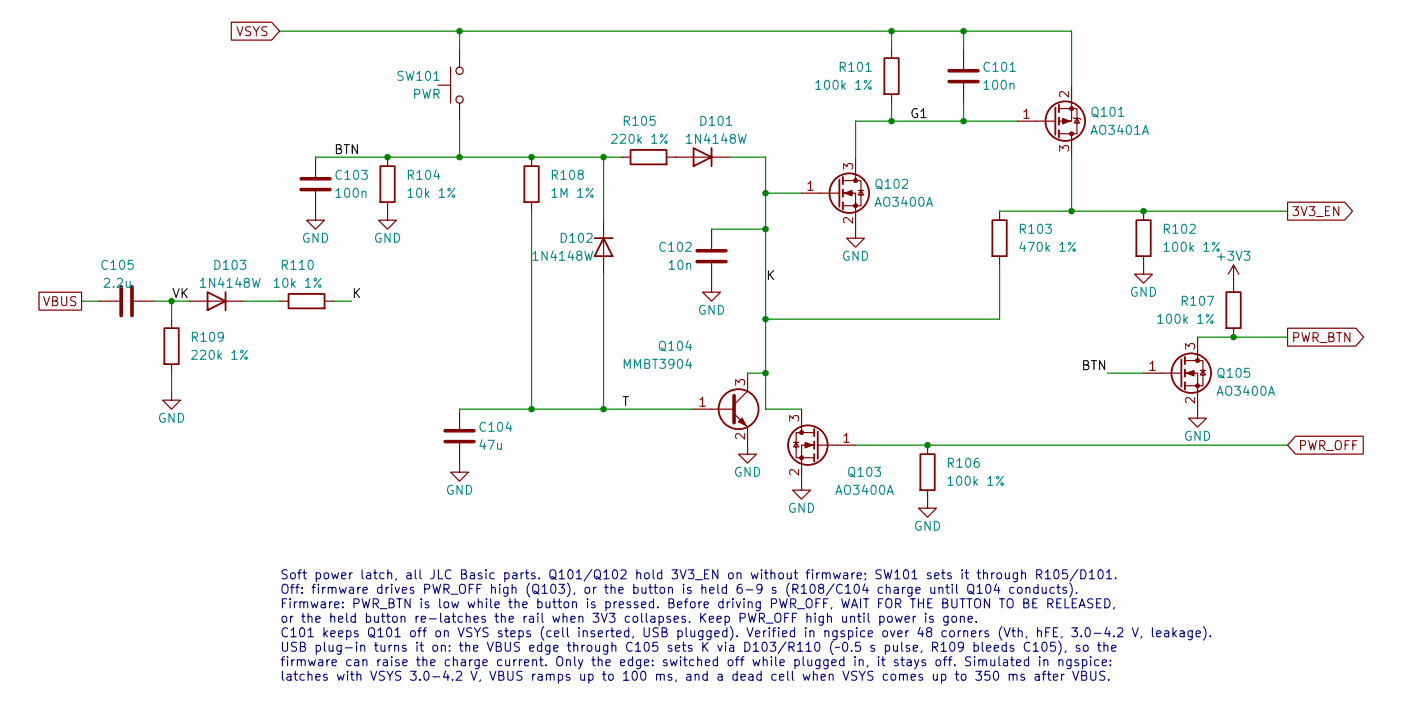
[picture p93: schematic power_latch.kicad_sch, Controller - power latch]

Parts:
C101, C103: 100n; C_0603_1608Metric; LCSC C14663
C102: 10n; C_0603_1608Metric; LCSC C57112
C104: 47u; C_0603_1608Metric; LCSC C140782
C105: 2.2u; C_0603_1608Metric; LCSC C23630
D101, D102, D103: 1N4148W; D_SOD-123; LCSC C81598
Q101: AO3401A; SOT-23; LCSC C15127
Q102, Q103, Q105: AO3400A; SOT-23; LCSC C20917
Q104: MMBT3904; SOT-23; LCSC C20526
R101, R102, R106, R107: 100k 1%; R_0603_1608Metric; LCSC C25803
R103: 470k 1%; R_0603_1608Metric; LCSC C23178
R104, R110: 10k 1%; R_0603_1608Metric; LCSC C25804
R105, R109: 220k 1%; R_0603_1608Metric; LCSC C22961
R108: 1M 1%; R_0603_1608Metric; LCSC C22935
SW101: PWR; SW_Push_1P1T-MP_NO_Horizontal_Alps_SKRTLAE010; LCSC C110293

Connections:
3V3_EN: Q101.3 (D), R102.1, R103.1; also elsewhere on the board
+3V3: R107.1; also elsewhere on the board
/power_latch/BTN: C103.1, D102.1 (K), Q105.1 (G), R104.1, R105.1, R108.1, SW101.1
/power_latch/G1: C101.2, Q101.1 (G), Q102.3 (D), R101.2
/power_latch/K: C102.1, D101.1 (K), Q102.1 (G), Q103.3 (D), Q104.3 (C), R103.2, R110.2
/power_latch/T: C104.1, D102.2 (A), Q104.1 (B), R108.2
/power_latch/VK: C105.2, D103.2 (A), R109.1
GND: C102.2, C103.2, C104.2, Q102.2 (S), Q103.2 (S), Q104.2 (E), Q105.2 (S), R102.2, R104.2, R106.2, R109.2; also elsewhere on the board
unnamed: D101.2 (A), R105.2
unnamed: D103.1 (K), R110.1
PWR_BTN: Q105.3 (D), R107.2; also elsewhere on the board
PWR_OFF: Q103.1 (G), R106.1; also elsewhere on the board
VBUS: C105.1; also elsewhere on the board
VSYS: C101.1, Q101.2 (S), R101.1, SW101.2; also elsewhere on the board

Notes on the sheet:
Soft power latch, all JLC Basic parts. Q101/Q102 hold 3V3_EN on without firmware; SW101 sets it through R105/D101. Off: firmware drives PWR_OFF high (Q103), or the button is held 6-9 s (R108/C104 charge until Q104 conducts). Firmware: PWR_BTN is low while the button is pressed. Before driving PWR_O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

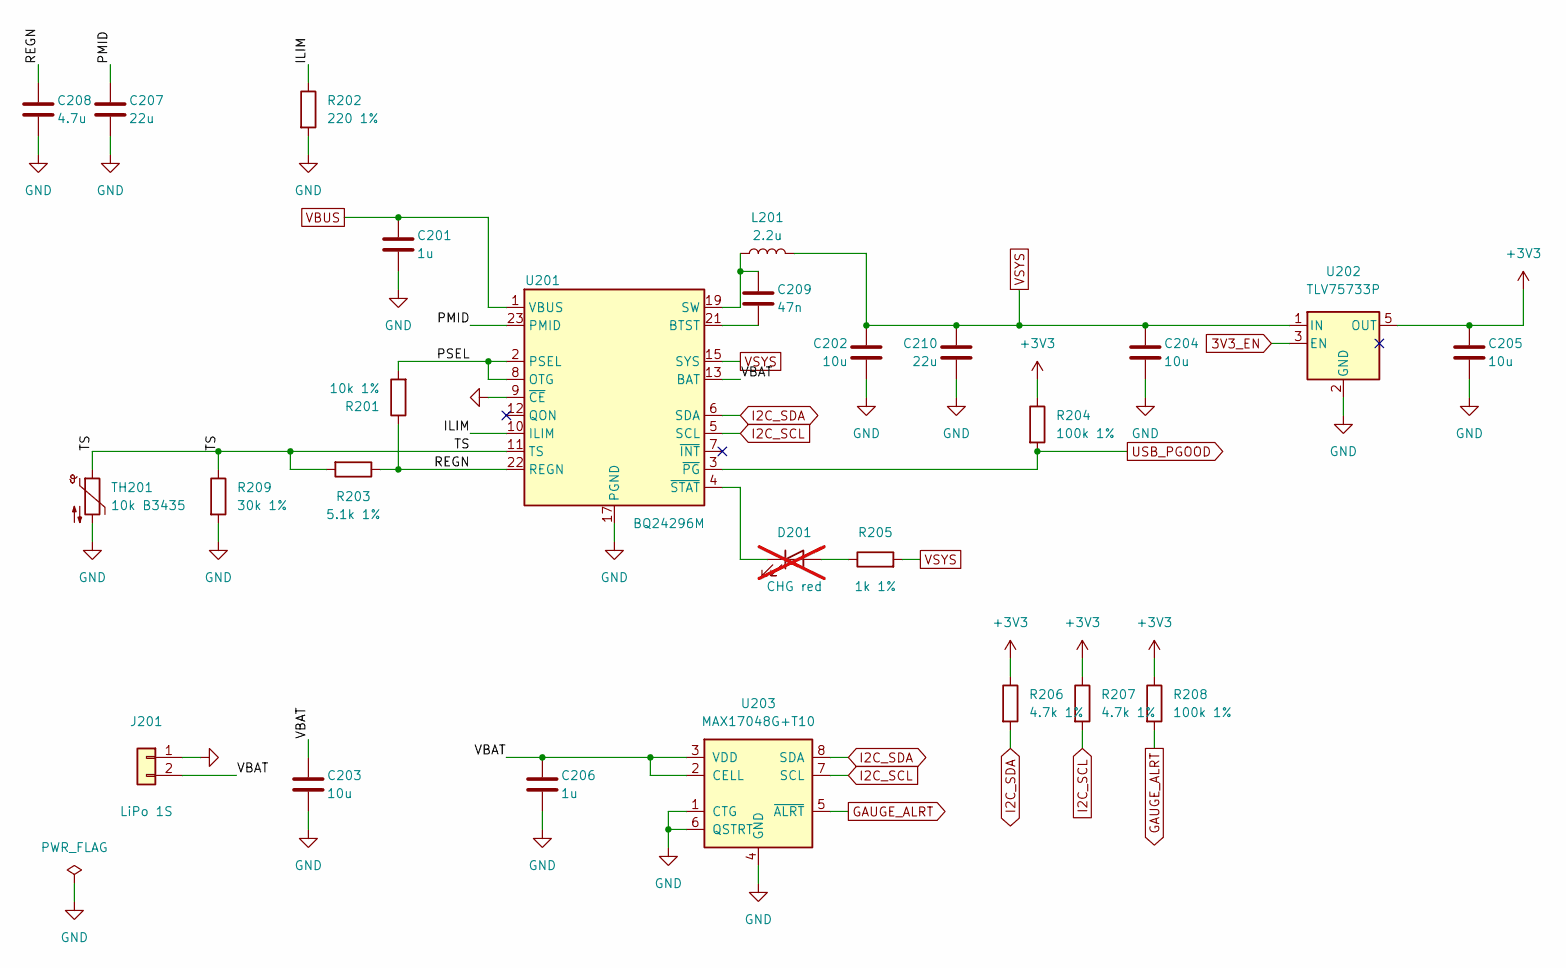
[picture p94: schematic power.kicad_sch, Controller - power]

Parts:
C201, C206: 1u; C_0603_1608Metric; LCSC C15849
C202, C203, C204, C205: 10u; C_0603_1608Metric; LCSC C19702
C207, C210: 22u; C_0805_2012Metric; LCSC C45783
C208: 4.7u; C_0603_1608Metric; LCSC C19666
C209: 47n; C_0603_1608Metric; LCSC C1622
D201: CHG red; LED_D3.0mm; LCSC C2286; not fitted
J201: LiPo 1S; JST_PH_S2B-PH-K_1x02_P2.00mm_Horizontal; LCSC C173752
L201: 2.2u; L_Taiyo-Yuden_NR-40xx; LCSC C135262
R201: 10k 1%; R_0603_1608Metric; LCSC C25804
R202: 220 1%; R_0603_1608Metric; LCSC C22962
R203: 5.1k 1%; R_0603_1608Metric; LCSC C23186
R204, R208: 100k 1%; R_0603_1608Metric; LCSC C25803
R205: 1k 1%; R_0603_1608Metric; LCSC C21190
R206, R207: 4.7k 1%; R_0603_1608Metric; LCSC C23162
R209: 30k 1%; R_0603_1608Metric; LCSC C22984
TH201: 10k B3435; R_0603_1608Metric; LCSC C2889048
U201: BQ24296M; Texas_RGE0024H_VQFN-24-1EP_4x4mm_P0.5mm_EP2.7x2.7mm_Thermal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; LCSC C130450
U202: TLV75733P; SOT-23-5; LCSC C485517
U203: MAX17048G+T10; TDFN-8-1EP_2x2mm_P0.5mm_EP0.8x1.2mm; LCSC C2682616

Connections:
3V3_EN: U202.3 (EN); also elsewhere on the board
+3V3: C205.1, R204.1, R206.1, R207.1, R208.1, U202.5 (OUT); also elsewhere on the board
/power/ILIM: R202.1, U201.10 (ILIM)
/power/PMID: C207.1, U201.23 (PMID)
/power/PSEL: R201.2, U201.2 (PSEL), U201.8 (OTG)
/power/REGN: C208.1, R201.1, R203.1, U201.22 (REGN)
/power/TS: R203.2, R209.1, TH201.1, U201.11 (TS)
/power/VBAT: C203.1, C206.1, J201.2, U201.13 (BAT), U201.14 (BAT), U203.2 (CELL), U203.3 (VDD)
GAUGE_ALRT: R208.2, U203.5 (~ALRT); also elsewhere on the board
GND: C201.2, C202.2, C203.2, C204.2, C205.2, C206.2, C207.2, C208.2, C210.2, J201.1, R202.2, R209.2, TH201.2, U201.9 (~CE), U201.17 (PGND), U201.18 (PGND), U201.25 (PGND), U202.2 (GND), U203.1 (CTG), U203.4 (GND), U203.6 (QSTRT), U203.9 (EP); also elsewhere on the board
I2C_SCL: R207.2, U201.5 (SCL), U203.7 (SCL); also elsewhere on the board
I2C_SDA: R206.2, U201.6 (SDA), U203.8 (SDA); also elsewhere on the board
unnamed: C209.1, L201.1, U201.19 (SW), U201.20 (SW)
unnamed: D201.2 (A), R205.1
unnamed: D201.1 (K), U201.4 (~STAT)
unnamed: C209.2, U201.21 (BTST)
USB_PGOOD: R204.2, U201.3 (~PG); also elsewhere on the board
VBUS: C201.1, U201.1 (VBUS), U201.24 (VBUS); also elsewhere on the board
VSYS: C202.1, C204.1, C210.1, L201.2, R205.2, U201.15 (SYS), U201.16 (SYS), U202.1 (IN); also elsewhere on the board

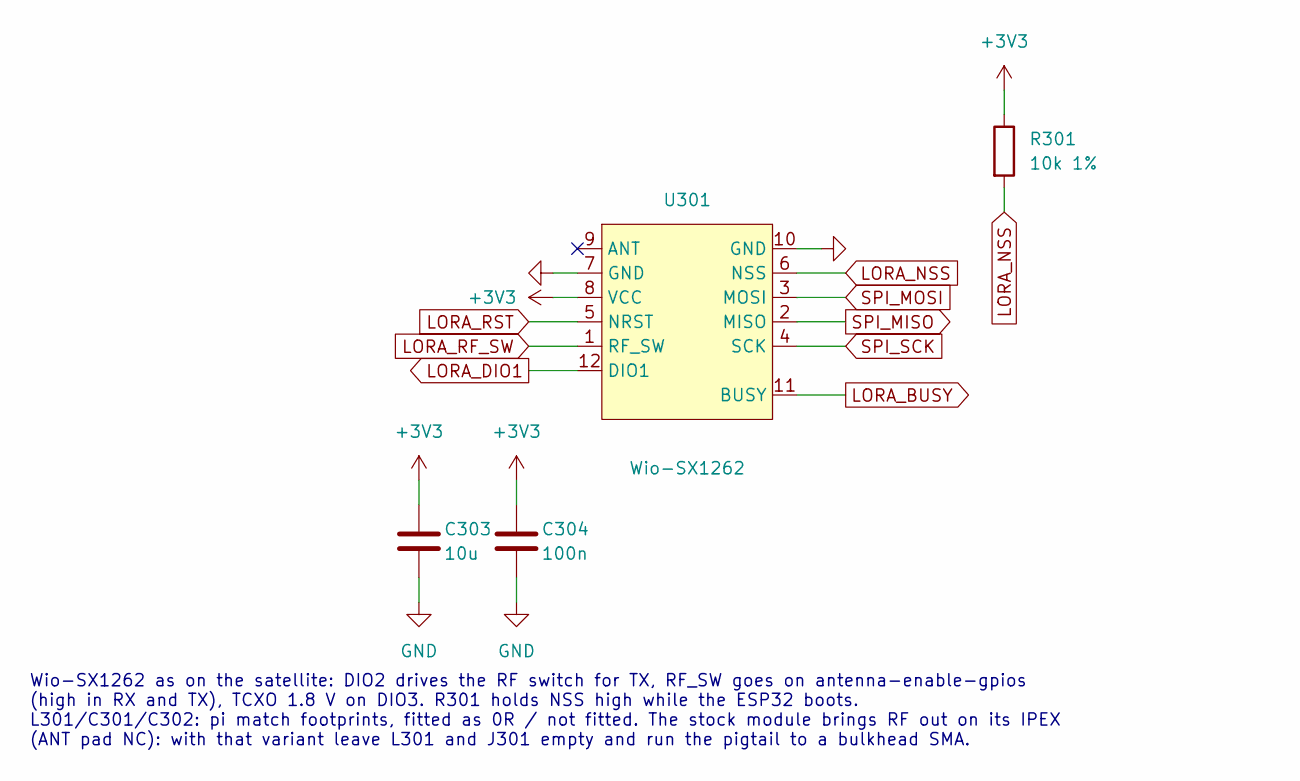
[picture p95: schematic radio.kicad_sch, Controller - radio]

Parts:
C303: 10u; C_0603_1608Metric; LCSC C19702
C304: 100n; C_0603_1608Metric; LCSC C14663
R301: 10k 1%; R_0603_1608Metric; LCSC C25804
U301: Wio-SX1262; WIRELM-SMD_WIO-SX1262

Connections:
+3V3: C303.1, C304.1, R301.1, U301.8 (VCC); also elsewhere on the board
GND: C303.2, C304.2, U301.7 (GND), U301.10 (GND); also elsewhere on the board
LORA_BUSY: U301.11 (BUSY); also elsewhere on the board
LORA_DIO1: U301.12 (DIO1); also elsewhere on the board
LORA_NSS: R301.2, U301.6 (NSS); also elsewhere on the board
LORA_RF_SW: U301.1 (RF_SW); also elsewhere on the board
LORA_RST: U301.5 (NRST); also elsewhere on the board
SPI_MISO: U301.2 (MISO); also elsewhere on the board
SPI_MOSI: U301.3 (MOSI); also elsewhere on the board
SPI_SCK: U301.4 (SCK); also elsewhere on the board

Notes on the sheet:
Wio-SX1262 as on the satellite: DIO2 drives the RF switch for TX, RF_SW goes on antenna-enable-gpios (high in RX and TX), TCXO 1.8 V on DIO3. R301 holds NSS high while the ESP32 boots. L301/C301/C302: pi match footprints, fitted as 0R / not fitted. The stock module brings RF out on its IPEX (ANT pa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

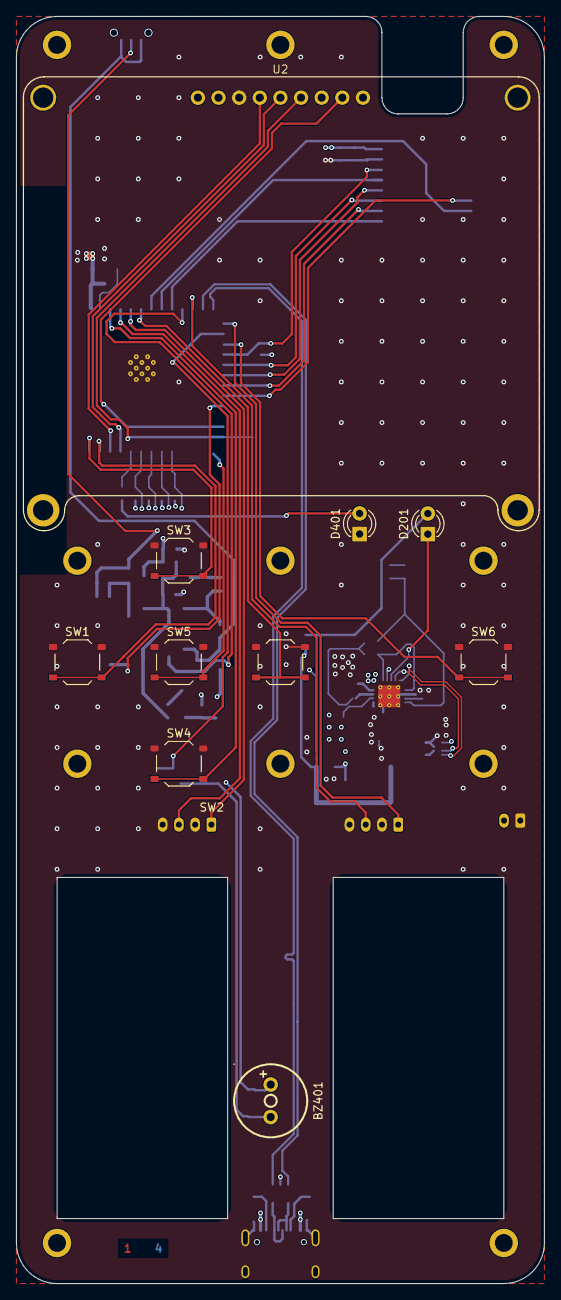
[picture p96: board controller.kicad_pcb from above]

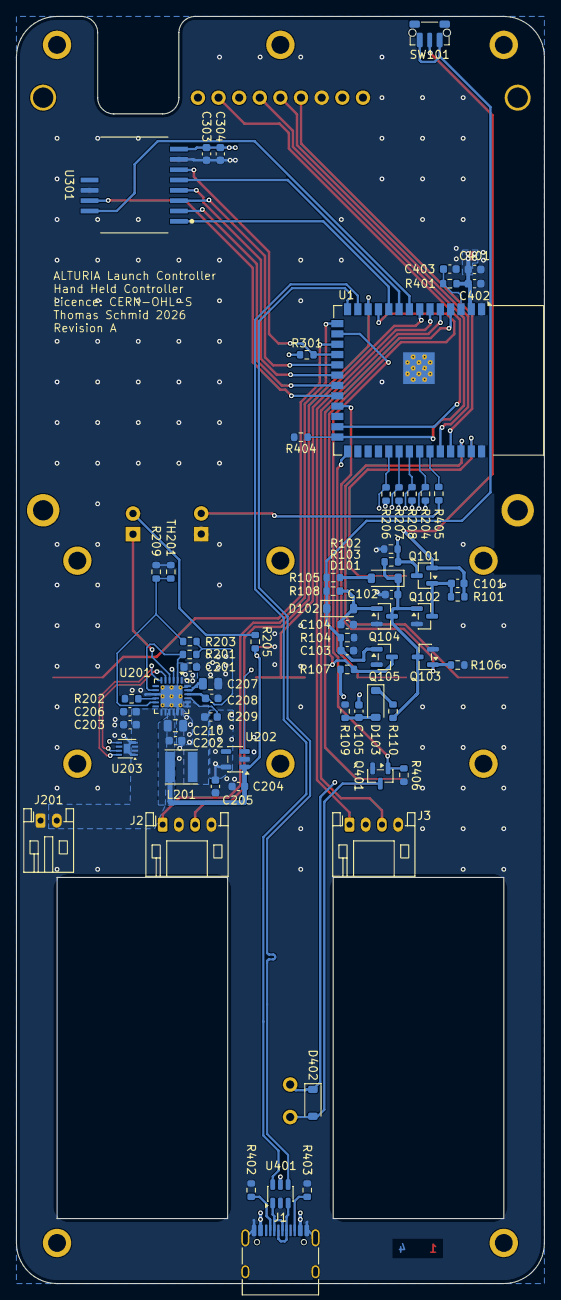
[picture p97: board controller.kicad_pcb from below]

Board: 4 copper layers, 65.0 x 156.0 mm, 90 parts (69 on the bottom side), 61 nets.
