rckTom/alturia-launch-control/hardware/satellite/pcb/satellite.kicad_pcb

## KiCad design hardware/satellite/pcb/satellite.kicad_pcb (2026-11-05)

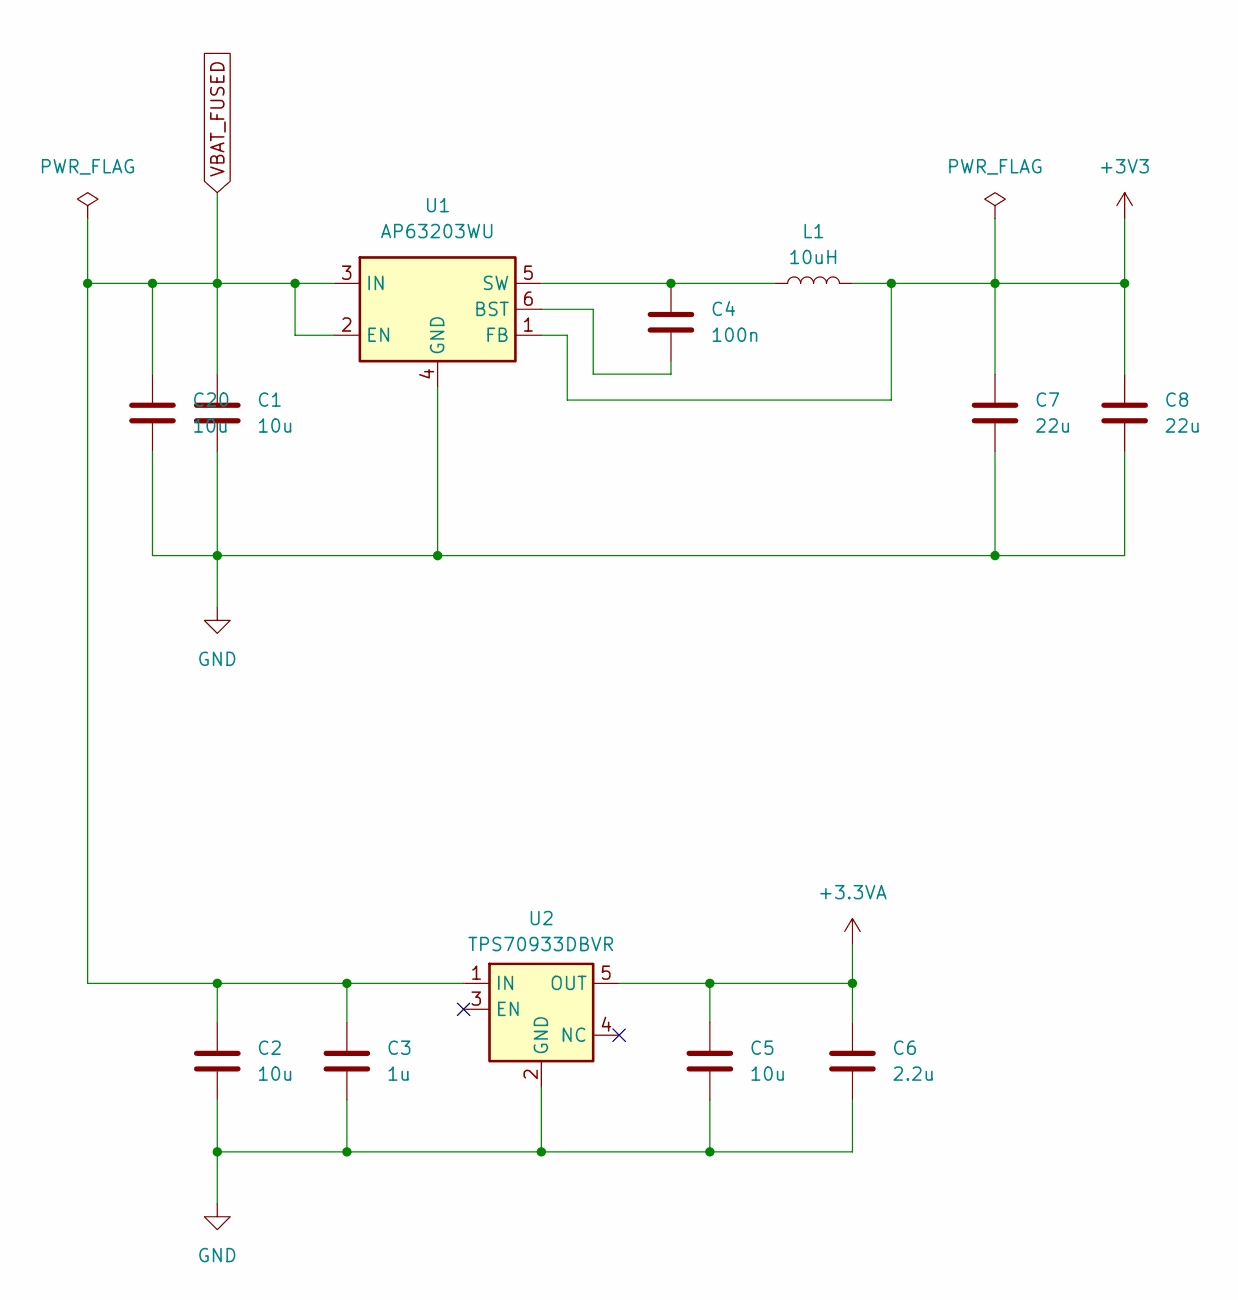
[picture p98: schematic 01_power.kicad_sch, Launch pad satellite — Power input and rails]

Parts:
C1, C2, C5, C20: 10u; C_0805_2012Metric; LCSC C440198
C3: 1u; C_0805_2012Metric; LCSC C28323
C4: 100n; C_0603_1608Metric; LCSC C14663
C6: 2.2u; C_0805_2012Metric; LCSC C19110
C7, C8: 22u; C_0805_2012Metric; LCSC C45783
L1: 10uH; L_Cenker_CKCS6045; LCSC C168076
U1: AP63203WU; TSOT-23-6; LCSC C780769
U2: TPS70933DBVR; SOT-23-5; LCSC C89347

Connections:
+3.3VA: C5.1, C6.1, U2.5 (OUT); also elsewhere on the board
+3V3: C7.1, C8.1, L1.2, U1.1 (FB); also elsewhere on the board
GND: C1.2, C2.2, C3.2, C5.2, C6.2, C7.2, C8.2, C20.2, U1.4 (GND), U2.2 (GND); also elsewhere on the board
unnamed: C4.2, U1.6 (BST)
unnamed: C4.1, L1.1, U1.5 (SW)
VBAT_FUSED: C1.1, C2.1, C3.1, C20.1, U1.2 (EN), U1.3 (IN), U2.1 (IN); also elsewhere on the board
