rckTom/alturia-launch-control/hardware/satellite/pcb/satellite.kicad_pcb

## KiCad design hardware/satellite/pcb/satellite.kicad_pcb (continued)

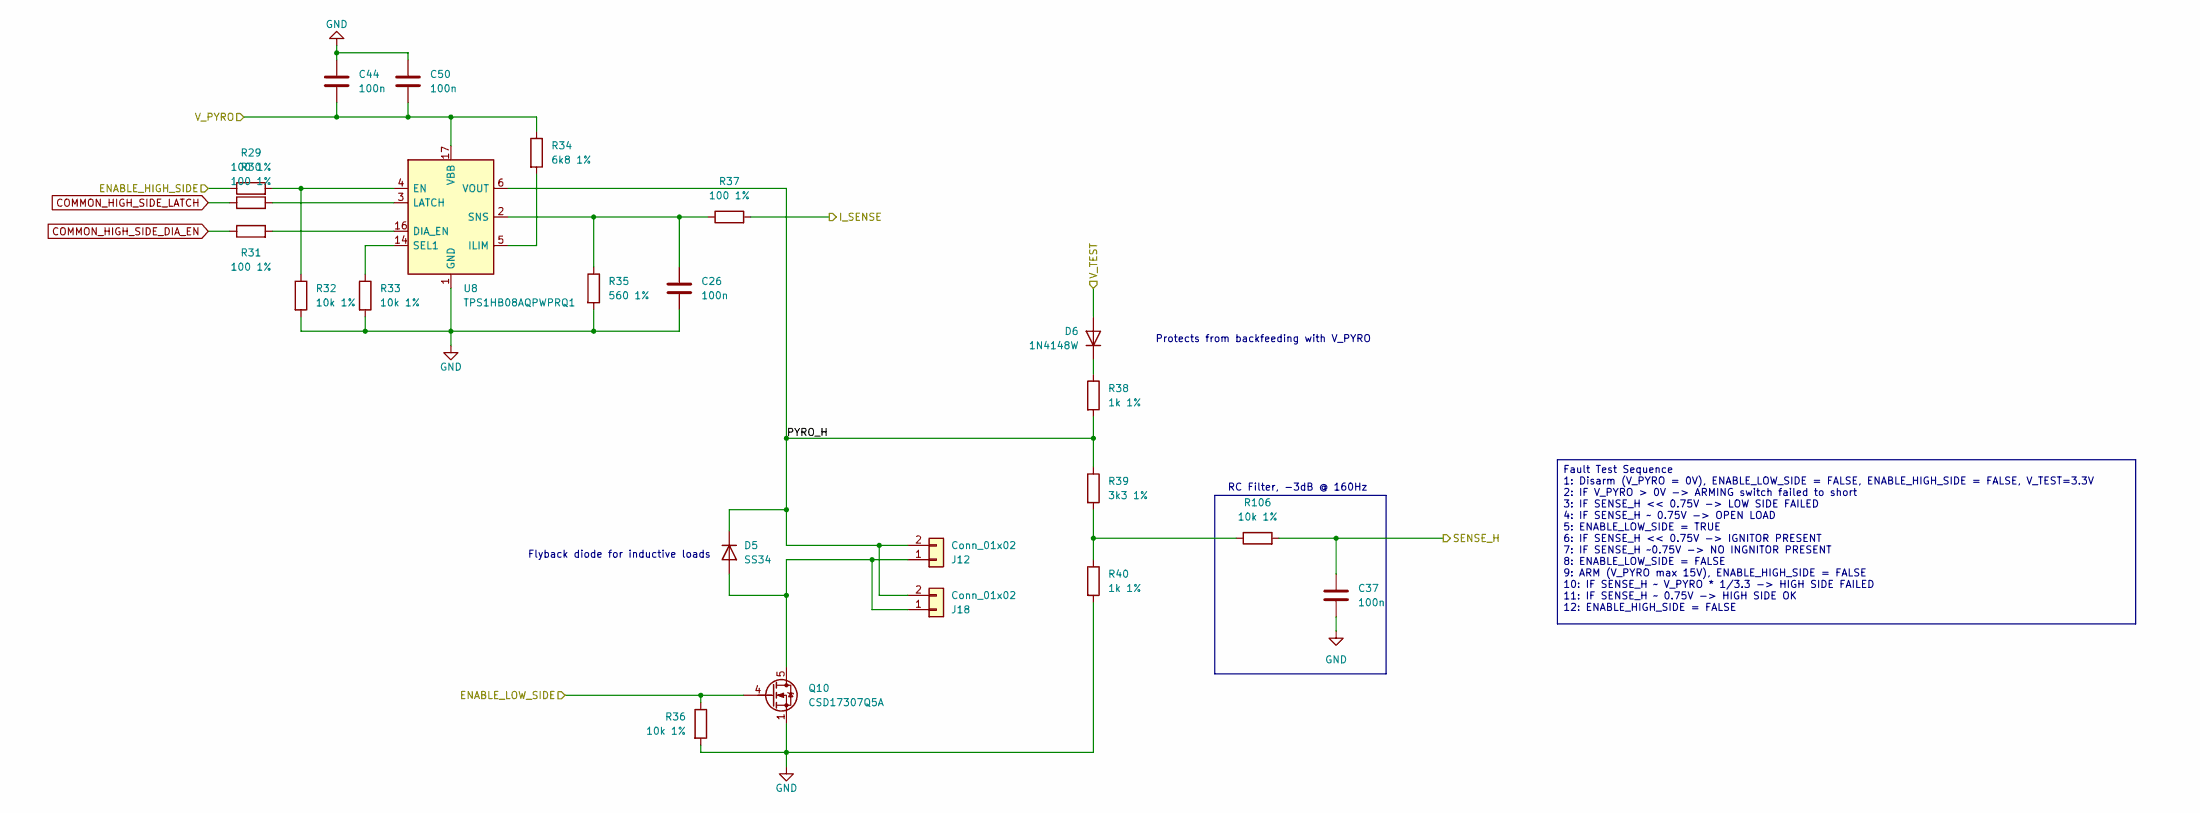
[picture p99: schematic output_channel.kicad_sch, Launch pad satellite — Pyro output stage]

Parts:
C26, C37, C44, C50: 100n; C_0603_1608Metric; LCSC C14663
D5: SS34; D_SMA; LCSC C8678
D6: 1N4148W; D_SOD-123; LCSC C81598
J12: Conn_01x02; TerminalBlock_CUI_TB007-508-02_1x02_P5.08mm_Horizontal
J18: Conn_01x02; BananJack
Q10: CSD17307Q5A; TDSON-8-1; LCSC C139362
R29, R30, R31, R37: 100 1%; R_0603_1608Metric; LCSC C22775
R32, R33, R36, R106: 10k 1%; R_0603_1608Metric; LCSC C25804
R34: 6k8 1%; R_0603_1608Metric; LCSC C23212
R35: 560 1%; R_0603_1608Metric; LCSC C23204
R38, R40: 1k 1%; R_0603_1608Metric; LCSC C21190
R39: 3k3 1%; R_0603_1608Metric; LCSC C22978
U8: TPS1HB08AQPWPRQ1; HTSSOP-16-1EP_4.4x5mm_P0.65mm_EP3.4x5mm_Mask2.78x3.37mm_The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; MPN TPS1HB08AQPWPRQ1; LCSC Part C3019223

Connections:
/PyroStage3/PYRO_H: D5.1 (K), J12.2, J18.2, R38.2, R39.1, U8.6 (VOUT), U8.7 (VOUT), U8.8 (VOUT), U8.9 (VOUT), U8.10 (VOUT), U8.11 (VOUT)
COMMON_HIGH_SIDE_DIA_EN: R31.1; also elsewhere on the board
COMMON_HIGH_SIDE_LATCH: R30.1; also elsewhere on the board
ENABLE_P3_HIGH: R29.1; also elsewhere on the board
ENABLE_P3_LOW: Q10.4 (G), R36.1; also elsewhere on the board
GND: C26.2, C37.2, C44.1, C50.1, Q10.1 (S), Q10.2 (S), Q10.3 (S), R32.2, R33.2, R35.2, R36.2, R40.2, U8.1 (GND); also elsewhere on the board
unnamed: D5.2 (A), J12.1, J18.1, Q10.5 (D)
unnamed: D6.1 (K), R38.1
unnamed: R39.2, R40.1, R106.1
unnamed: R31.2, U8.16 (DIA_EN)
unnamed: R29.2, R32.1, U8.4 (EN)
unnamed: R34.2, U8.5 (ILIM)
unnamed: R30.2, U8.3 (LATCH)
unnamed: R33.1, U8.14 (SEL1)
unnamed: C26.1, R35.1, R37.1, U8.2 (SNS)
SENSE_H_P3: C37.1, R106.2; also elsewhere on the board
SENSE_I_P3: R37.2; also elsewhere on the board
V_PYRO_ARMED: C44.2, C50.2, R34.1, U8.17 (VBB); also elsewhere on the board
V_TEST: D6.2 (A); also elsewhere on the board

Parts of its further copies:
C27, C28, C29, C35, C36, C38, C39, C40, C41, C42, C45, C46, C47, C48, C49, C51, C52, C53, C54, C55: 100n; C_0603_1608Metric; LCSC C14663
D7, D9, D11, D13, D15: SS34; D_SMA; LCSC C8678
D8, D10, D12, D14, D16: 1N4148W; D_SOD-123; LCSC C81598
J13, J14, J15, J16, J17: Conn_01x02; TerminalBlock_CUI_TB007-508-02_1x02_P5.08mm_Horizontal
J19, J20, J21, J22, J23: Conn_01x02; BananJack
Q11, Q12, Q13, Q14, Q15: CSD17307Q5A; TDSON-8-1; LCSC C139362
R41, R42, R43, R49, R53, R54, R55, R61, R65, R66, R67, R73, R77, R78, R79, R85, R89, R90, R91, R97: 100 1%; R_0603_1608Metric; LCSC C22775
R44, R45, R48, R56, R57, R60, R68, R69, R72, R80, R81, R84, R92, R93, R96, R107, R108, R109, R110, R111: 10k 1%; R_0603_1608Metric; LCSC C25804
R46, R58, R70, R82, R94: 6k8 1%; R_0603_1608Metric; LCSC C23212
R47, R59, R71, R83, R95: 560 1%; R_0603_1608Metric; LCSC C23204
R50, R52, R62, R64, R74, R76, R86, R88, R98, R100: 1k 1%; R_0603_1608Metric; LCSC C21190
R51, R63, R75, R87, R99: 3k3 1%; R_0603_1608Metric; LCSC C22978
U9, U10, U11, U14, U15: TPS1HB08AQPWPRQ1; HTSSOP-16-1EP_4.4x5mm_P0.65mm_EP3.4x5mm_Mask2.78x3.37mm_The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; MPN TPS1HB08AQPWPRQ1; LCSC Part C3019223

Connections of its further copies:
/PyroStage1/PYRO_H: D15.1 (K), J17.2, J23.2, R98.2, R99.1, U15.6 (VOUT), U15.7 (VOUT), U15.8 (VOUT), U15.9 (VOUT), U15.10 (VOUT), U15.11 (VOUT)
/PyroStage2/PYRO_H: D13.1 (K), J16.2, J22.2, R86.2, R87.1, U14.6 (VOUT), U14.7 (VOUT), U14.8 (VOUT), U14.9 (VOUT), U14.10 (VOUT), U14.11 (VOUT)
/PyroStage4/PYRO_H: D7.1 (K), J13.2, J19.2, R50.2, R51.1, U9.6 (VOUT), U9.7 (VOUT), U9.8 (VOUT), U9.9 (VOUT), U9.10 (VOUT), U9.11 (VOUT)
/PyroStage5/PYRO_H: D9.1 (K), J14.2, J20.2, R62.2, R63.1, U10.6 (VOUT), U10.7 (VOUT), U10.8 (VOUT), U10.9 (VOUT), U10.10 (VOUT), U10.11 (VOUT)
/PyroStage6/PYRO_H: D11.1 (K), J15.2, J21.2, R74.2, R75.1, U11.6 (VOUT), U11.7 (VOUT), U11.8 (VOUT), U11.9 (VOUT), U11.10 (VOUT), U11.11 (VOUT)
COMMON_HIGH_SIDE_DIA_EN: R43.1, R55.1, R67.1, R79.1, R91.1; also elsewhere on the board
COMMON_HIGH_SIDE_LATCH: R42.1, R54.1, R66.1, R78.1, R90.1; also elsewhere on the board
ENABLE_P1_HIGH: R89.1; also elsewhere on the board
ENABLE_P1_LOW: Q15.4 (G), R96.1; also elsewhere on the board
ENABLE_P2_HIGH: R77.1; also elsewhere on the board
ENABLE_P2_LOW: Q14.4 (G), R84.1; also elsewhere on the board
ENABLE_P4_HIGH: R41.1; also elsewhere on the board
ENABLE_P4_LOW: Q11.4 (G), R48.1; also elsewhere on the board
ENABLE_P5_HIGH: R53.1; also elsewhere on the board
ENABLE_P5_LOW: Q12.4 (G), R60.1; also elsewhere on the board
ENABLE_P6_HIGH: R65.1; also elsewhere on the board
ENABLE_P6_LOW: Q13.4 (G), R72.1; also elsewhere on the board
GND: C27.2, C28.2, C29.2, C35.2, C36.2, C38.2, C39.2, C40.2, C41.2, C42.2, C45.1, C46.1, C47.1, C48.1, C49.1, C51.1, C52.1, C53.1, C54.1, C55.1, Q11.1 (S), Q11.2 (S), Q11.3 (S), Q12.1 (S), Q12.2 (S), Q12.3 (S), Q13.1 (S), Q13.2 (S), Q13.3 (S), Q14.1 (S), Q14.2 (S), Q14.3 (S), Q15.1 (S), Q15.2 (S), Q15.3 (S), R44.2, R45.2, R47.2, R48.2, R52.2, R56.2, R57.2, R59.2, R60.2, R64.2, R68.2, R69.2, R71.2, R72.2, R76.2, R80.2, R81.2, R83.2, R84.2, R88.2, R92.2, R93.2, R95.2, R96.2, R100.2, U9.1 (GND), U10.1 (GND), U11.1 (GND), U14.1 (GND), U15.1 (GND); also elsewhere on the board
unnamed: D7.2 (A), J13.1, J19.1, Q11.5 (D)
unnamed: D8.1 (K), R50.1
unnamed: D9.2 (A), J14.1, J20.1, Q12.5 (D)
unnamed: D10.1 (K), R62.1
unnamed: D11.2 (A), J15.1, J21.1, Q13.5 (D)
unnamed: D12.1 (K), R74.1
unnamed: D13.2 (A), J16.1, J22.1, Q14.5 (D)
unnamed: D14.1 (K), R86.1
unnamed: D15.2 (A), J17.1, J23.1, Q15.5 (D)
unnamed: D16.1 (K), R98.1
unnamed: R99.2, R100.1, R111.1
unnamed: R51.2, R52.1, R107.1
unnamed: R63.2, R64.1, R108.1
unnamed: R75.2, R76.1, R109.1
unnamed: R87.2, R88.1, R110.1
unnamed: R43.2, U9.16 (DIA_EN)
unnamed: R41.2, R44.1, U9.4 (EN)
unnamed: R46.2, U9.5 (ILIM)
unnamed: R42.2, U9.3 (LATCH)
unnamed: R45.1, U9.14 (SEL1)
unnamed: C27.1, R47.1, R49.1, U9.2 (SNS)
unnamed: R55.2, U10.16 (DIA_EN)
unnamed: R53.2, R56.1, U10.4 (EN)
unnamed: R58.2, U10.5 (ILIM)
unnamed: R54.2, U10.3 (LATCH)
unnamed: R57.1, U10.14 (SEL1)
unnamed: C28.1, R59.1, R61.1, U10.2 (SNS)
unnamed: R67.2, U11.16 (DIA_EN)
unnamed: R65.2, R68.1, U11.4 (EN)
unnamed: R70.2, U11.5 (ILIM)
unnamed: R66.2, U11.3 (LATCH)
unnamed: R69.1, U11.14 (SEL1)
unnamed: C29.1, R71.1, R73.1, U11.2 (SNS)
unnamed: R79.2, U14.16 (DIA_EN)
unnamed: R77.2, R80.1, U14.4 (EN)
unnamed: R82.2, U14.5 (ILIM)
unnamed: R78.2, U14.3 (LATCH)
unnamed: R81.1, U14.14 (SEL1)
unnamed: C35.1, R83.1, R85.1, U14.2 (SNS)
unnamed: R91.2, U15.16 (DIA_EN)
unnamed: R89.2, R92.1, U15.4 (EN)
unnamed: R94.2, U15.5 (ILIM)
unnamed: R90.2, U15.3 (LATCH)
unnamed: R93.1, U15.14 (SEL1)
unnamed: C36.1, R95.1, R97.1, U15.2 (SNS)
SENSE_H_P1: C42.1, R111.2; also elsewhere on the board
SENSE_H_P2: C41.1, R110.2; also elsewhere on the board
SENSE_H_P4: C38.1, R107.2; also elsewhere on the board
SENSE_H_P5: C39.1, R108.2; also elsewhere on the board
SENSE_H_P6: C40.1, R109.2; also elsewhere on the board
SENSE_I_P1: R97.2; also elsewhere on the board
SENSE_I_P2: R85.2; also elsewhere on the board
SENSE_I_P4: R49.2; also elsewhere on the board
SENSE_I_P5: R61.2; also elsewhere on the board
SENSE_I_P6: R73.2; also elsewhere on the board
V_PYRO_ARMED: C45.2, C46.2, C47.2, C48.2, C49.2, C51.2, C52.2, C53.2, C54.2, C55.2, R46.1, R58.1, R70.1, R82.1, R94.1, U9.17 (VBB), U10.17 (VBB), U11.17 (VBB), U14.17 (VBB), U15.17 (VBB); also elsewhere on the board
V_TEST: D8.2 (A), D10.2 (A), D12.2 (A), D14.2 (A), D16.2 (A); also elsewhere on the board

Notes on the sheet:
Protects from backfeeding with V_PYRO
Flyback diode for inductive loads
RC Filter, -3dB @ 160Hz
Fault Test Sequence 1: Disarm (V_PYRO = 0V), ENABLE_LOW_SIDE = FALSE, ENABLE_HIGH_SIDE = FALSE, V_TEST=3.3V 2: IF V_PYRO > 0V -> ARMING switch failed to short 3: IF SENSE_H << 0.75V -> LOW SIDE FAILED 4: IF SENSE_H ~ 0.75V -> OPEN LOAD 5: ENABLE_LOW_SIDE = TRUE 6: IF SENSE_H << 0.75V -> IGNITOR PRE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

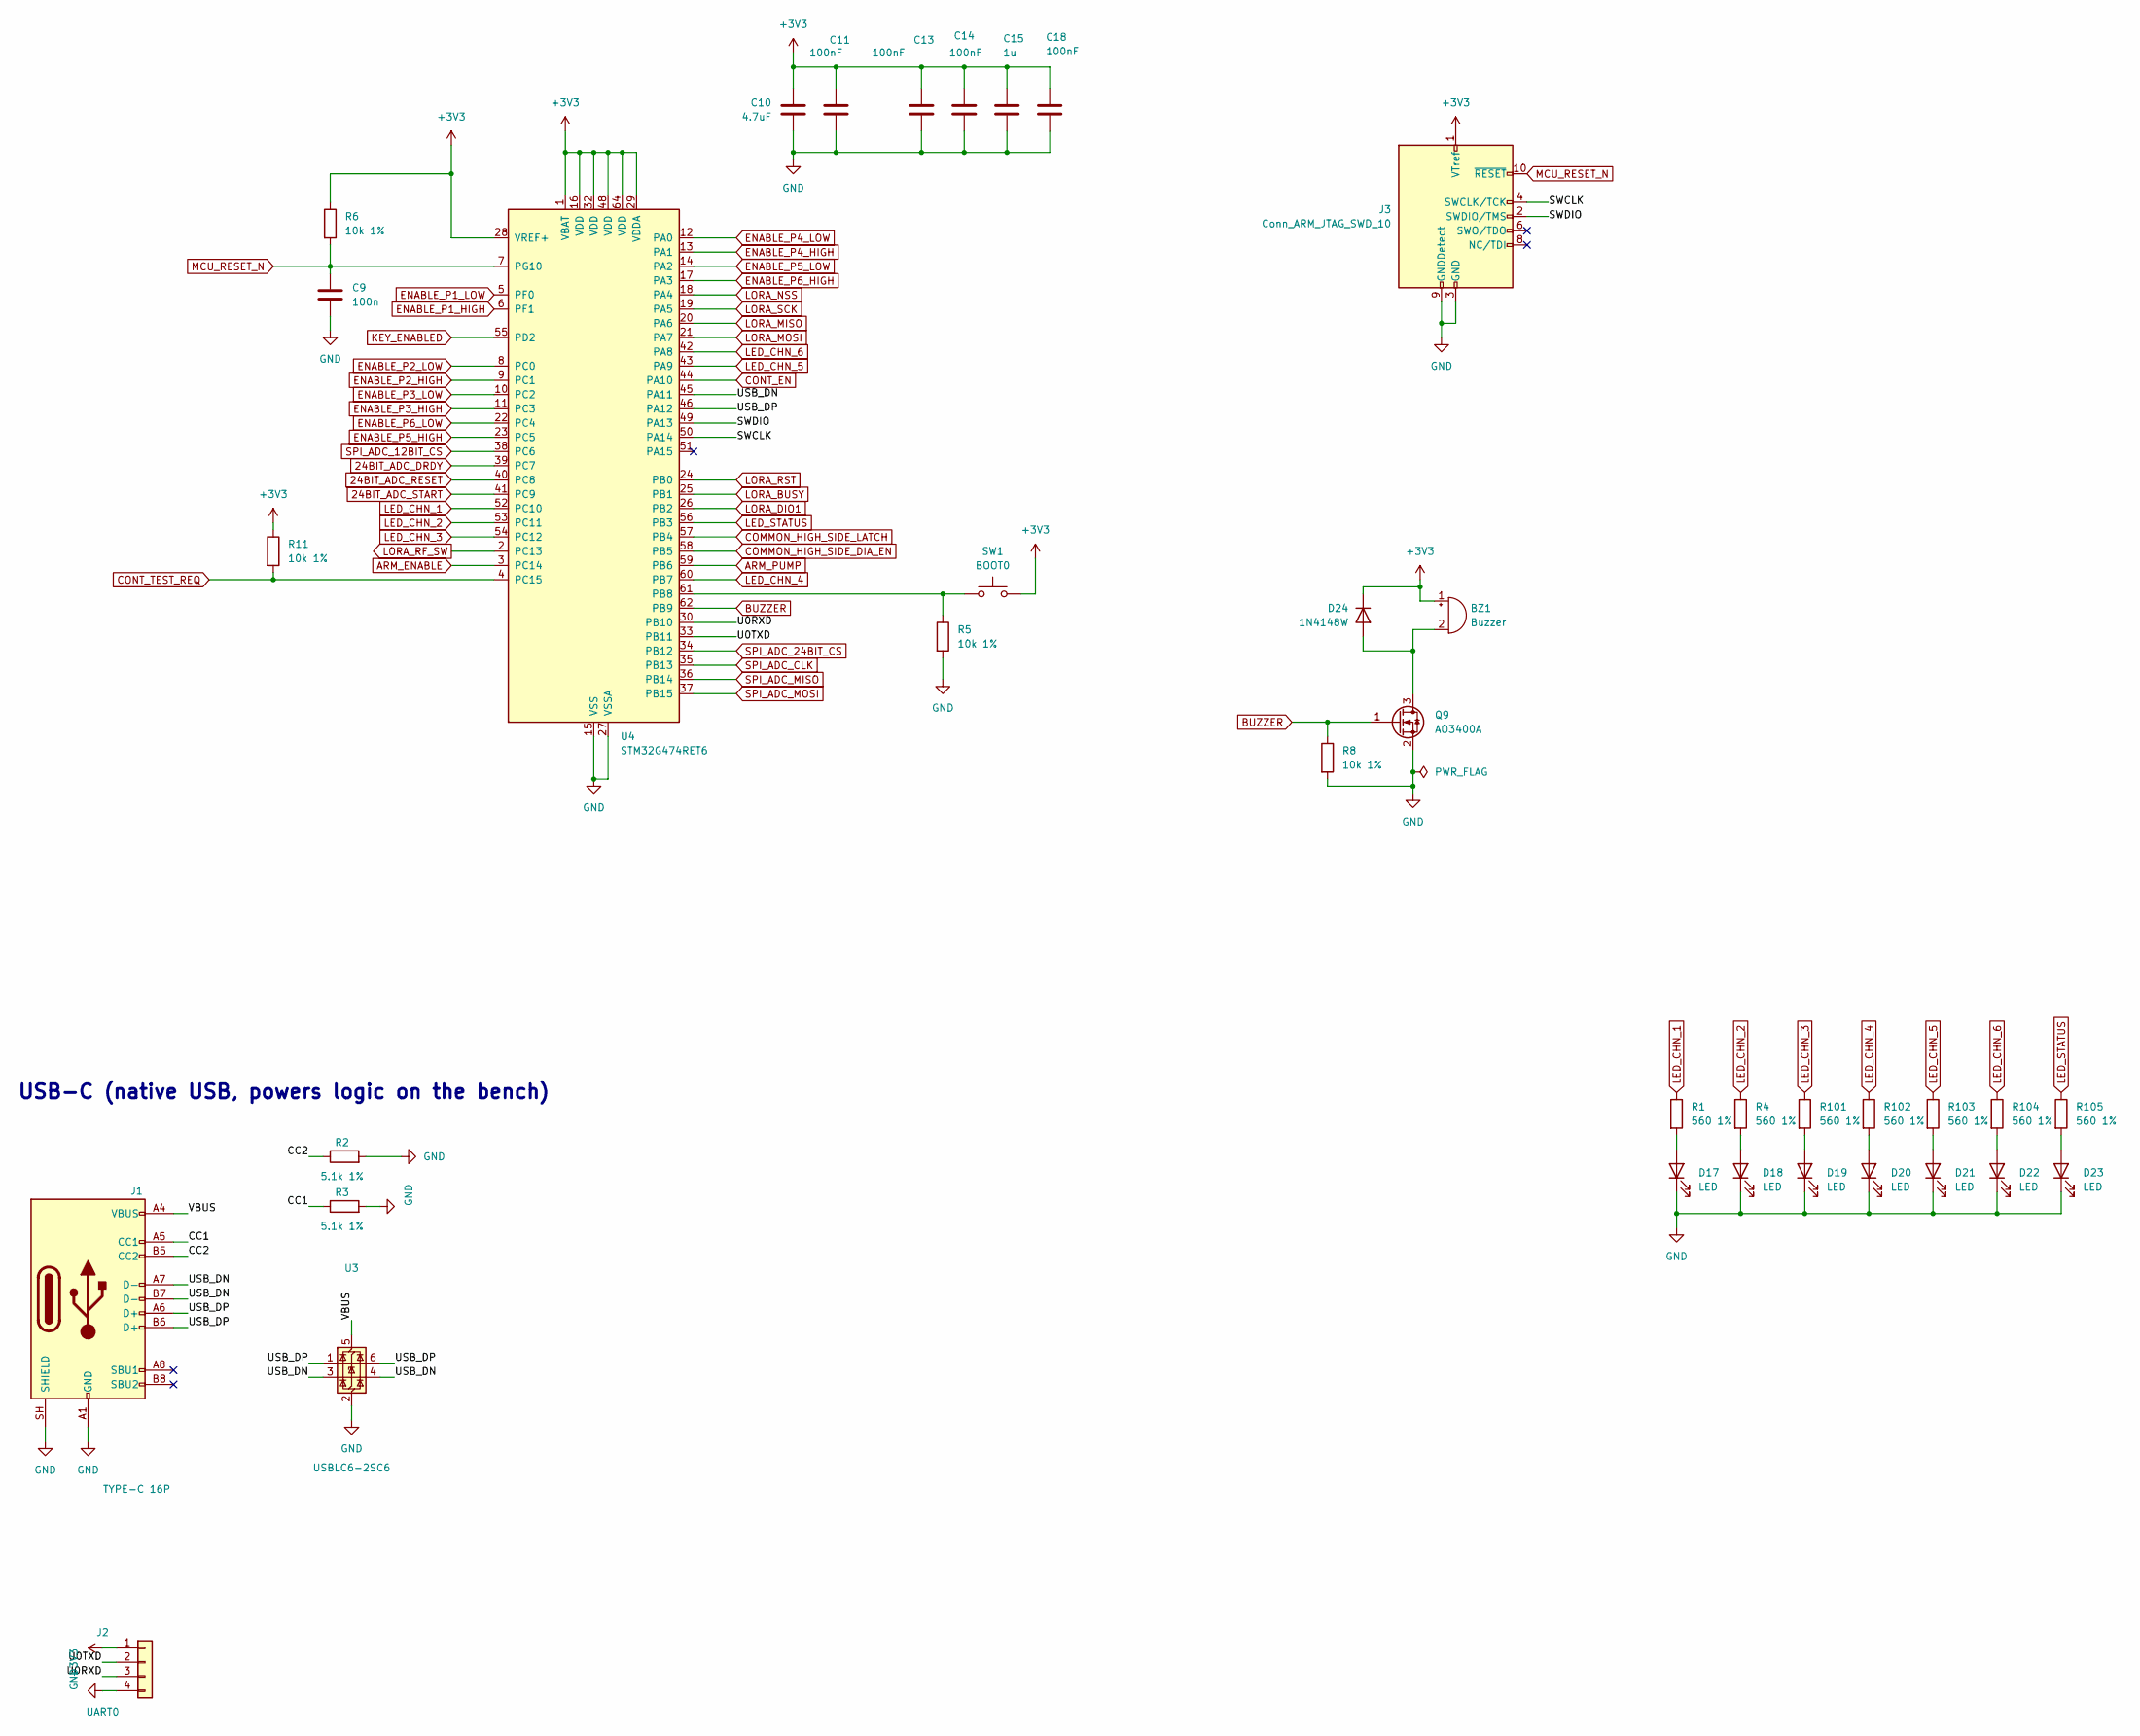
[picture p100: schematic 02_mcu.kicad_sch, Launch pad satellite — MCU and supervision]

Parts:
BZ1: Buzzer; MagneticBuzzer_CUI_CMT-8504-100-SMT; LCSC C94599
C9: 100n; C_0603_1608Metric; LCSC C14663
C10: 4.7uF; C_0805_2012Metric; LCSC C98195
C11, C13, C14, C18: 100nF; C_0402_1005Metric; LCSC C307331
C15: 1u; C_0603_1608Metric; LCSC C5199872
D17, D18, D19, D20, D21, D22, D23: LED; LED_D5.0mm
D24: 1N4148W; D_SOD-123; LCSC C81598
J1: TYPE-C 16P; USB_C_Receptacle_HRO_TYPE-C-31-M-12; LCSC C2765186
J2: UART0; PinHeader_1x04_P2.54mm_Vertical
J3: Conn_ARM_JTAG_SWD_10; PinHeader_2x05_P2.54mm_Vertical_SMD
Q9: AO3400A; SOT-23; LCSC C20917
R1, R4, R101, R102, R103, R104, R105: 560 1%; R_0603_1608Metric; LCSC C23204
R2, R3: 5.1k 1%; R_0603_1608Metric; LCSC C23186
R5, R6, R8, R11: 10k 1%; R_0603_1608Metric; LCSC C25804
SW1: BOOT0; SW_SPST_TL3342; LCSC C318884
U3: USBLC6-2SC6; SOT-23-6; LCSC C2687116
U4: STM32G474RET6; LQFP-64_10x10mm_P0.5mm; MPN STM32G474RET6; LCSC C521608

Connections:
24BIT_ADC_DRDY: U4.39 (PC7); also elsewhere on the board
24BIT_ADC_RESET: U4.40 (PC8); also elsewhere on the board
24BIT_ADC_START: U4.41 (PC9); also elsewhere on the board
+3V3: BZ1.1 (+), C10.1, C11.1, C13.1, C14.1, C15.1, C18.1, D24.1 (K), J2.1, J3.1 (VTref), R6.1, R11.1, SW1.2, U4.1 (VBAT), U4.16 (VDD), U4.28 (VREF+), U4.29 (VDDA), U4.32 (VDD), U4.48 (VDD), U4.64 (VDD); also elsewhere on the board
/mcu/CC1: J1.A5 (CC1), R3.1
/mcu/CC2: J1.B5 (CC2), R2.1
/mcu/SWCLK: J3.4 (SWCLK/TCK), U4.50 (PA14)
/mcu/SWDIO: J3.2 (SWDIO/TMS), U4.49 (PA13)
/mcu/U0RXD: J2.3, U4.30 (PB10)
/mcu/U0TXD: J2.2, U4.33 (PB11)
/mcu/USB_DN: J1.A7 (D-), J1.B7 (D-), U3.3 (I/O2), U3.4 (I/O2), U4.45 (PA11)
/mcu/USB_DP: J1.A6 (D+), J1.B6 (D+), U3.1 (I/O1), U3.6 (I/O1), U4.46 (PA12)
/mcu/VBUS: J1.A4 (VBUS), J1.A9 (VBUS), J1.B4 (VBUS), J1.B9 (VBUS), U3.5 (VBUS)
ARM_ENABLE: U4.3 (PC14); also elsewhere on the board
ARM_PUMP: U4.59 (PB6); also elsewhere on the board
BUZZER: Q9.1 (G), R8.1, U4.62 (PB9)
COMMON_HIGH_SIDE_DIA_EN: U4.58 (PB5); also elsewhere on the board
COMMON_HIGH_SIDE_LATCH: U4.57 (PB4); also elsewhere on the board
CONT_EN: U4.44 (PA10); also elsewhere on the board
CONT_TEST_REQ: R11.2, U4.4 (PC15); also elsewhere on the board
ENABLE_P1_HIGH: U4.6 (PF1); also elsewhere on the board
ENABLE_P1_LOW: U4.5 (PF0); also elsewhere on the board
ENABLE_P2_HIGH: U4.9 (PC1); also elsewhere on the board
ENABLE_P2_LOW: U4.8 (PC0); also elsewhere on the board
ENABLE_P3_HIGH: U4.11 (PC3); also elsewhere on the board
ENABLE_P3_LOW: U4.10 (PC2); also elsewhere on the board
ENABLE_P4_HIGH: U4.13 (PA1); also elsewhere on the board
ENABLE_P4_LOW: U4.12 (PA0); also elsewhere on the board
ENABLE_P5_HIGH: U4.23 (PC5); also elsewhere on the board
ENABLE_P5_LOW: U4.14 (PA2); also elsewhere on the board
ENABLE_P6_HIGH: U4.17 (PA3); also elsewhere on the board
ENABLE_P6_LOW: U4.22 (PC4); also elsewhere on the board
GND: C9.2, C10.2, C11.2, C13.2, C14.2, C15.2, C18.2, D17.1 (K), D18.1 (K), D19.1 (K), D20.1 (K), D21.1 (K), D22.1 (K), D23.1 (K), J1.A1 (GND), J1.A12 (GND), J1.B1 (GND), J1.B12 (GND), J1.SH (SHIELD), J2.4, J3.3 (GND), J3.5 (GND), J3.9 (GNDDetect), Q9.2 (S), R2.2, R3.2, R5.2, R8.2, U3.2 (GND), U4.15 (VSS), U4.27 (VSSA), U4.31 (VSS), U4.47 (VSS), U4.63 (VSS); also elsewhere on the board
KEY_ENABLED: U4.55 (PD2); also elsewhere on the board
LED_CHN_1: R1.1, U4.52 (PC10)
LED_CHN_2: R4.1, U4.53 (PC11)
LED_CHN_3: R101.1, U4.54 (PC12)
LED_CHN_4: R102.1, U4.60 (PB7)
LED_CHN_5: R103.1, U4.43 (PA9)
LED_CHN_6: R104.1, U4.42 (PA8)
LED_STATUS: R105.1, U4.56 (PB3)
LORA_BUSY: U4.25 (PB1); also elsewhere on the board
LORA_DIO1: U4.26 (PB2); also elsewhere on the board
LORA_MISO: U4.20 (PA6); also elsewhere on the board
LORA_MOSI: U4.21 (PA7); also elsewhere on the board
LORA_NSS: U4.18 (PA4); also elsewhere on the board
LORA_RF_SW: U4.2 (PC13); also elsewhere on the board
LORA_RST: U4.24 (PB0); also elsewhere on the board
LORA_SCK: U4.19 (PA5); also elsewhere on the board
MCU_RESET_N: C9.1, J3.10 (~RESET), R6.2, U4.7 (PG10)
unnamed: BZ1.2 (-), D24.2 (A), Q9.3 (D)
unnamed: D17.2 (A), R1.2
unnamed: D18.2 (A), R4.2
unnamed: D19.2 (A), R101.2
unnamed: D20.2 (A), R102.2
unnamed: D21.2 (A), R103.2
unnamed: D22.2 (A), R104.2
unnamed: D23.2 (A), R105.2
unnamed: R5.1, SW1.1, U4.61 (PB8)
SPI_ADC_12BIT_CS: U4.38 (PC6); also elsewhere on the board
SPI_ADC_24BIT_CS: U4.34 (PB12); also elsewhere on the board
SPI_ADC_CLK: U4.35 (PB13); also elsewhere on the board
SPI_ADC_MISO: U4.36 (PB14); also elsewhere on the board
SPI_ADC_MOSI: U4.37 (PB15); also elsewhere on the board

Notes on the sheet:
USB-C (native USB, powers logic on the bench)

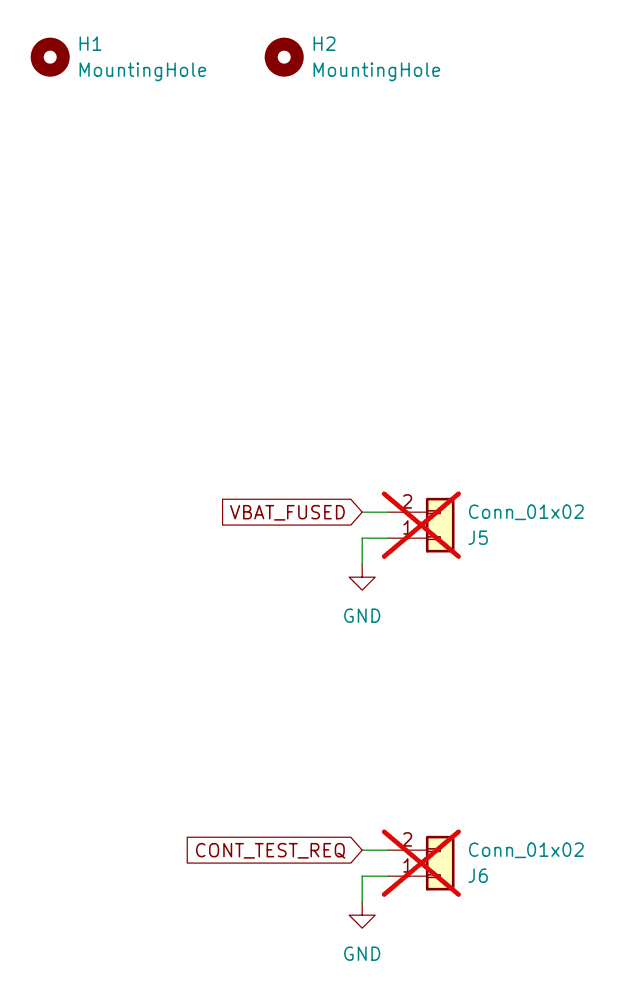
[picture p101: schematic connectors.kicad_sch]

Parts:
H1, H2: MountingHole; MountingHole_3.2mm_M3_ISO7380
J5: Conn_01x02; AMASS_XT60-M_1x02_P7.20mm_Vertical; LCSC C5334533; not fitted
J6: Conn_01x02; Molex_KK-254_AE-6410-02A_1x02_P2.54mm_Vertical; LCSC C5334533; not fitted

Connections:
CONT_TEST_REQ: J6.2; also elsewhere on the board
GND: J5.1, J6.1; also elsewhere on the board
VBAT_FUSED: J5.2; also elsewhere on the board

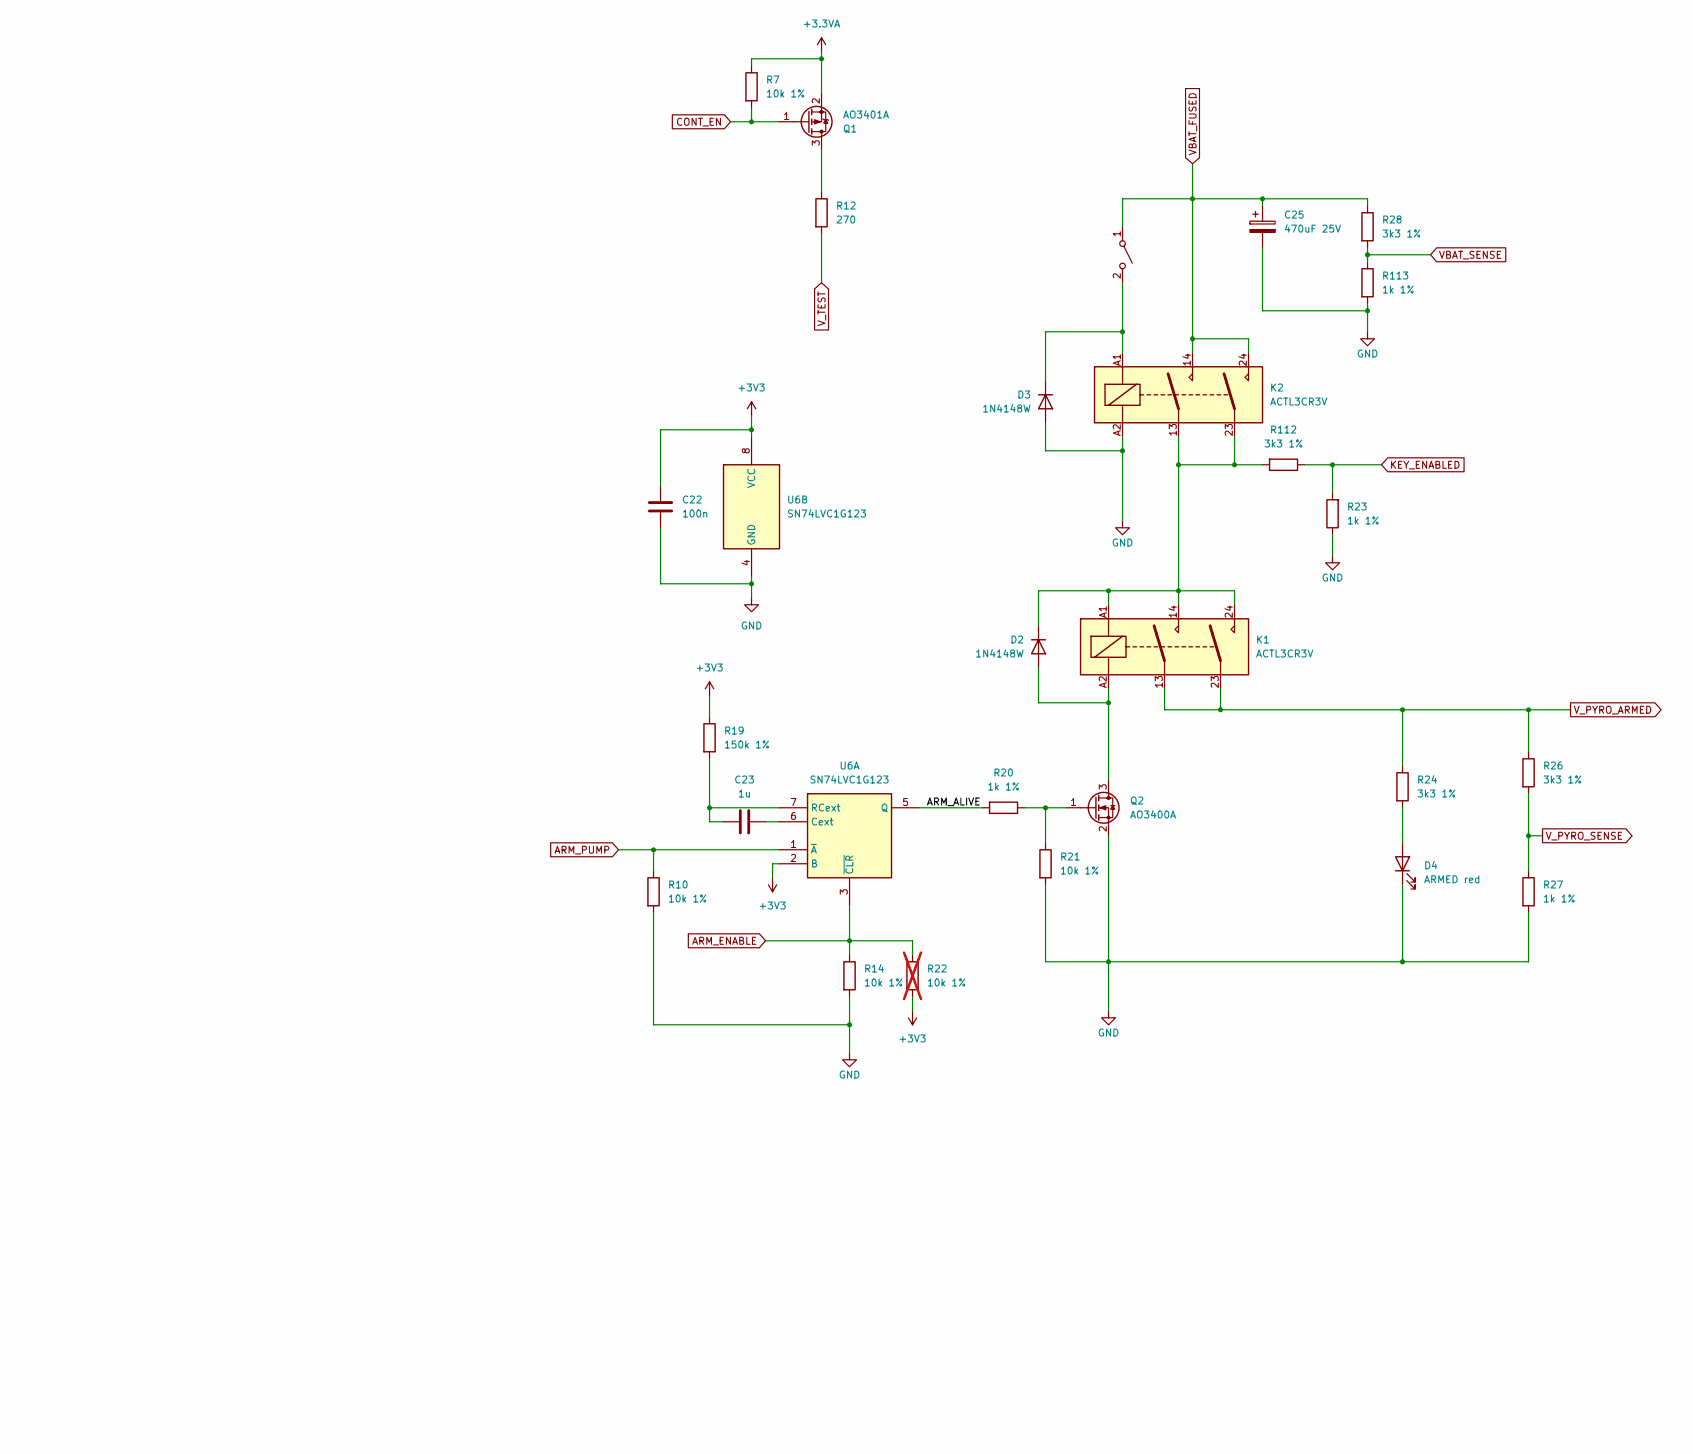
[picture p102: schematic 04_arm.kicad_sch, Launch pad satellite — Arm chain, rail monitor, output gati…, part in row 1, column 1]

Parts:
C22: 100n; C_0603_1608Metric; LCSC C14663
C23: 1u; C_0603_1608Metric; LCSC C5199872
C25: 470uF 25V; CP_Radial_D10.0mm_P7.50mm
D2, D3: 1N4148W; D_SOD-123; LCSC C81598
D4: ARMED red; LED_D5.0mm
K1, K2: ACTL3CR3V; RELAY-TH_ACTL3CR3; LCSC C6118826
Q1: AO3401A; SOT-23; LCSC C15127
Q2: AO3400A; SOT-23; LCSC C20917
R7, R10, R14, R21: 10k 1%; R_0603_1608Metric; LCSC C25804
R12: 270; R_0603_1608Metric; LCSC C22966
R19: 150k 1%; R_0603_1608Metric; LCSC C22807
R20, R23, R27, R113: 1k 1%; R_0603_1608Metric; LCSC C21190
R22: 10k 1%; R_0603_1608Metric; not fitted
R24, R26, R28, R112: 3k3 1%; R_0603_1608Metric; LCSC C22978
SW2: SW_SPST; Molex_KK-254_AE-6410-02A_1x02_P2.54mm_Vertical
U6: SN74LVC1G123; SSOP-8_2.95x2.8mm_P0.65mm; LCSC C123302

Connections:
+3.3VA: Q1.2 (S), R7.1; also elsewhere on the board
+3V3: C22.1, R19.1, R22.2, U6.2 (B), U6.8 (VCC); also elsewhere on the board
/arm/ARM_ALIVE: R20.2, U6.5 (Q)
ARM_ENABLE: R14.1, R22.1, U6.3 (~CLR); also elsewhere on the board
ARM_PUMP: R10.1, U6.1 (~A); also elsewhere on the board
CONT_EN: Q1.1 (G), R7.2; also elsewhere on the board
GND: C22.2, C25.2, D3.2 (A), D4.1 (K), K2.A2, Q2.2 (S), R10.2, R14.2, R21.2, R23.1, R27.2, R113.2, U6.4 (GND); also elsewhere on the board
KEY_ENABLED: R23.2, R112.1; also elsewhere on the board
unnamed: D2.2 (A), K1.A2, Q2.3 (D)
unnamed: D2.1 (K), K1.14, K1.24, K1.A1, K2.13, K2.23, R112.2
unnamed: D3.1 (K), K2.A1, SW2.2 (B)
unnamed: D4.2 (A), R24.2
unnamed: Q1.3 (D), R12.1
unnamed: Q2.1 (G), R20.1, R21.1
unnamed: C23.1, U6.6 (Cext)
unnamed: C23.2, R19.2, U6.7 (RCext)
VBAT_FUSED: C25.1, K2.14, K2.24, R28.1, SW2.1 (A); also elsewhere on the board
VBAT_SENSE: R28.2, R113.1; also elsewhere on the board
V_PYRO_ARMED: K1.13, K1.23, R24.1, R26.1; also elsewhere on the board
V_PYRO_SENSE: R26.2, R27.1; also elsewhere on the board
V_TEST: R12.2; also elsewhere on the board

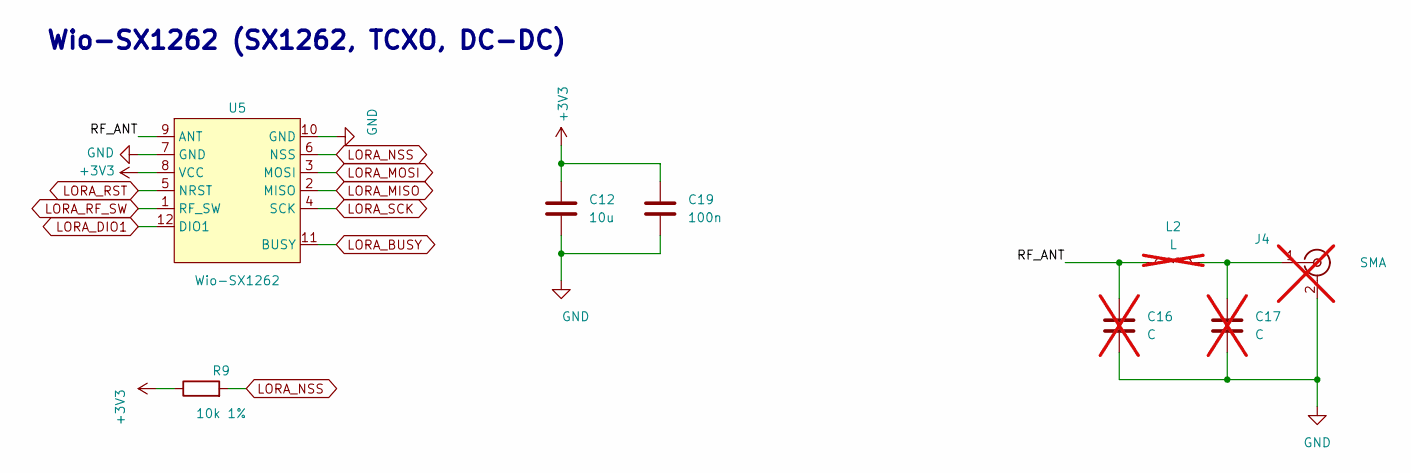
[picture p103: schematic 03_radio.kicad_sch, Launch pad satellite — LoRa radio]

Parts:
C12: 10u; C_0805_2012Metric; LCSC C440198
C16, C17: C; C_0603_1608Metric_Pad1.08x0.95mm_HandSolder; not fitted
C19: 100n; C_0603_1608Metric; LCSC C14663
J4: SMA; SMA_Amphenol_132291_Vertical; LCSC C496549; not fitted
L2: L; L_0603_1608Metric_Pad1.05x0.95mm_HandSolder; not fitted
R9: 10k 1%; R_0603_1608Metric; LCSC C25804
U5: Wio-SX1262; WIRELM-SMD_WIO-SX1262

Connections:
+3V3: C12.1, C19.1, R9.1, U5.8 (VCC); also elsewhere on the board
/radio/RF_ANT: C16.1, L2.1, U5.9 (ANT)
GND: C12.2, C16.2, C17.2, C19.2, J4.2 (Ext), U5.7 (GND), U5.10 (GND); also elsewhere on the board
LORA_BUSY: U5.11 (BUSY); also elsewhere on the board
LORA_DIO1: U5.12 (DIO1); also elsewhere on the board
LORA_MISO: U5.2 (MISO); also elsewhere on the board
LORA_MOSI: U5.3 (MOSI); also elsewhere on the board
LORA_NSS: R9.2, U5.6 (NSS); also elsewhere on the board
LORA_RF_SW: U5.1 (RF_SW); also elsewhere on the board
LORA_RST: U5.5 (NRST); also elsewhere on the board
LORA_SCK: U5.4 (SCK); also elsewhere on the board
unnamed: C17.1, J4.1 (In), L2.2

Notes on the sheet:
Wio-SX1262 (SX1262, TCXO, DC-DC)

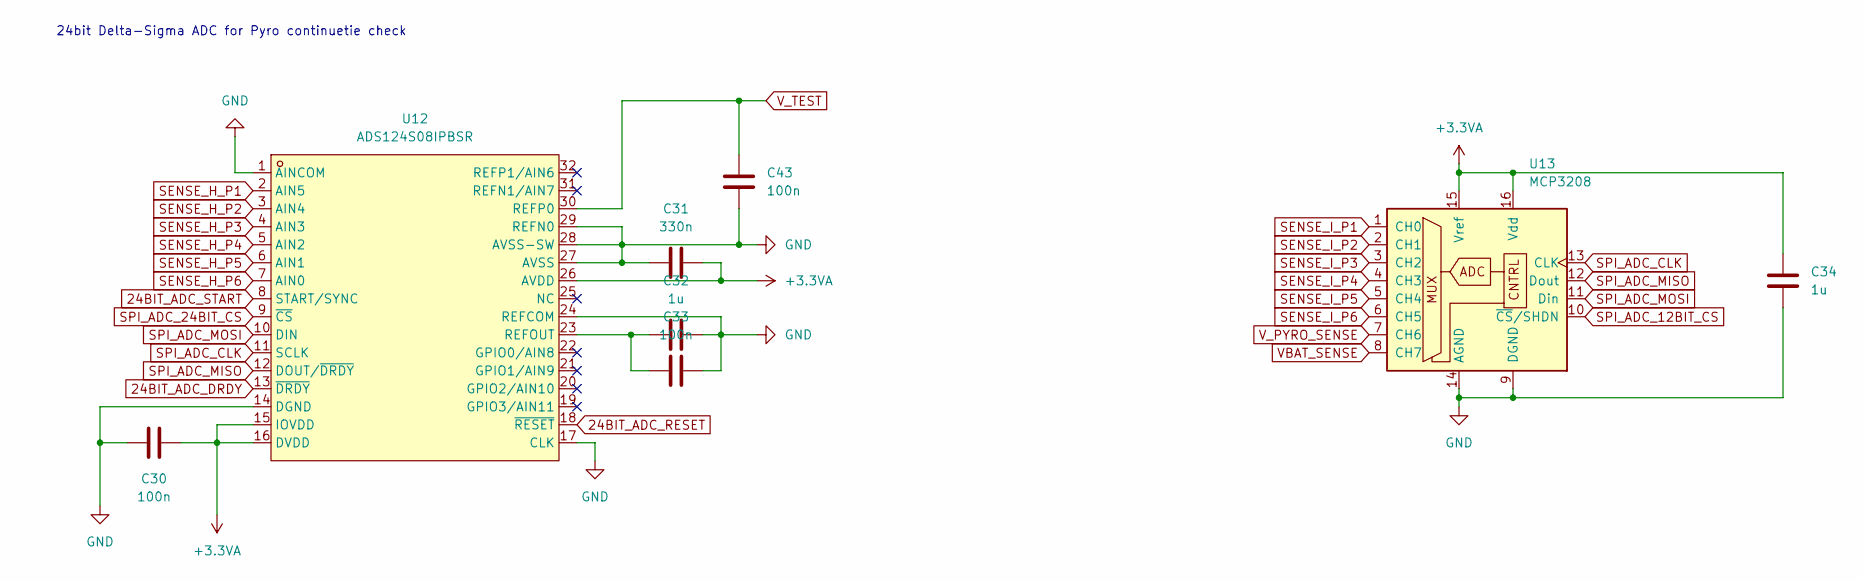
[picture p104: schematic 06_sense_ui.kicad_sch, Launch pad satellite — ADCs, test reference, displays, UI]

Parts:
C30, C33, C43: 100n; C_0603_1608Metric; LCSC C14663
C31: 330n; C_0603_1608Metric; LCSC C107070
C32, C34: 1u; C_0603_1608Metric; LCSC C5199872
U12: ADS124S08IPBSR; TQFP-32_L5.0-W5.0-P0.50-LS7.0-TL; MPN ADS124S08IPBSR; LCSC Part C2870171
U13: MCP3208; SOIC-16_3.9x9.9mm_P1.27mm; LCSC C626764

Connections:
24BIT_ADC_DRDY: U12.13 (~DRDY); also elsewhere on the board
24BIT_ADC_RESET: U12.18 (~RESET); also elsewhere on the board
24BIT_ADC_START: U12.8 (START/SYNC); also elsewhere on the board
+3.3VA: C30.1, C31.1, C34.1, U12.15 (IOVDD), U12.16 (DVDD), U12.26 (AVDD), U13.15 (Vref), U13.16 (Vdd); also elsewhere on the board
GND: C30.2, C31.2, C32.1, C33.1, C34.2, C43.2, U12.1 (AINCOM), U12.14 (DGND), U12.17 (CLK), U12.24 (REFCOM), U12.27 (AVSS), U12.28 (AVSS-SW), U12.29 (REFN0), U13.9 (DGND), U13.14 (AGND); also elsewhere on the board
unnamed: C32.2, C33.2, U12.23 (REFOUT)
SENSE_H_P1: U12.2 (AIN5); also elsewhere on the board
SENSE_H_P2: U12.3 (AIN4); also elsewhere on the board
SENSE_H_P3: U12.4 (AIN3); also elsewhere on the board
SENSE_H_P4: U12.5 (AIN2); also elsewhere on the board
SENSE_H_P5: U12.6 (AIN1); also elsewhere on the board
SENSE_H_P6: U12.7 (AIN0); also elsewhere on the board
SENSE_I_P1: U13.1 (CH0); also elsewhere on the board
SENSE_I_P2: U13.2 (CH1); also elsewhere on the board
SENSE_I_P3: U13.3 (CH2); also elsewhere on the board
SENSE_I_P4: U13.4 (CH3); also elsewhere on the board
SENSE_I_P5: U13.5 (CH4); also elsewhere on the board
SENSE_I_P6: U13.6 (CH5); also elsewhere on the board
SPI_ADC_12BIT_CS: U13.10 (~CS/SHDN); also elsewhere on the board
SPI_ADC_24BIT_CS: U12.9 (~CS); also elsewhere on the board
SPI_ADC_CLK: U12.11 (SCLK), U13.13 (CLK); also elsewhere on the board
SPI_ADC_MISO: U12.12 (DOUT/~DRDY), U13.12 (Dout); also elsewhere on the board
SPI_ADC_MOSI: U12.10 (DIN), U13.11 (Din); also elsewhere on the board
VBAT_SENSE: U13.8 (CH7); also elsewhere on the board
V_PYRO_SENSE: U13.7 (CH6); also elsewhere on the board
V_TEST: C43.1, U12.30 (REFP0); also elsewhere on the board

Notes on the sheet:
24bit Delta-Sigma ADC for Pyro continuetie check
