rckTom/alturia-launch-control/hardware/satellite/pcb/satellite.kicad_pcb

## KiCad design hardware/satellite/pcb/satellite.kicad_pcb (continued)

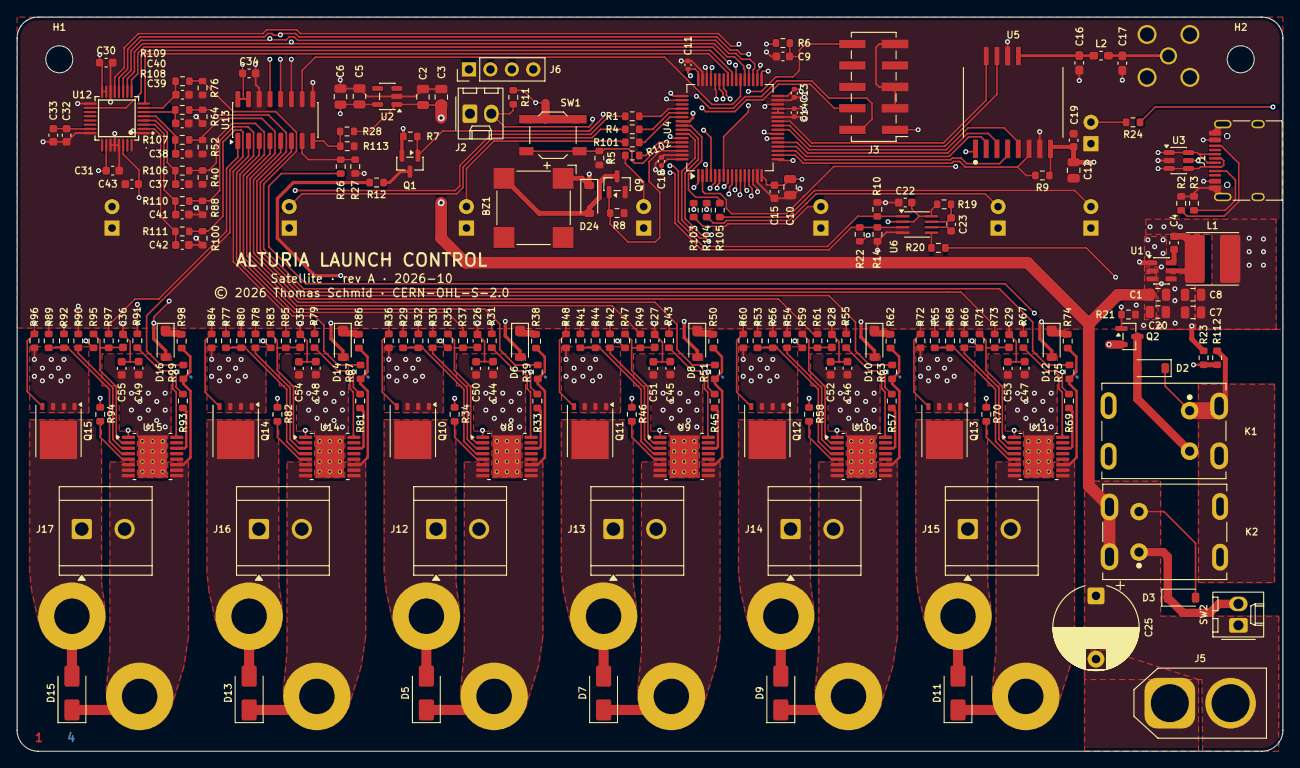
[picture p105: board satellite.kicad_pcb from above]

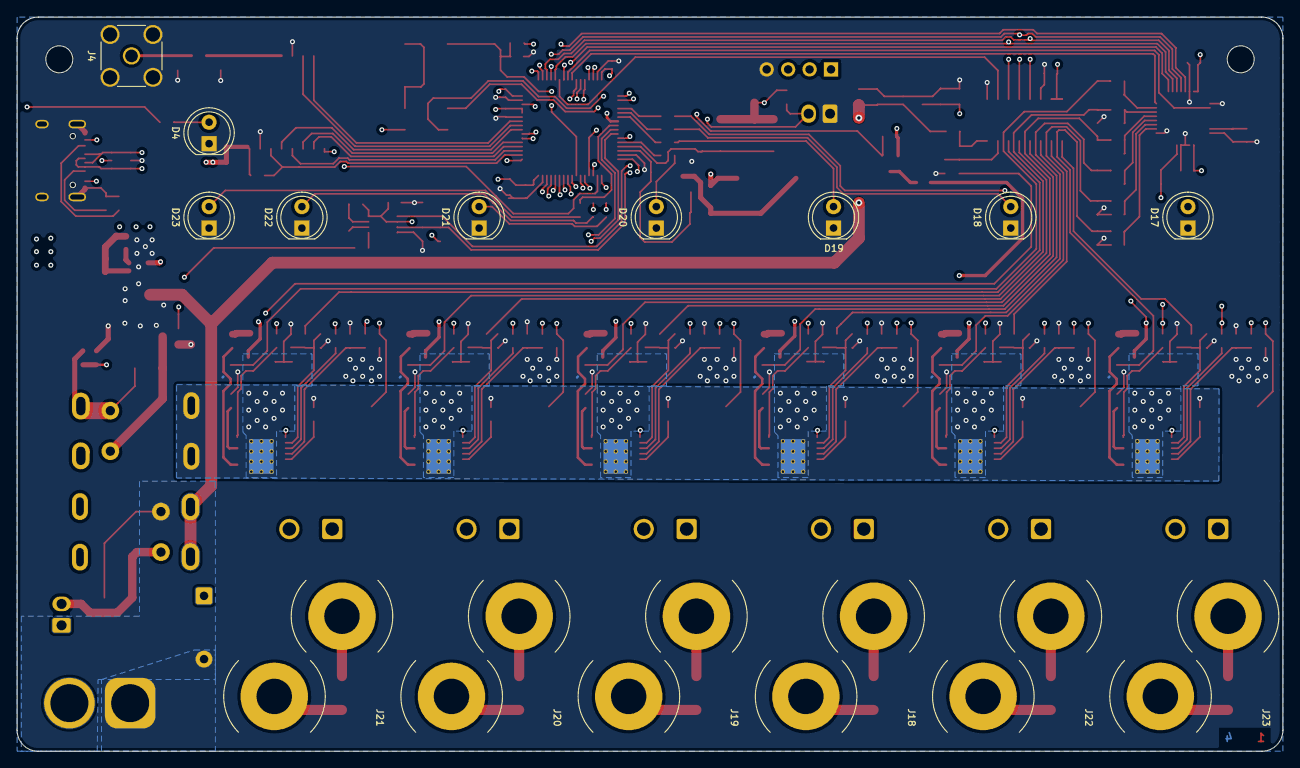
[picture p106: board satellite.kicad_pcb from below]

Board: 4 copper layers, 150.0 x 87.0 mm, 233 parts (15 on the bottom side), 156 nets.
