rckTom/alturia-launch-control/hardware/controller/sim/latch_sim/latch_sim.kicad_sch

## KiCad design hardware/controller/sim/latch_sim/latch_sim.kicad_sch (2026-10-11)

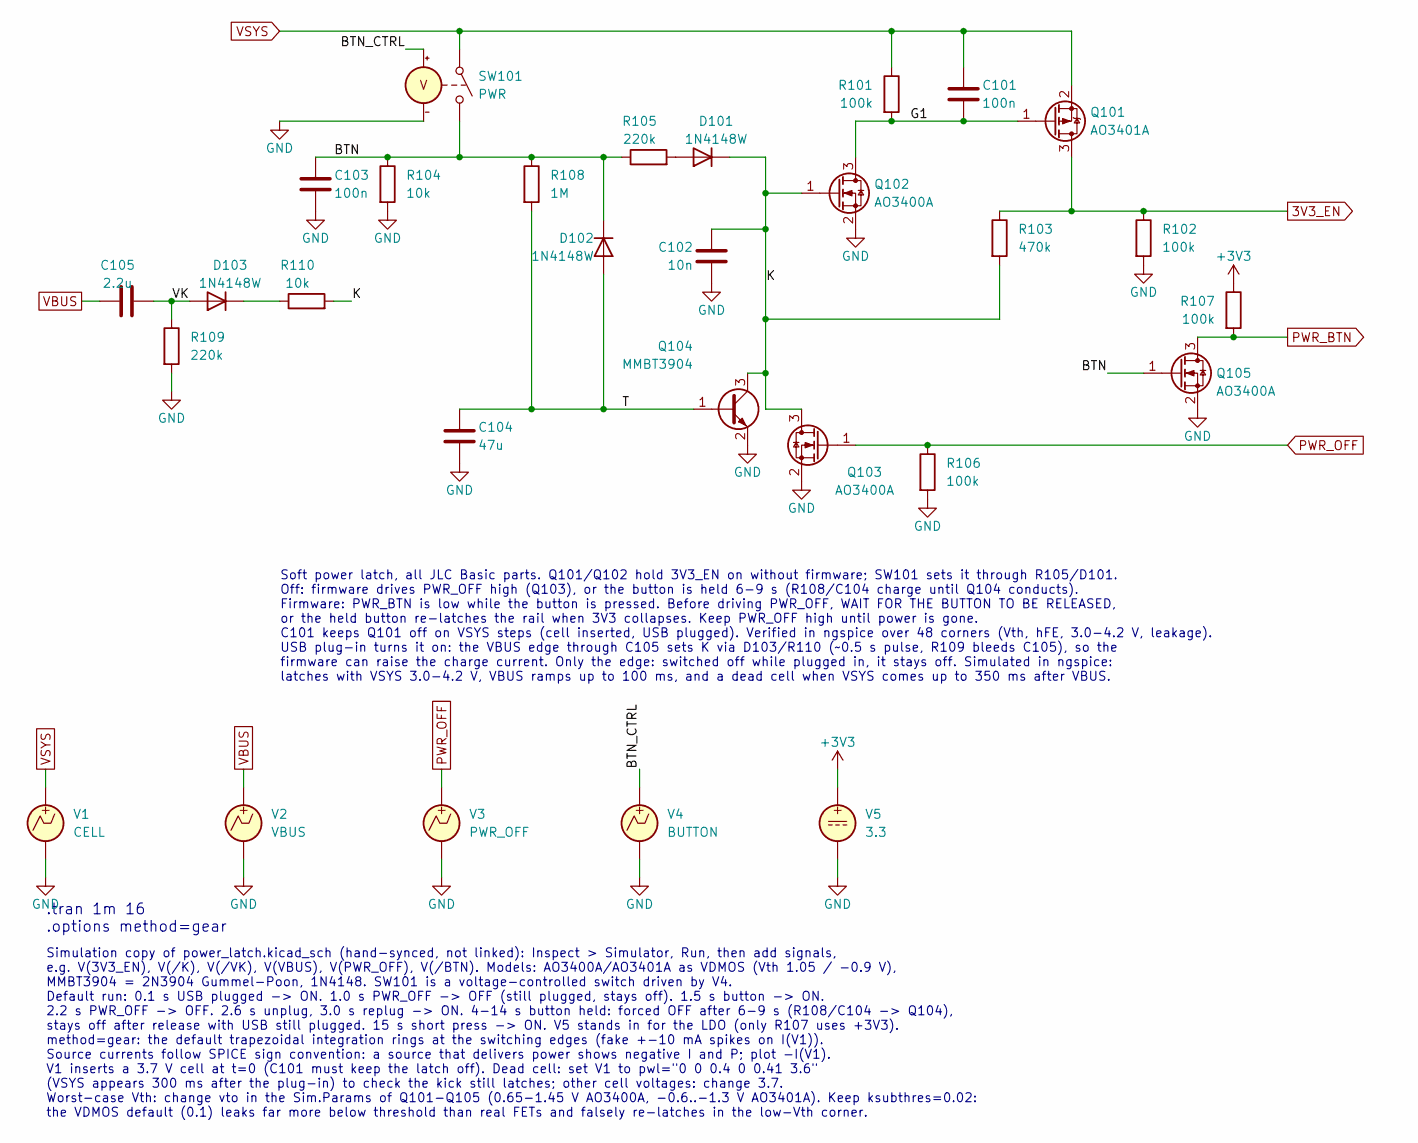
[picture p107: schematic latch_sim.kicad_sch]

Parts:
C101, C103: 100n; C_0603_1608Metric; LCSC C14663
C102: 10n; C_0603_1608Metric; LCSC C57112
C104: 47u; C_0603_1608Metric; LCSC C140782
C105: 2.2u; C_0603_1608Metric; LCSC C23630
D101, D102, D103: 1N4148W; D_SOD-123; LCSC C81598
Q101: AO3401A; SOT-23; LCSC C15127
Q102, Q103, Q105: AO3400A; SOT-23; LCSC C20917
Q104: MMBT3904; SOT-23; LCSC C20526
R101, R102, R106, R107: 100k; R_0603_1608Metric; LCSC C25803
R103: 470k; R_0603_1608Metric; LCSC C23178
R104, R110: 10k; R_0603_1608Metric; LCSC C25804
R105, R109: 220k; R_0603_1608Metric; LCSC C22961
R108: 1M; R_0603_1608Metric; LCSC C22935
SW101: PWR
V1: CELL
V2: VBUS
V3: PWR_OFF
V4: BUTTON
V5: 3.3

Connections:
3V3_EN: Q101.3 (D), R102.1, R103.1
+3V3: R107.1, V5.1
BTN: C103.1, D102.1 (K), Q105.1 (G), R104.1, R105.1, R108.1, SW101.2 (N-)
BTN_CTRL: SW101.3 (C+), V4.1
G1: C101.2, Q101.1 (G), Q102.3 (D), R101.2
GND: C102.2, C103.2, C104.2, Q102.2 (S), Q103.2 (S), Q104.2 (E), Q105.2 (S), R102.2, R104.2, R106.2, R109.2, SW101.4 (C-), V1.2, V2.2, V3.2, V4.2, V5.2
K: C102.1, D101.1 (K), Q102.1 (G), Q103.3 (D), Q104.3 (C), R103.2, R110.2
unnamed: D101.2 (A), R105.2
unnamed: D103.1 (K), R110.1
PWR_BTN: Q105.3 (D), R107.2
PWR_OFF: Q103.1 (G), R106.1, V3.1
T: C104.1, D102.2 (A), Q104.1 (B), R108.2
VBUS: C105.1, V2.1
VK: C105.2, D103.2 (A), R109.1
VSYS: C101.1, Q101.2 (S), R101.1, SW101.1 (N+), V1.1

Notes on the sheet:
Simulation copy of power_latch.kicad_sch (hand-synced, not linked): Inspect > Simulator, Run, then add signals, e.g. V(3V3_EN), V(/K), V(/VK), V(VBUS), V(PWR_OFF), V(/BTN). Models: AO3400A/AO3401A as VDMOS (Vth 1.05 / -0.9 V), MMBT3904 = 2N3904 Gummel-Poon, 1N4148. SW101 is a voltage-controlled swi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
.tran 1m 16 .options method=gear
Soft power latch, all JLC Basic parts. Q101/Q102 hold 3V3_EN on without firmware; SW101 sets it through R105/D101. Off: firmware drives PWR_OFF high (Q103), or the button is held 6-9 s (R108/C104 charge until Q104 conducts). Firmware: PWR_BTN is low while the button is pressed. Before driving PWR_O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
