rckTom/alturia-launch-control/(commit log)

2026-09-22 pyro channels and arming done
    [01_power.kicad_sch, 02_mcu.kicad_sch, 03_radio.kicad_sch, 04_arm.kicad_sch, 05_channel.kicad_sch, 06_sense_ui.kicad_sch, bom_jlcpcb.csv, output_channel.kicad_sch]
2026-09-24 lora link
    [satellite.kicad_pcb]
2026-09-26 finish layout
    [01_power.kicad_sch, 02_mcu.kicad_sch, 03_radio.kicad_sch, 04_arm.kicad_sch, 06_sense_ui.kicad_sch, connectors.kicad_sch, output_channel.kicad_sch, satellite.kicad_pcb]
2026-10-06 rev A satellite
    [01_power.kicad_sch, 02_mcu.kicad_sch, 03_radio.kicad_sch, 04_arm.kicad_sch, 06_sense_ui.kicad_sch, 1932.3112.stp, Body001 (Meshed).stl, BoxGuideline.FCStd]
2026-10-06 order satellite jlcpcb
    [01_power.kicad_sch, 03_radio.kicad_sch, 04_arm.kicad_sch, 06_sense_ui.kicad_sch, bom_jlcpcb.csv, output_channel.kicad_sch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]
2026-10-11 controller rev A
    [Adafruit_4694_Sharp27.FCStd, Adafruit_4694_Sharp27.step, BUZ-TH_D9.0-H5.5-P4.0.step, BackCase.FCStd, CaseFront.stl, Controller.FCStd, ControllerAssembly.FCStd, DisplayGlasGlue.FCStd]
2026-11-02 controller: split UI into views, light sleep; satellite case updates
    - controller_ui: ui.c split into one file per view under src/ui/
    - controller_ui: CONFIG_PM light sleep (sleep.c), battery, shell and
    sat_sim updates; link/radio and chime changes in common/
    - satellite case: CAD updates and new battery clamp
    [Battery.FCStd, BatteryClamp.FCStd, Case.stl, Delock_22032.FCStd, Latch.FCStd, LidAssembly.FCStd, ParametricCase.FCStd, ParametricCaseBaseLid.FCStd]
2026-11-02 controller: model for 8 satellites and 48 pads
    NUM_SATS follows the link's limit (8), NUM_PADS is one per channel of
    every satellite, and pad masks are 64 bits. pads_format() counts what
    does not fit ("ALFA, Pad 2 +5"). Simulated satellites C-H get default
    loads and batteries. The views still lay out for 2/7 and are reworked
    in the following commits.
    [controller.c, controller.h, link.h, pads.c, pads.h, sat_sim.c]
2026-11-02 controller UI: grouped main list, quick arm, new menu
    Main list:
    - pads of every paired satellite, grouped under a header row per
    satellite (battery, link, E-STOP, pad key), in channel order
    - the cursor is the inverted row; a small square marks ticked pads
    - pads stay in place when their satellite's link goes; ticks are kept
    and arming says why it cannot
    - continuity column before arming, behind CONFIG_APP_PREARM_CONTINUITY
    (on with the simulated satellites, "?" on the board for now)
    - status strip: state, SATS n/m, channel busy, battery
    - hint line always says what ARM does; events show in a toast above it
    - virtual rows with a scroll bar, for 8 satellites and 48 pads
    Controls: ARM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
    [controller.c, controller.h, inputs.c, pads.c, shell_cmds.c]
2026-11-02 Remove the satellite E-STOP: the board has none
    The E-STOP came from the old schematic spec (J6/J401); the satellite as
    drawn only has the key switch. Gone from the status (bit 1 of the flags
    byte stays clear, so mixed firmware still agrees), the controller's arm
    checks and main list, and the simulated satellites.
2026-11-02 controller UI: messages in the hint line instead of a toast
    Only what the operator has to be told (a refused button, a launch, an
    arm timeout, a saved pad) is shown, in the hint line for a few seconds;
    the next button press takes it away again, so the hint that says what
    ARM would arm is never hidden when it matters. What the screen shows
    anyway (links, arming, armed, valve states, channel load) is only
    logged (note()). The armed view's hint shows messages too. Menu ->
    Messages lists everything.
2026-11-02 Remove the controller arm key switch: the controller has none
    The schematic has the D-pad, BACK, ARM, FIRE, FILL, VENT and the power
    button, no key switch; CONFIG_APP_KEY_SWITCH was only switched off for
    the board, so native_sim and radiosim still wanted K pressed first.
    Gone from the inputs, the arm checks, the button test, the shell, the
    native_sim key map (pin 1 unused) and the radiosim controller panel.
    coexist.py ticks pad 2 explicitly now that ARM alone arms the pad under
    the cursor.
2026-11-02 controller: large armed view for a few rockets, buzzer tunes
    Up to three armed rocket pads, the usual case, are shown in large rows
    (name, satellite and channel, igniter continuity); more pads or any
    hybrid keep the table with the valve state.
    Tunes, none blocking: armed (rising), disarmed (falling), a click every
    2 s while armed (CONFIG_APP_ARMED_BEEP), launch confirmed, a short buzz
    for a refused button (also ARM or FIRE while blocked), and the error
    tune for a fault. chime_play() now swaps tunes under a spinlock, as it
    is called from the controller while the work queue plays.
    [controller.c]
2026-11-02 controller UI: the inverted row is the cursor everywhere
    The pairing list was the last with a ">" marker; ui_cursor() and
    CURSOR_X go. Pads mockup and the radiosim README say "menu" now.
    [pads.c]
2026-11-05 gitignore: build dirs, CAD/KiCad backups, render intermediates
    The old '*build*' pattern did not stop build directories from being
    committed and hid hardware/satellite/cad/render/build_scene.py. Fold
    hardware/satellite/.gitignore into the root one.
2026-11-05 hardware: pcb/, cad/ and shared parts/ for both boards
    - satellite KiCad project, design.py and tests move to satellite/pcb/,
    fab outputs to satellite/pcb/production/ (where the controller's
    Fabrication Toolkit output already lives); controller_pcb/ -> pcb/
    - satellite cad/Case/ flattened into cad/
    - vendor models and datasheets in hardware/parts/, one copy each:
    Delock 22032 (kept the newer satellite save), USB-C, SKRTLA, Adafruit
    display, relay, banana jack, key switch, fuse holder, SMA pigtail
    - FreeCAD XLinks rewritten; KiCad 3D models point at
    ${KIPRJMOD}/../../parts instead of absolute paths
    - front_palte -> front_plate, BannanaJackHolder -> BananaJackHolder
    - dpad_membrane.p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
    [01_power.kicad_sch, 02_mcu.kicad_sch, 03_radio.kicad_sch, 04_arm.kicad_sch, 05_channel.kicad_sch, 06_sense_ui.kicad_sch, 1932.3112.stp, Adafruit_4694_Sharp27.FCStd]
2026-11-05 cad: fasteners and heat-set inserts in both assemblies
    ControllerAssembly gets the M2x12 case screws and the M2x8 retainer
    screws, with the heat-set inserts from the new shared
    hardware/parts/HeatSetInserts.FCStd. SatelliteAssembly gets the M3x40
    case screws, front_plate_assembly more mated parts. Case.stl re-exported.
    [Case.stl, ControllerAssembly.FCStd, HeatSetInserts.FCStd, ParametricCase.FCStd, SatelliteAssembly.FCStd, front_plate.FCStd, front_plate_assembly.FCStd]
2026-11-05 render: exploded views of controller and satellite
    build_scene.py gets an exploded camera that pulls the parts apart along
    z in assembly order. export_glb.py opens every linked part file on its
    own first, so partially loaded parts don't export stale shapes; the
    satellite export splits out battery, clamps and the M3x40 screws.
    Renders and the satellite engraving refreshed, README shows the
    exploded views.
2026-11-05 documentation: simplify the system overview and firing circuit diagrams
2026-11-05 license: GPL-3.0-only for firmware and software
    Adds the GPL v3 text as LICENSE and switches the SPDX headers from
    Apache-2.0. The README gets a license section (GPL for software,
    CERN-OHL-S for hardware, CC BY-SA 4.0 for documentation, name and logo
    reserved), a safety note, and the Zephyr revision the firmware is built
    against. The link to the forum post, which is not part of the repo, is
    gone.
2026-11-05 docs: point at documentation/radio_link.md, design notes are gone
    The design notes are no longer part of the repo. Code comments and READMEs
    that cited design/radio_security.md now cite documentation/radio_link.md,
    which describes the link as implemented; references to the satellite spec
    are dropped. Only the liftoff logo stays in design/logo.
    [channels.c, commands.c, controller.h, ctrl_link.h, link.h, link_sched.h, lsec.h]
2026-11-06 swap inputs for vent and arm in controller firmware
2026-11-06 firmware: build against current Zephyr and LVGL
    - satellite: ADC clock source and prescaler moved to the shared
    adc12_common node (STM32 ADC parent/child binding)
    - controller: LVGL now includes the custom blend header before the
    blend descriptor exists, so only the hooks stay in i1_blend_fix.h and
    the 1-bit blender moves to i1_blend_fix.c
    - controller: replace deprecated lv_obj flag calls with
    lv_obj_set_scrollable() / lv_obj_set_hidden()
    - controller: SDL_DISPLAY_ZOOM_PCT only on native_sim, silences the
    Kconfig warning on the board build
    [ui.c]
2026-11-06 controller: Stacker game in the diagnostics menu
    Falling-block game reached from Diagnostics, with button counters and
    inputs_tap() for driving it from the shell.
2026-11-07 firmware: MCUboot and mcumgr on both boards
    Built with sysbuild, the controller and the satellite boot through
    MCUboot (swap using offset, ECDSA P-256) and speak mcumgr's SMP over
    their USB shell, for a browser tool to read versions, upload and
    confirm images.
    - Kconfig.sysbuild in both boards selects MCUboot; native_sim and
    radiosim builds are unchanged. Each app's sysbuild.cmake adds
    common/mgmt/mcumgr.conf only when MCUboot is in the build.
    - Satellite flash: 40 KB MCUboot, two 232 KB slots, the 8 KB settings
    partition where it was. The GPIO/ADC/PWM shells move to bringup.conf
    to leave the app (now ~204 KB) room to grow.
    - MCUboot's console on the satellite is LPUART1 (J2), it ha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
    [board.c, main.c]
2026-11-07 firmware: board tag in signed images, mcumgr fixes from a sim test
    - The signed image carries the board name in custom TLV 0xa0, inside
    the protected (signed) area, so the browser tool can refuse an image
    built for the other board.
    - mcumgr.conf asks for an interrupt-driven shell UART: a polled shell
    backend never hands SMP frames to mcumgr and takes them for typed text.
    - Eight shell RX frame buffers instead of two. With two, a request of
    more than two console frames lost its tail when the frames arrived
    back to back; a 512-byte upload chunk is seven frames.
    Found by driving the browser tool's SMP client against a native_sim
    build over its pty (tools/webtool/scripts/simtest.ts).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
2026-11-07 tools/webtool: firmware updates and the shell in the browser
    A static page (Vue, Web Serial) that opens the USB port of the
    controller or a satellite, shows the shell in a terminal and talks
    mcumgr's SMP over the same stream: board, firmware version per slot,
    upload to slot 1, test boot, reset, reconnect, and waiting for the app
    to confirm the image. It refuses an image tagged for the other board,
    and offers going back to the image in the other slot.
    - src/smp: a small CBOR codec, the mcumgr console framing with a demux
    that separates shell text from SMP frames byte by byte, the SMP
    client, and a parser for signed MCUboot images (version, hash, board
    TLV). Unit tests run under node; s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
2026-11-07 firmware: ignition current log, downloaded over LoRa
    The satellite records the current through each fired channel during its
    fire pulses, and the controller can download and show the records.
    - Satellite (src/ignlog.c): DIA_EN goes high before the outputs, and the
    MCP3208 samples the TPS1HB08 SNS inputs (CH(5 - ch), 560 R, K_SNS 5000:
    7.19 mA per code) and V_PYRO every 1 ms, through adc_read() with a
    repeating callback, until 5 samples after the pulse. One record per
    channel and pulse; the last 8 are kept in __noinit RAM with CRCs, so
    they survive resets and the reboot through MCUboot (whose RAM ends
    well below the app's noinit section), not a power-off. sat ignlog
    [dump <seq>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
    [channels.c, commands.c, controller.c, controller.h, ignlog.c, ignlog.h]
2026-11-07 tools/webtool: ignition log panel
    Under the terminal, for a satellite or the controller on USB: the
    records of mcumgr group 64 (src/smp/ignlog.ts), and a chart of the
    current drawn like the memory LCD, with drag zoom, the first 50 ms,
    records laid over each other, and CSV export. On the controller,
    satellite tabs A-H and FETCH, which downloads a satellite's records
    over LoRa first. One request at a time, a few frames each, so the
    terminal stays usable; nothing is sent during a firmware upload.
    Unit tests in npm test; scripts/ignlog-simtest.ts fires two channels
    through the shell of a native_sim satellite with mcumgr and reads the
    records over SMP on the same pty.
2026-11-07 mcumgr: 6 KB work queue stack, progressive erase; tool waits out the swap
    Found updating the controller over USB:
    - The upload handler runs on mcumgr's work queue. With the default 2 KB
    stack the controller hung silently at the first chunk; the ESP32
    flash driver needs more. 6 KB now (both boards).
    - Erase slot 1 as the data arrives instead of all of it with the first
    chunk (5.9 MB on the controller).
    - The controller's USB Serial/JTAG port stays up through a reset, so
    the browser tool keeps its open port and asks for up to 90 s until
    the app answers, instead of giving up while MCUboot still swaps.
    On the controller: 794 KB upload in about 10 s, test boot, swap in
    about 15 s, con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
2026-11-07 satellite: MCUboot links for the boot partition again
    sysbuild/mcuboot.overlay replaces MCUboot's own app.overlay instead of
    adding to it, and that is where MCUboot picks the boot partition as its
    code partition. Without it MCUboot linked for slot 0: flashed at
    0x08000000, its reset vector pointed to 0x0800bff1 inside the app, and
    the satellite never got past reset. Repeat the chosen node here.
2026-11-07 satellite: reliable mcumgr over USB, found updating the board
    - CDC ACM with hw-flow-control: mcumgr writes its replies with
    uart_poll_out, and without flow control the driver drops those bytes
    when its TX FIFO is full; long replies behind shell log output
    arrived cut short.
    - mcuboot_util logs at warning level: its "Swap type: none" info line
    came with every slot query and landed between SMP frames.
    - board.c clears stale flash error flags at start-up (MCUboot and app).
    After a ROM DFU session the first flash write failed once.
    - The browser tool restarts an upload once after a flash write or
    erase error.
    On the satellite: 210 KB upload in about 6 s, swap about 15 s, the app
    co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
    [board.c]
2026-11-07 firmware: a shorted output arms and fires, with a warning
    A load that reads below 200 mOhm used to stop ARM on the satellite and
    the launch on the controller. Now it is the operator's call: the
    output still reads SHORT on the armed screen and the satellite's LEDs,
    but ARM goes ahead and FIRE drives it. The TPS1HB08's current limit
    (about 23.5 A with its 6k8 ILIM) and thermal shutdown protect the
    channel.
    The low-side FET proof does not depend on the load: a low side that
    conducts while off fails the measurement (-ERANGE) and still refuses
    ARM, as do open outputs and a failed high-side check. The satellite
    simulator in the controller follows the satellite.
    Checked in the controller's native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
    [commands.c, controller.c, controller.h, sat_sim.c]
2026-11-07 tools/webtool: update only forward, smaller chunks for old firmware
    Found testing the tool against the satellite:
    - UPDATE installed the published image whenever its hash differed,
    also an older build. It put this morning's satellite firmware (two
    console frame buffers, no CDC flow control) over a fixed one, which
    then dropped frames of every larger request ("Failed to alloc SMP
    buf"). The cap is now offered for a newer version only; an older or
    same-version image has to be chosen as a file.
    - An upload falls back to smaller chunks (down to 64 bytes) after two
    unanswered chunks in a row, so firmware with fewer frame buffers can
    still be updated. That is how the satellite got b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
