rckTom/alturia-launch-control/(notices)

Notices in the files:
hardware/satellite/pcb/satellite.kicad_pcb:
© 2026 Thomas Schmid · CERN-OHL-S-2.0
hardware/controller/pcb/controller.kicad_pcb:
Licence: CERN-OHL-S
